durveshpathak1989/ESP32-FlightStack/GCS/releases/README.md

# Ground Station Releases

## v6.0.0

`ESP32-FlightStack-Configurator-macOS-arm64.zip` contains the Drone GCS configuration application for Apple silicon Macs running macOS 13 or newer.

SHA-256:

```text
48610249d2b40f928e59468a9a488147b9eb7e8fd887d89ad847a3eb90f0dd22
```

Extract the archive and open `Drone GCS.app`. The application is built for the `arm64` architecture.
