durveshpathak1989/ESP32-FlightStack/docs/ARCHITECTURE.md

# FlightStack Architecture

## Goal

The flight algorithms should be understandable and testable without knowing
ESP32, Arduino, FreeRTOS, Wi-Fi, or a particular sensor library. Hardware and
microcontrollers are replaceable adapters around a portable C++ flight core.

## Dependency rule

Dependencies point inward:

```text
Board entry point / scheduler
            ↓
Platform adapters (ESP32, STM32, RP2040, host simulator)
            ↓
Core ports (interfaces) ← Application orchestration
            ↓
Flight algorithms, controllers, and plain data types
```

The `Core` directory must never include Arduino, ESP32, FreeRTOS, Wi-Fi, or a
concrete device driver. Platform adapters may depend on the core, never the
reverse.

## Directory layout (implemented)

```text
RC_FlightController/src/
├── Core/                      portable data + port contracts
│   ├── FlightTypes.h
│   ├── Ports.h
│   └── ImuTypes.h             shared IMU plain-data structs
├── Cfg/
│   └── FlightConfig.h         beginner-facing defaults and pins
├── App/                       application layer (algorithms only)
│   ├── Control/PidController.h
│   ├── Filters/NotchFilter/
│   └── Estimation/{EKF, AHRS, MahonyAHRS, Madgwick}
├── Services/
│   ├── Com/WiFiTelemetry      HTTP telemetry, tuning, OTA
│   ├── Calibration/CalManager
│   ├── SignalProcessing/FFT
│   └── Diagnostics/{Logger, DebugConfig, ESP32Core}
├── EcuAbstraction/
│   ├── Sensors/{IMU, BMP280, GPS, ToF}
│   ├── Actuators/MotorControl
│   ├── Receiver/iFly
│   └── Power/BatteryMonitor
└── Mcal/                      ESP32 Arduino core API boundary today
```

## Swapping hardware

A hardware implementation supplies the relevant port from `Core/Ports.h`:

- New IMU: implement `ImuPort`.
- New radio: implement `ReceiverPort`.
- PWM, DShot, or another ESC protocol: implement `MotorPort`.
- ESP32 NVS, STM32 flash, or a file in simulation: implement
  `ConfigurationStorePort`.
- New MCU timer: implement `ClockPort` and provide a scheduler adapter.

No controller should include a concrete driver header.

## Swapping microcontrollers

Create a platform folder containing:

1. clock and scheduler adapters;
2. synchronization primitives;
3. persistent storage;
4. networking/diagnostic transport, if available;
5. the composition root that constructs adapters and passes their interfaces
   to the application.

The portable core is built unchanged. A board that has no Wi-Fi can use a null
diagnostic adapter or a serial implementation.

## Adding a controller

Controllers will implement a stable control interface and consume only a
snapshot of pilot command, estimated state, and configuration. They return a
normalized motor command. They do not read sensors, write motors, allocate
memory, use global state, or perform network operations.

Controller selection belongs in one registry in the application layer. Adding
a controller should require:

1. one controller class;
2. one registry entry;
3. one configuration schema entry;
4. host-side unit tests.

## Safety constraints during migration

- Preserve the 400 Hz control period and task priorities.
- Perform no heap allocation in the armed control path.
- Keep motor stop and failsafe behavior independent of optional services.
- Validate configuration at the boundary before it reaches a controller.
- Persist only versioned and checksummed records while disarmed.
- Compile and compare resource usage after every extraction.
- Refactoring commits must not alter gains or flight equations unless explicitly
  labeled and tested as behavioral changes.

## Current migration status

The layered refactor (branch `refactor/autosar-layered`) vendored all
submodules into an AUTOSAR-style tree: `App/`, `Services/`,
`EcuAbstraction/`, `Mcal/`, with portable types and port contracts in
`Core/` and configuration in `Cfg/`. See `docs/LAYERS.md` for the layer
contracts and sanctioned exceptions. `FlightConfig.h` is the single
beginner-facing location for board pins and safe defaults.
`PidController.h` is portable standard C++. Remaining work: move direct
driver calls in the sketch behind `EcuAbstraction` adapters, and wrap
ESP32 peripheral APIs in explicit `Mcal` primitives.
