durveshpathak1989/ESP32-FlightStack/PCB/ESP32_FlightController/manufacturing/final-2026-07-22-r3/drill/drill-report.txt

Drill report for ESP32_FlightController.kicad_pcb
Created on 2026-07-22T15:09:06

Copper Layer Stackup:
    =============================================================
    L1 :  F.Cu                      front
    L2 :  GND_PLANE                 in1
    L3 :  POWER_PLANE               in2
    L4 :  B.Cu                      back

Drill file 'ESP32_FlightController-PTH.drl' contains
    plated through holes:
    =============================================================
    T1  0.200mm  0.0079"  (9 holes))
    T2  0.300mm  0.0118"  (95 holes))
    T3  0.600mm  0.0236"  (4 holes)  (with 4 slots)
    T4  0.650mm  0.0256"  (12 holes))
    T5  2.150mm  0.0846"  (2 holes))

    Total plated holes count 122

Drill file 'ESP32_FlightController-front-in1.drl' contains
    holes connecting layer pair: 'F.Cu and GND_PLANE' (blind vias):
    =============================================================
    T1  0.100mm  0.0039"  (23 holes))

    Total plated holes count 23

Drill file 'ESP32_FlightController-back-in2.drl' contains
    holes connecting layer pair: 'B.Cu and POWER_PLANE' (buried vias):
    =============================================================
    T1  0.100mm  0.0039"  (6 holes))

    Total plated holes count 6

Drill file 'ESP32_FlightController-NPTH.drl' contains
    unplated through holes:
    =============================================================
    T1  0.650mm  0.0256"  (2 holes))
    T2  4.000mm  0.1575"  (4 holes))

    Total unplated holes count 6
