durveshpathak1989/ESP32-FlightStack/docs/PROMOTION.md

# ESP32-FlightStack Promotion Kit

Use this file when setting GitHub metadata, sharing the project, or posting release updates.

## Short Description

ESP32-FlightStack is an open-source ESP32 quadcopter flight-control stack with IMU sensor fusion, cascaded PID stabilization, motor mixing, telemetry, OTA updates, logging, calibration, and a browser-based ground station.

## GitHub Topics

```text
esp32
quadcopter
drone
uav
flight-controller
flight-control
embedded-c
esp-idf
arduino
freertos
pid-controller
imu
sensor-fusion
attitude-estimation
mpu9250
bmp280
madgwick-filter
motor-control
esc
```

## SEO Keywords

```text
ESP32 drone library
ESP32 quadcopter flight controller
open-source drone stack
DIY quadcopter firmware
ESP32 flight control system
embedded drone control
IMU sensor fusion library
PID stabilization controller
quadcopter attitude estimation
ESP32 UAV framework
```

## One-Line Pitch

An ESP32-based quadcopter flight-control stack for makers and embedded developers who want real-time control, sensor fusion, telemetry, and OTA updates in one open project.

## Longer Pitch

ESP32-FlightStack turns a low-cost ESP32 board into a serious quadcopter research platform. It combines a 400 Hz FreeRTOS control loop, MPU-9250 IMU support, EKF/Mahony/Madgwick attitude estimation, cascaded PID control, ESC motor mixing, Wi-Fi telemetry, runtime tuning, onboard CSV logging, sensor calibration, OTA firmware upload, and a browser-based ground station.

## Social Post

I am building ESP32-FlightStack, an open-source quadcopter flight-control stack for DIY drones and embedded-systems research. It includes sensor fusion, cascaded PID stabilization, motor mixing, telemetry, OTA updates, onboard logging, calibration, and a browser-based ground station, all running on an ESP32.

## Communities To Share With

- GitHub Topics: ESP32, drone, quadcopter, flight-controller, sensor-fusion
- Reddit: r/esp32, r/diydrones, r/Multicopter, r/embedded
- Hackaday.io project log
- Arduino Project Hub
- ESP32 and drone Discord communities
- LinkedIn posts focused on embedded systems, FreeRTOS, and control systems

## Suggested GitHub Metadata

Repository name: `ESP32-FlightStack`

Description:

```text
ESP32 quadcopter flight-control stack with IMU sensor fusion, PID stabilization, telemetry, OTA updates, logging, calibration, and a browser GCS.
```
