durveshpathak1989/ESP32-FlightStack/PCB/ESP32_FlightController/renders/connector-check-top.png

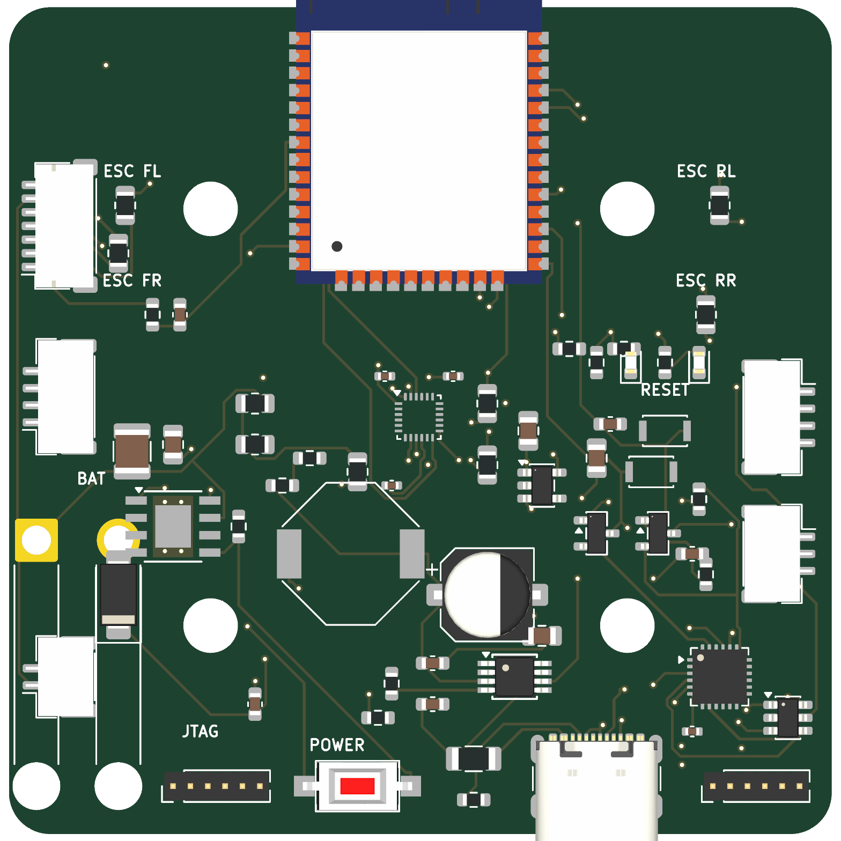
PCB/ESP32_FlightController/renders/connector-check-top.png
