durveshpathak1989/ESP32-FlightStack/3DPrints/StudSpacer-30mm.stl

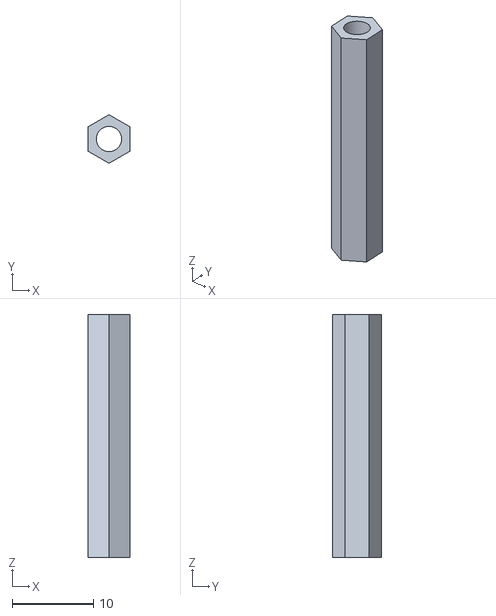
[picture p5: CAD file, 2026-05-16]
3DPrints/StudSpacer-30mm.stl
5.20 x 6.00 x 30.0
