durveshpathak1989/ESP32-FlightStack/3DPrints/StudSpacer-5mm.stl

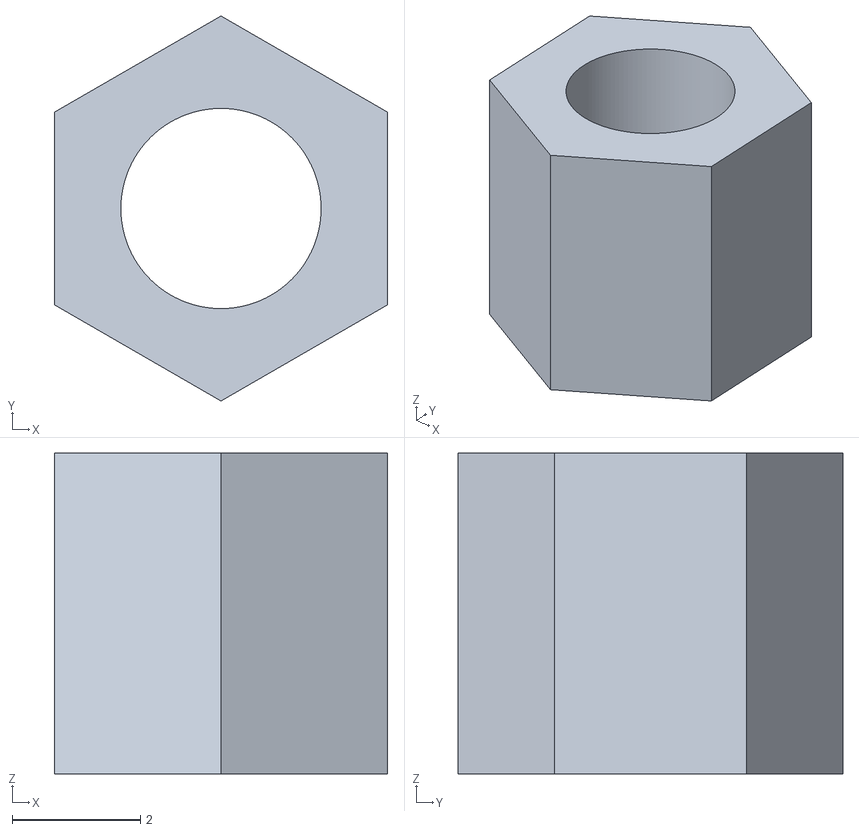
[picture p6: CAD file, 2026-05-16]
3DPrints/StudSpacer-5mm.stl
5.20 x 6.00 x 5.00
