durveshpathak1989/ESP32-FlightStack/3DPrints/StudSpacer-20mm.stl

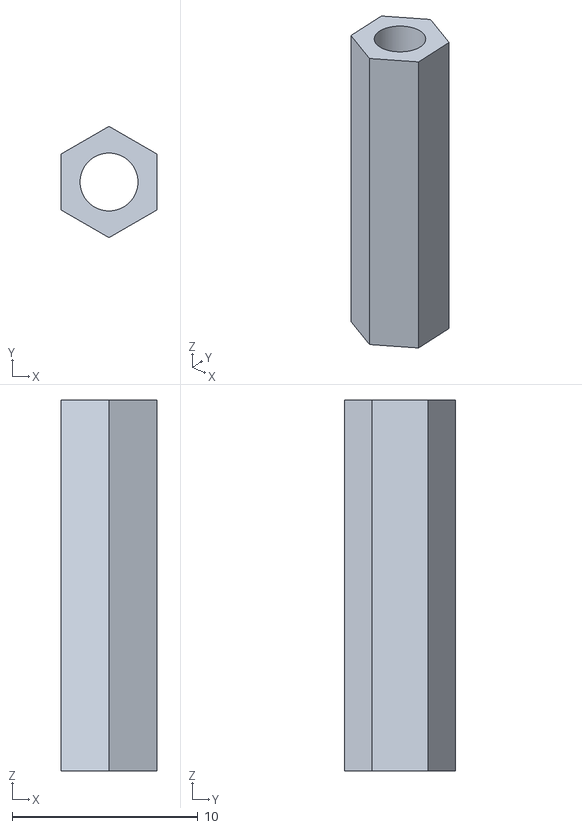
[picture p7: CAD file, 2026-05-16]
3DPrints/StudSpacer-20mm.stl
5.20 x 6.00 x 20.0
