durveshpathak1989/ESP32-FlightStack/3DPrints/StudSpacer-10mm.stl

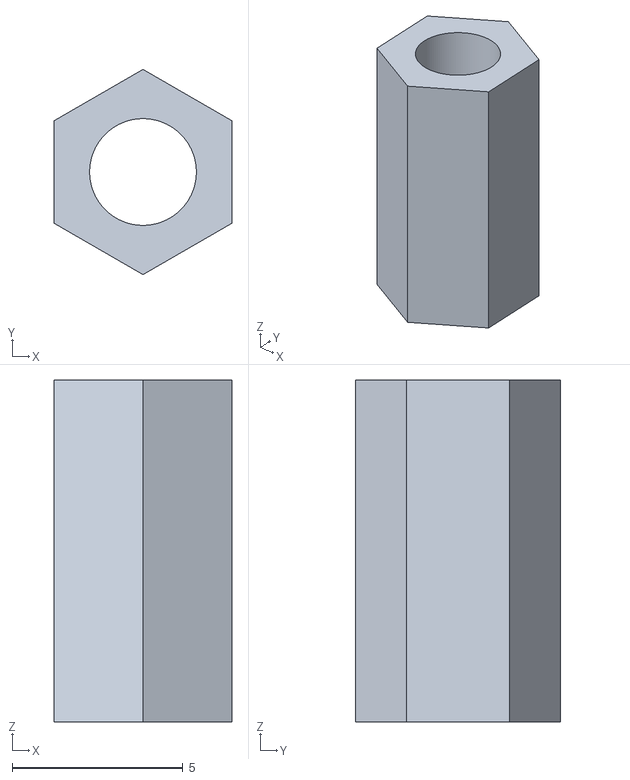
[picture p8: CAD file, 2026-05-16]
3DPrints/StudSpacer-10mm.stl
5.20 x 6.00 x 10.0
