durveshpathak1989/ESP32-FlightStack/RC_FlightController/build/BUILD_METRICS.md

# RC_FlightController Build Metrics

Generated: `2026-08-22T03:45:40.920803+00:00`
Source commit: `e3aa0521101f000fde28f85d92d8f98494c0851b`
Firmware: `RC_FlightController V6.1.0`
Build ID: `20260822T034345Z-master-e3aa0521101f`
Board: `ESP32 Dev Module`
Partition scheme: `min_spiffs` on 4 MB flash

| Variant | Flash used | Flash max | Flash % | RAM globals | RAM max | RAM % | RAM remaining |
|---|---:|---:|---:|---:|---:|---:|---:|
| Release | 1,146,599 | 1,966,080 | 58.0% | 77,596 | 327,680 | 23.0% | 250,084 |
| Debug | 1,158,147 | 1,966,080 | 58.0% | 77,604 | 327,680 | 23.0% | 250,076 |

See `build-metrics.json` for machine-readable details and `SHA256SUMS.txt` for binary integrity checks.
