durveshpathak1989/ESP32-FlightStack/PCB/ESP32_FlightController/manufacturing/final-2026-07-22-r3/review/board-bottom.png

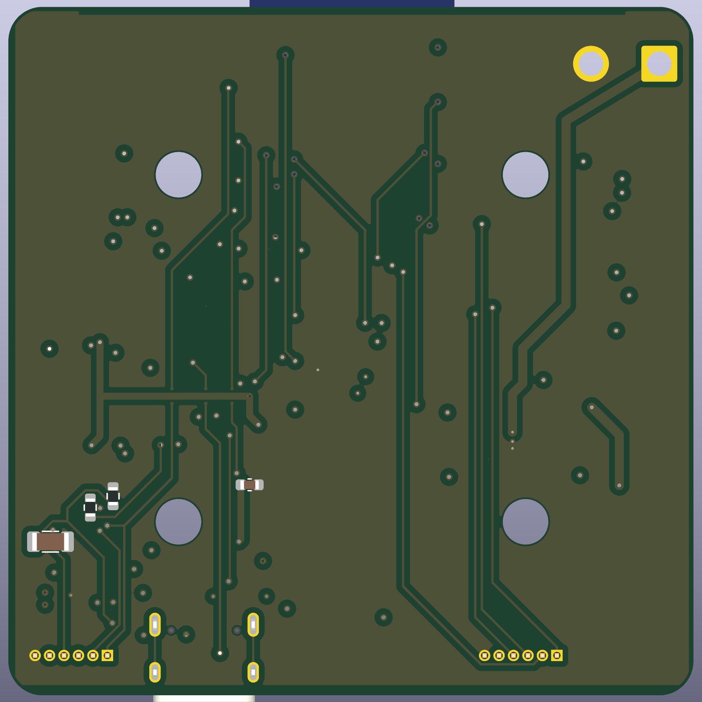
PCB/ESP32_FlightController/manufacturing/final-2026-07-22-r3/review/board-bottom.png
