durveshpathak1989/ESP32-FlightStack/Simulation/TestScreen_OTA_upload.html

# ESP32 Drone Ground Station | CONNECTING... | 0 rows ⏺ Start Logging ⬇ Download CSV ✕ Clear

Dashboard

Test 7.1 Timing

Test 7.2 RC Failsafe

Test 7.3 Telem Rate

Test 7.4 Calibration

Test 7.5 PID Tune

Test 7.6 BMP280

Test 7.7 CPU Load

OTA Firmware

### Mode

—

### Roll

—

degrees

### Pitch

—

degrees

### Yaw

—

degrees

### Throttle

—

### RC Hz

—

### Core 0

—

### Core 1

—

### BMP Temp

—

°C

### BMP Pressure

—

hPa

### BMP Altitude

—

m

### GPS

—

### IMU Loops

—

### WiFi Requests

—

### Motors

### FL (GPIO25 CCW)

—

### FR (GPIO15 CW)

—

### RL (GPIO14 CW)

—

### RR (GPIO32 CCW)

—

### 📋 Session Log 0 rows recorded

### Test 7.1 — IMU Loop Timing Characterization

Measures jitter of the 500 Hz IMU loop (target 2000 µs period). Run 5 minutes per condition. Reset stats between conditions.

Condition: Reset Stats Start 5-min Timer Download CSV

00:00

### Samples

—

### Period Mean

—

µs (target 2000)

### Period Std Dev

—

µs

### Jitter Mean

—

µs

### Jitter Max

—

µs

### Jitter p99

—

µs

### Violations (>100µs)

—

### Pass / Fail

—

### Results Table (fill in after each condition)

Condition | Samples | Period Mean µs | Std Dev µs | Jitter Mean µs | Jitter p99 µs | Jitter Max µs | Violations | Pass?
A — Idle | — | — | — | — | — | — | — | —
B — Polling | — | — | — | — | — | — | — | —
C — Stress | — | — | — | — | — | — | — | —

Save Current Row

### Test 7.2 — RC Frame Rate and Failsafe

Verify iBUS frames arrive at ~142 Hz and failsafe fires within 500 ms of TX off.

TX OFF — Start Timer Reset

Waiting for TX-OFF...

### RC Frame Rate

—

Hz (pass: 70–95)

### RC Valid

—

### Flight Mode

—

### Failsafe Detected

Waiting...

### Time to Failsafe

—

ms (pass: <500 ms)

### Result

—

### Pass Criteria

Check | Criterion | Measured | Pass?
RC frame rate | 70–95 Hz | — | —
Failsafe time | < 500 ms after TX off | — | —
Mode = FAILSAFE | Yes | — | —

### Test 7.3 — Telemetry Delivery Rate

Measures actual HTTP response rate over 60 seconds. Pass: ≥10 Hz, error rate <5%.

Start 60-sec Measurement Reset

00:00

### Successful Responses

—

### Errors

—

### Measured Rate

—

Hz (pass: ≥10)

### Error Rate

—

% (pass: <5%)

### Min Latency

—

ms

### Max Latency

—

ms

### Avg Latency

—

ms

### Result

—

### Test 7.4 — RC-Triggered Calibration

Verify field calibration works without USB. Trigger by flipping SWD (CH10) UP while disarmed.

Poll Log Now Clear

Waiting for calibration...

### Calibration Log (live from /log)

### Pass Criteria

Check | Required Log Message | Seen?
Triggered via SWD | [RC] Calibration requested — SWD flipped UP | No
Gyro complete | [CAL] ✓ GYRO done | No
Accel complete | [CAL] ✓ ACCEL done | No
Mag (or skipped) | [CAL] ✓ MAG done OR SKIPPED | No
Saved to NVS | [CAL] ✓ Calibration COMPLETE — saved to NVS | No

Overall: Incomplete

### Test 7.5 — Runtime Tuning Levers

Sends the full tuning set to /tune. Use while DISARMED first. This panel now covers pilot limits, PID authority, throttle shaping, rate PID, angle PID, yaw hold, Mahony AHRS, and ToF altitude hold.

### Command Limits

max_angle_deg

max_rate_dps

yaw_max_rate_dps

yaw_deadband

### Output Authority

roll_output_limit

pitch_output_limit

yaw_output_limit

### Throttle Shaping

throttle_expo

throttle_up_rate_per_sec

throttle_down_rate_per_sec

motor_idle

motor_max

throttle_cut

idle_ramp_end

### Rate PID

pid_roll_kp

pid_roll_ki

pid_roll_kd

pid_pitch_kp

pid_pitch_ki

pid_pitch_kd

pid_yaw_kp

pid_yaw_ki

pid_yaw_kd

### Angle PID

pid_angle_roll_kp

pid_angle_roll_ki

pid_angle_roll_kd

pid_angle_pitch_kp

pid_angle_pitch_ki

pid_angle_pitch_kd

### Yaw Hold

pid_angle_yaw_kp

### AHRS

mahony_kp

mahony_ki

### ToF Altitude Hold

alt_hold_kp

alt_hold_kd

alt_hold_max_trim

Send All Tuning Levers (Disarmed Test) Send While Armed Test

### Active Tuning Values (from /telemetry, if firmware exposes them)

### Max Angle

—

### Max Rate

—

### Roll Out Lim

—

### Thr Expo

—

### Roll Kp

—

### Roll Ki

—

### Roll Kd

—

### Pitch Kp

—

### Yaw Kp

—

### Ang Roll Kp

—

### Ang Pitch Kp

—

### Yaw Hold Kp

—

### Mahony Kp

—

### Mahony Ki

—

### Alt Hold Kp

—

### Alt Hold Kd

—

### Alt Max Trim

—

### Alt Hold State

—

### Pass Criteria

Test | Expected | Result | Pass?
Send while DISARMED | Tuning payload accepted, telemetry shows at least one changed value | — | —
Send while ARMED | Rejected — values unchanged | — | —

### Test 7.6 — BMP280 Barometer

Verify pressure and altitude readings are plausible. Lift drone ~1 m to check altitude response.

Snapshot at Current Height Snapshot at +1m Height Reset

### BMP Valid

—

### Temperature

—

°C

### Pressure

—

hPa

### Altitude (live)

—

m

### Baseline Alt

—

m (snapshotted)

### High Alt

—

m (snapshotted)

### Δ Altitude

—

m (expect ~1.0)

### Result

—

### Pass Criteria

Check | Criterion | Measured | Pass?
bmpValid = true | true | — | —
Temperature | 10–45 °C | — | —
Pressure | 950–1050 hPa | — | —
1m lift → ~1m delta | 0.5–2.0 m | — | —

### Test 7.7 — CPU Utilization Baseline

Record Core 0 and Core 1 load over 60 seconds. Pass: Core 1 <80%, neither core at 100%.

Start 60-sec Recording Reset Download CSV

00:00

### Core 0 Now

—

### Core 1 Now

—

### Core 0 Peak

—

### Core 1 Peak

—

### Core 0 Mean

—

### Core 1 Mean

—

### Samples

—

### Result

—

### Pass Criteria

Check | Criterion | Measured | Pass?
Core 0 peak | < 80% | — | —
Core 1 peak | < 80% | — | —
Neither core at 100% | Max < 100% | — | —

### OTA Firmware Upload

Upload the Arduino-exported ESP32 application .bin file to /update. Use only while DISARMED, throttle low, and motors stopped. Remove propellers during bench updates.

Target: http://192.168.4.1/update Safety: waiting for telemetry

⬆

Drop firmware .bin here or choose file

No file selected

Upload .bin to ESP32 Open /update Page

Waiting for .bin file.

### How to create the .bin from Arduino IDE

Step | Action
1 | Select the correct ESP32 board and port.
2 | Select an OTA-capable partition scheme, for example “Default 4MB with OTA”.
3 | Flash the OTA-capable firmware once over USB.
4 | Use Sketch → Export Compiled Binary.
5 | Use Sketch → Show Sketch Folder and pick the generated app .bin, typically YourSketch.ino.bin.
6 | Do not use bootloader, partitions, or merged factory .bin for this OTA upload.
