durveshpathak1989/ESP32-FlightStack/docs/images/testscreen-ota.png

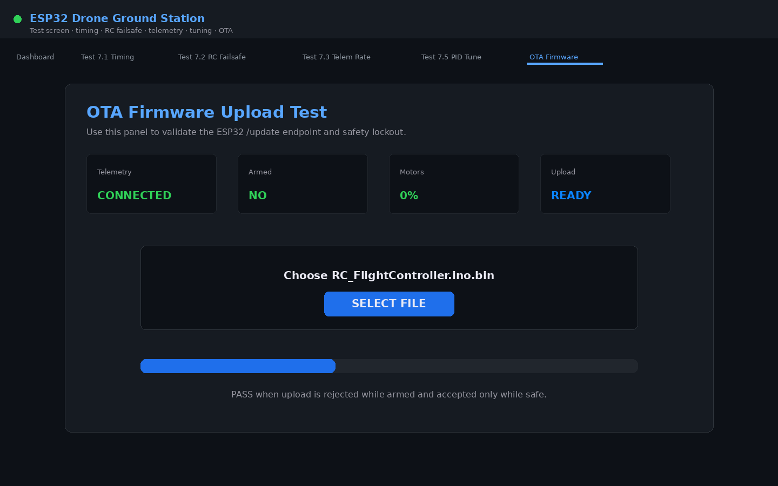
docs/images/testscreen-ota.png
