durveshpathak1989/ESP32-FlightStack/RC_FlightController/build/compile-debug.txt

/home/runner/work/ESP32-FlightStack/ESP32-FlightStack/RC_FlightController/RC_FlightController.ino: In function 'void updateExecTimingAndPrint(uint32_t, uint32_t, uint32_t, uint32_t)':
/home/runner/work/ESP32-FlightStack/ESP32-FlightStack/RC_FlightController/RC_FlightController.ino:133:22: warning: '++' expression of 'volatile'-qualified type is deprecated [-Wvolatile]
  133 |         g_execTiming.controlOverruns++;
      |         ~~~~~~~~~~~~~^~~~~~~~~~~~~~~
/home/runner/work/ESP32-FlightStack/ESP32-FlightStack/RC_FlightController/RC_FlightController.ino:137:22: warning: '++' expression of 'volatile'-qualified type is deprecated [-Wvolatile]
  137 |         g_execTiming.fullOverruns++;
      |         ~~~~~~~~~~~~~^~~~~~~~~~~~
/home/runner/work/ESP32-FlightStack/ESP32-FlightStack/RC_FlightController/RC_FlightController.ino: In function 'void updateControlTransitionCounters(const RCCommand&)':
/home/runner/work/ESP32-FlightStack/ESP32-FlightStack/RC_FlightController/RC_FlightController.ino:861:9: warning: '++' expression of 'volatile'-qualified type is deprecated [-Wvolatile]
  861 |         g_modeTransitionCount++;
      |         ^~~~~~~~~~~~~~~~~~~~~
/home/runner/work/ESP32-FlightStack/ESP32-FlightStack/RC_FlightController/RC_FlightController.ino:868:9: warning: '++' expression of 'volatile'-qualified type is deprecated [-Wvolatile]
  868 |         g_armingTransitionCount++;
      |         ^~~~~~~~~~~~~~~~~~~~~~~
/home/runner/work/ESP32-FlightStack/ESP32-FlightStack/RC_FlightController/RC_FlightController.ino:873:21: warning: '++' expression of 'volatile'-qualified type is deprecated [-Wvolatile]
  873 |     if (resetEvent) g_pidResetCount++;
      |                     ^~~~~~~~~~~~~~~
/home/runner/work/ESP32-FlightStack/ESP32-FlightStack/RC_FlightController/RC_FlightController.ino: In function 'bool handleTune(const TunePacket&)':
/home/runner/work/ESP32-FlightStack/ESP32-FlightStack/RC_FlightController/RC_FlightController.ino:1091:9: warning: '++' expression of 'volatile'-qualified type is deprecated [-Wvolatile]
 1091 |         g_tuneRejectSeq++;
      |         ^~~~~~~~~~~~~~~
/home/runner/work/ESP32-FlightStack/ESP32-FlightStack/RC_FlightController/RC_FlightController.ino:1097:9: warning: '++' expression of 'volatile'-qualified type is deprecated [-Wvolatile]
 1097 |         g_tuneRejectSeq++;
      |         ^~~~~~~~~~~~~~~
/home/runner/work/ESP32-FlightStack/ESP32-FlightStack/RC_FlightController/RC_FlightController.ino:1168:5: warning: '++' expression of 'volatile'-qualified type is deprecated [-Wvolatile]
 1168 |     g_tuneRequestSeq++;
      |     ^~~~~~~~~~~~~~~~
In file included from /home/runner/work/ESP32-FlightStack/ESP32-FlightStack/RC_FlightController/RC_FlightController.ino:52:
/home/runner/work/ESP32-FlightStack/ESP32-FlightStack/RC_FlightController/RC_FlightController.ino: In function 'void setup()':
/home/runner/work/ESP32-FlightStack/ESP32-FlightStack/RC_FlightController/RC_FlightController.ino:3236:16: warning: format '%u' expects argument of type 'unsigned int', but argument 3 has type 'uint32_t' {aka 'long unsigned int'} [-Wformat=]
 3236 |     DBG_PRINTF("[BOOT] Free heap: %u bytes\n", ESP.getFreeHeap());
      |                ^~~~~~~~~~~~~~~~~~~~~~~~~~~~~~  ~~~~~~~~~~~~~~~~~
      |                                                               |
      |                                                               uint32_t {aka long unsigned int}
/home/runner/work/ESP32-FlightStack/ESP32-FlightStack/RC_FlightController/src/Submodules/DebugConfig/DebugConfig.h:27:40: note: in definition of macro 'DBG_PRINTF'
   27 | #define DBG_PRINTF(...)  Serial.printf(__VA_ARGS__)
      |                                        ^~~~~~~~~~~
/home/runner/work/ESP32-FlightStack/ESP32-FlightStack/RC_FlightController/RC_FlightController.ino: At global scope:
/home/runner/work/ESP32-FlightStack/ESP32-FlightStack/RC_FlightController/RC_FlightController.ino:202:17: warning: 'g_lastDynamicNotchUpdateMs' defined but not used [-Wunused-variable]
  202 | static uint32_t g_lastDynamicNotchUpdateMs = 0;
      |                 ^~~~~~~~~~~~~~~~~~~~~~~~~~
/home/runner/work/ESP32-FlightStack/ESP32-FlightStack/RC_FlightController/RC_FlightController.ino:201:17: warning: 'g_dynamicNotchTracking' defined but not used [-Wunused-variable]
  201 | static bool     g_dynamicNotchTracking = false;
      |                 ^~~~~~~~~~~~~~~~~~~~~~
/home/runner/work/ESP32-FlightStack/ESP32-FlightStack/RC_FlightController/RC_FlightController.ino:200:17: warning: 'g_dynamicNotchHz' defined but not used [-Wunused-variable]
  200 | static float    g_dynamicNotchHz = TUNE_NOTCH_FREQ_HZ;
      |                 ^~~~~~~~~~~~~~~~
/home/runner/work/ESP32-FlightStack/ESP32-FlightStack/RC_FlightController/RC_FlightController.ino: In function 'void taskSerial(void*)':
/home/runner/work/ESP32-FlightStack/ESP32-FlightStack/RC_FlightController/src/Submodules/DebugConfig/DebugConfig.h:27:39: warning: 's.FlightState::roll_deg' may be used uninitialized [-Wmaybe-uninitialized]
   27 | #define DBG_PRINTF(...)  Serial.printf(__VA_ARGS__)
/home/runner/work/ESP32-FlightStack/ESP32-FlightStack/RC_FlightController/RC_FlightController.ino:2853:13: note: in expansion of macro 'DBG_PRINTF'
 2853 |             DBG_PRINTF("[%6lu] %s | RAW R=%+6.1f P=%+6.1f Y=%6.1f | "
      |             ^~~~~~~~~~
/home/runner/work/ESP32-FlightStack/ESP32-FlightStack/RC_FlightController/RC_FlightController.ino:2838:21: note: 's.FlightState::roll_deg' was declared here
 2838 |         FlightState s;
      |                     ^
/home/runner/work/ESP32-FlightStack/ESP32-FlightStack/RC_FlightController/src/Submodules/DebugConfig/DebugConfig.h:27:39: warning: 's.FlightState::pitch_deg' may be used uninitialized [-Wmaybe-uninitialized]
   27 | #define DBG_PRINTF(...)  Serial.printf(__VA_ARGS__)
/home/runner/work/ESP32-FlightStack/ESP32-FlightStack/RC_FlightController/RC_FlightController.ino:2853:13: note: in expansion of macro 'DBG_PRINTF'
 2853 |             DBG_PRINTF("[%6lu] %s | RAW R=%+6.1f P=%+6.1f Y=%6.1f | "
      |             ^~~~~~~~~~
/home/runner/work/ESP32-FlightStack/ESP32-FlightStack/RC_FlightController/RC_FlightController.ino:2838:21: note: 's.FlightState::pitch_deg' was declared here
 2838 |         FlightState s;
      |                     ^
/home/runner/work/ESP32-FlightStack/ESP32-FlightStack/RC_FlightController/src/Submodules/DebugConfig/DebugConfig.h:27:39: warning: 's.FlightState::yaw_deg' may be used uninitialized [-Wmaybe-uninitialized]
   27 | #define DBG_PRINTF(...)  Serial.printf(__VA_ARGS__)
/home/runner/work/ESP32-FlightStack/ESP32-FlightStack/RC_FlightController/RC_FlightController.ino:2853:13: note: in expansion of macro 'DBG_PRINTF'
 2853 |             DBG_PRINTF("[%6lu] %s | RAW R=%+6.1f P=%+6.1f Y=%6.1f | "
      |             ^~~~~~~~~~
/home/runner/work/ESP32-FlightStack/ESP32-FlightStack/RC_FlightController/RC_FlightController.ino:2838:21: note: 's.FlightState::yaw_deg' was declared here
 2838 |         FlightState s;
      |                     ^
/home/runner/work/ESP32-FlightStack/ESP32-FlightStack/RC_FlightController/src/Submodules/DebugConfig/DebugConfig.h:27:39: warning: 's.FlightState::ahrsFilterMode' may be used uninitialized [-Wmaybe-uninitialized]
   27 | #define DBG_PRINTF(...)  Serial.printf(__VA_ARGS__)
/home/runner/work/ESP32-FlightStack/ESP32-FlightStack/RC_FlightController/RC_FlightController.ino:2853:13: note: in expansion of macro 'DBG_PRINTF'
 2853 |             DBG_PRINTF("[%6lu] %s | RAW R=%+6.1f P=%+6.1f Y=%6.1f | "
      |             ^~~~~~~~~~
/home/runner/work/ESP32-FlightStack/ESP32-FlightStack/RC_FlightController/RC_FlightController.ino:2838:21: note: 's.FlightState::ahrsFilterMode' was declared here
 2838 |         FlightState s;
      |                     ^
/home/runner/work/ESP32-FlightStack/ESP32-FlightStack/RC_FlightController/src/Submodules/DebugConfig/DebugConfig.h:27:39: warning: 's.FlightState::roll_ctrl_deg' may be used uninitialized [-Wmaybe-uninitialized]
   27 | #define DBG_PRINTF(...)  Serial.printf(__VA_ARGS__)
/home/runner/work/ESP32-FlightStack/ESP32-FlightStack/RC_FlightController/RC_FlightController.ino:2853:13: note: in expansion of macro 'DBG_PRINTF'
 2853 |             DBG_PRINTF("[%6lu] %s | RAW R=%+6.1f P=%+6.1f Y=%6.1f | "
      |             ^~~~~~~~~~
/home/runner/work/ESP32-FlightStack/ESP32-FlightStack/RC_FlightController/RC_FlightController.ino:2838:21: note: 's.FlightState::roll_ctrl_deg' was declared here
 2838 |         FlightState s;
      |                     ^
/home/runner/work/ESP32-FlightStack/ESP32-FlightStack/RC_FlightController/src/Submodules/DebugConfig/DebugConfig.h:27:39: warning: 's.FlightState::pitch_ctrl_deg' may be used uninitialized [-Wmaybe-uninitialized]
   27 | #define DBG_PRINTF(...)  Serial.printf(__VA_ARGS__)
/home/runner/work/ESP32-FlightStack/ESP32-FlightStack/RC_FlightController/RC_FlightController.ino:2853:13: note: in expansion of macro 'DBG_PRINTF'
 2853 |             DBG_PRINTF("[%6lu] %s | RAW R=%+6.1f P=%+6.1f Y=%6.1f | "
      |             ^~~~~~~~~~
/home/runner/work/ESP32-FlightStack/ESP32-FlightStack/RC_FlightController/RC_FlightController.ino:2838:21: note: 's.FlightState::pitch_ctrl_deg' was declared here
 2838 |         FlightState s;
      |                     ^
/home/runner/work/ESP32-FlightStack/ESP32-FlightStack/RC_FlightController/src/Submodules/DebugConfig/DebugConfig.h:27:39: warning: 's.FlightState::yaw_ctrl_deg' may be used uninitialized [-Wmaybe-uninitialized]
   27 | #define DBG_PRINTF(...)  Serial.printf(__VA_ARGS__)
/home/runner/work/ESP32-FlightStack/ESP32-FlightStack/RC_FlightController/RC_FlightController.ino:2853:13: note: in expansion of macro 'DBG_PRINTF'
 2853 |             DBG_PRINTF("[%6lu] %s | RAW R=%+6.1f P=%+6.1f Y=%6.1f | "
      |             ^~~~~~~~~~
/home/runner/work/ESP32-FlightStack/ESP32-FlightStack/RC_FlightController/RC_FlightController.ino:2838:21: note: 's.FlightState::yaw_ctrl_deg' was declared here
 2838 |         FlightState s;
      |                     ^
/home/runner/work/ESP32-FlightStack/ESP32-FlightStack/RC_FlightController/src/Submodules/DebugConfig/DebugConfig.h:27:39: warning: 's.FlightState::roll_offset_deg' may be used uninitialized [-Wmaybe-uninitialized]
   27 | #define DBG_PRINTF(...)  Serial.printf(__VA_ARGS__)
/home/runner/work/ESP32-FlightStack/ESP32-FlightStack/RC_FlightController/RC_FlightController.ino:2853:13: note: in expansion of macro 'DBG_PRINTF'
 2853 |             DBG_PRINTF("[%6lu] %s | RAW R=%+6.1f P=%+6.1f Y=%6.1f | "
      |             ^~~~~~~~~~
/home/runner/work/ESP32-FlightStack/ESP32-FlightStack/RC_FlightController/RC_FlightController.ino:2838:21: note: 's.FlightState::roll_offset_deg' was declared here
 2838 |         FlightState s;
      |                     ^
/home/runner/work/ESP32-FlightStack/ESP32-FlightStack/RC_FlightController/src/Submodules/DebugConfig/DebugConfig.h:27:39: warning: 's.FlightState::pitch_offset_deg' may be used uninitialized [-Wmaybe-uninitialized]
   27 | #define DBG_PRINTF(...)  Serial.printf(__VA_ARGS__)
/home/runner/work/ESP32-FlightStack/ESP32-FlightStack/RC_FlightController/RC_FlightController.ino:2853:13: note: in expansion of macro 'DBG_PRINTF'
 2853 |             DBG_PRINTF("[%6lu] %s | RAW R=%+6.1f P=%+6.1f Y=%6.1f | "
      |             ^~~~~~~~~~
/home/runner/work/ESP32-FlightStack/ESP32-FlightStack/RC_FlightController/RC_FlightController.ino:2838:21: note: 's.FlightState::pitch_offset_deg' was declared here
 2838 |         FlightState s;
      |                     ^
/home/runner/work/ESP32-FlightStack/ESP32-FlightStack/RC_FlightController/src/Submodules/DebugConfig/DebugConfig.h:27:39: warning: 's.FlightState::yaw_offset_deg' may be used uninitialized [-Wmaybe-uninitialized]
   27 | #define DBG_PRINTF(...)  Serial.printf(__VA_ARGS__)
/home/runner/work/ESP32-FlightStack/ESP32-FlightStack/RC_FlightController/RC_FlightController.ino:2853:13: note: in expansion of macro 'DBG_PRINTF'
 2853 |             DBG_PRINTF("[%6lu] %s | RAW R=%+6.1f P=%+6.1f Y=%6.1f | "
      |             ^~~~~~~~~~
/home/runner/work/ESP32-FlightStack/ESP32-FlightStack/RC_FlightController/RC_FlightController.ino:2838:21: note: 's.FlightState::yaw_offset_deg' was declared here
 2838 |         FlightState s;
      |                     ^
/home/runner/work/ESP32-FlightStack/ESP32-FlightStack/RC_FlightController/src/Submodules/DebugConfig/DebugConfig.h:27:39: warning: 's.FlightState::ax_g' may be used uninitialized [-Wmaybe-uninitialized]
   27 | #define DBG_PRINTF(...)  Serial.printf(__VA_ARGS__)
/home/runner/work/ESP32-FlightStack/ESP32-FlightStack/RC_FlightController/RC_FlightController.ino:2883:13: note: in expansion of macro 'DBG_PRINTF'
 2883 |             DBG_PRINTF("          SENS: acc=%+.4f %+.4f %+.4f g | "
      |             ^~~~~~~~~~
/home/runner/work/ESP32-FlightStack/ESP32-FlightStack/RC_FlightController/RC_FlightController.ino:2838:21: note: 's.FlightState::ax_g' was declared here
 2838 |         FlightState s;
      |                     ^
/home/runner/work/ESP32-FlightStack/ESP32-FlightStack/RC_FlightController/src/Submodules/DebugConfig/DebugConfig.h:27:39: warning: 's.FlightState::ay_g' may be used uninitialized [-Wmaybe-uninitialized]
   27 | #define DBG_PRINTF(...)  Serial.printf(__VA_ARGS__)
/home/runner/work/ESP32-FlightStack/ESP32-FlightStack/RC_FlightController/RC_FlightController.ino:2883:13: note: in expansion of macro 'DBG_PRINTF'
 2883 |             DBG_PRINTF("          SENS: acc=%+.4f %+.4f %+.4f g | "
      |             ^~~~~~~~~~
/home/runner/work/ESP32-FlightStack/ESP32-FlightStack/RC_FlightController/RC_FlightController.ino:2838:21: note: 's.FlightState::ay_g' was declared here
 2838 |         FlightState s;
      |                     ^
/home/runner/work/ESP32-FlightStack/ESP32-FlightStack/RC_FlightController/src/Submodules/DebugConfig/DebugConfig.h:27:39: warning: 's.FlightState::az_g' may be used uninitialized [-Wmaybe-uninitialized]
   27 | #define DBG_PRINTF(...)  Serial.printf(__VA_ARGS__)
/home/runner/work/ESP32-FlightStack/ESP32-FlightStack/RC_FlightController/RC_FlightController.ino:2883:13: note: in expansion of macro 'DBG_PRINTF'
 2883 |             DBG_PRINTF("          SENS: acc=%+.4f %+.4f %+.4f g | "
      |             ^~~~~~~~~~
/home/runner/work/ESP32-FlightStack/ESP32-FlightStack/RC_FlightController/RC_FlightController.ino:2838:21: note: 's.FlightState::az_g' was declared here
 2838 |         FlightState s;
      |                     ^
/home/runner/work/ESP32-FlightStack/ESP32-FlightStack/RC_FlightController/src/Submodules/DebugConfig/DebugConfig.h:27:39: warning: 's.FlightState::gx_dps' may be used uninitialized [-Wmaybe-uninitialized]
   27 | #define DBG_PRINTF(...)  Serial.printf(__VA_ARGS__)
/home/runner/work/ESP32-FlightStack/ESP32-FlightStack/RC_FlightController/RC_FlightController.ino:2883:13: note: in expansion of macro 'DBG_PRINTF'
 2883 |             DBG_PRINTF("          SENS: acc=%+.4f %+.4f %+.4f g | "
      |             ^~~~~~~~~~
/home/runner/work/ESP32-FlightStack/ESP32-FlightStack/RC_FlightController/RC_FlightController.ino:2838:21: note: 's.FlightState::gx_dps' was declared here
 2838 |         FlightState s;
      |                     ^
/home/runner/work/ESP32-FlightStack/ESP32-FlightStack/RC_FlightController/src/Submodules/DebugConfig/DebugConfig.h:27:39: warning: 's.FlightState::gy_dps' may be used uninitialized [-Wmaybe-uninitialized]
   27 | #define DBG_PRINTF(...)  Serial.printf(__VA_ARGS__)
/home/runner/work/ESP32-FlightStack/ESP32-FlightStack/RC_FlightController/RC_FlightController.ino:2883:13: note: in expansion of macro 'DBG_PRINTF'
 2883 |             DBG_PRINTF("          SENS: acc=%+.4f %+.4f %+.4f g | "
      |             ^~~~~~~~~~
/home/runner/work/ESP32-FlightStack/ESP32-FlightStack/RC_FlightController/RC_FlightController.ino:2838:21: note: 's.FlightState::gy_dps' was declared here
 2838 |         FlightState s;
      |                     ^
/home/runner/work/ESP32-FlightStack/ESP32-FlightStack/RC_FlightController/src/Submodules/DebugConfig/DebugConfig.h:27:39: warning: 's.FlightState::gz_dps' may be used uninitialized [-Wmaybe-uninitialized]
   27 | #define DBG_PRINTF(...)  Serial.printf(__VA_ARGS__)
/home/runner/work/ESP32-FlightStack/ESP32-FlightStack/RC_FlightController/RC_FlightController.ino:2883:13: note: in expansion of macro 'DBG_PRINTF'
 2883 |             DBG_PRINTF("          SENS: acc=%+.4f %+.4f %+.4f g | "
      |             ^~~~~~~~~~
/home/runner/work/ESP32-FlightStack/ESP32-FlightStack/RC_FlightController/RC_FlightController.ino:2838:21: note: 's.FlightState::gz_dps' was declared here
 2838 |         FlightState s;
      |                     ^
/home/runner/work/ESP32-FlightStack/ESP32-FlightStack/RC_FlightController/RC_FlightController.ino:2879:53: warning: 's.FlightState::mx_uT' may be used uninitialized [-Wmaybe-uninitialized]
 2879 |             float magNorm = sqrtf(s.mx_uT * s.mx_uT +
      |                                   ~~~~~~~~~~~~~~~~~~^
 2880 |                       s.my_uT * s.my_uT +
      |                       ~~~~~~~~~~~~~~~~~              
/home/runner/work/ESP32-FlightStack/ESP32-FlightStack/RC_FlightController/RC_FlightController.ino:2838:21: note: 's.FlightState::mx_uT' was declared here
 2838 |         FlightState s;
      |                     ^
/home/runner/work/ESP32-FlightStack/ESP32-FlightStack/RC_FlightController/src/Submodules/DebugConfig/DebugConfig.h:27:39: warning: 's.FlightState::my_uT' may be used uninitialized [-Wmaybe-uninitialized]
   27 | #define DBG_PRINTF(...)  Serial.printf(__VA_ARGS__)
/home/runner/work/ESP32-FlightStack/ESP32-FlightStack/RC_FlightController/RC_FlightController.ino:2883:13: note: in expansion of macro 'DBG_PRINTF'
 2883 |             DBG_PRINTF("          SENS: acc=%+.4f %+.4f %+.4f g | "
      |             ^~~~~~~~~~
/home/runner/work/ESP32-FlightStack/ESP32-FlightStack/RC_FlightController/RC_FlightController.ino:2838:21: note: 's.FlightState::my_uT' was declared here
 2838 |         FlightState s;
      |                     ^
/home/runner/work/ESP32-FlightStack/ESP32-FlightStack/RC_FlightController/RC_FlightController.ino:2879:34: warning: 's.FlightState::mz_uT' may be used uninitialized [-Wmaybe-uninitialized]
 2879 |             float magNorm = sqrtf(s.mx_uT * s.mx_uT +
      |                             ~~~~~^~~~~~~~~~~~~~~~~~~~
 2880 |                       s.my_uT * s.my_uT +
      |                       ~~~~~~~~~~~~~~~~~~~
 2881 |                       s.mz_uT * s.mz_uT);
      |                       ~~~~~~~~~~~~~~~~~~
/home/runner/work/ESP32-FlightStack/ESP32-FlightStack/RC_FlightController/RC_FlightController.ino:2838:21: note: 's.FlightState::mz_uT' was declared here
 2838 |         FlightState s;
      |                     ^
/home/runner/work/ESP32-FlightStack/ESP32-FlightStack/RC_FlightController/src/Submodules/DebugConfig/DebugConfig.h:27:39: warning: 's.FlightState::bmpTemp_c' may be used uninitialized [-Wmaybe-uninitialized]
   27 | #define DBG_PRINTF(...)  Serial.printf(__VA_ARGS__)
/home/runner/work/ESP32-FlightStack/ESP32-FlightStack/RC_FlightController/RC_FlightController.ino:2853:13: note: in expansion of macro 'DBG_PRINTF'
 2853 |             DBG_PRINTF("[%6lu] %s | RAW R=%+6.1f P=%+6.1f Y=%6.1f | "
      |             ^~~~~~~~~~
/home/runner/work/ESP32-FlightStack/ESP32-FlightStack/RC_FlightController/RC_FlightController.ino:2838:21: note: 's.FlightState::bmpTemp_c' was declared here
 2838 |         FlightState s;
      |                     ^
/home/runner/work/ESP32-FlightStack/ESP32-FlightStack/RC_FlightController/src/Submodules/DebugConfig/DebugConfig.h:27:39: warning: 's.FlightState::bmpPressure_hpa' may be used uninitialized [-Wmaybe-uninitialized]
   27 | #define DBG_PRINTF(...)  Serial.printf(__VA_ARGS__)
/home/runner/work/ESP32-FlightStack/ESP32-FlightStack/RC_FlightController/RC_FlightController.ino:2853:13: note: in expansion of macro 'DBG_PRINTF'
 2853 |             DBG_PRINTF("[%6lu] %s | RAW R=%+6.1f P=%+6.1f Y=%6.1f | "
      |             ^~~~~~~~~~
/home/runner/work/ESP32-FlightStack/ESP32-FlightStack/RC_FlightController/RC_FlightController.ino:2838:21: note: 's.FlightState::bmpPressure_hpa' was declared here
 2838 |         FlightState s;
      |                     ^
/home/runner/work/ESP32-FlightStack/ESP32-FlightStack/RC_FlightController/src/Submodules/DebugConfig/DebugConfig.h:27:39: warning: 's.FlightState::bmpAltitude_m' may be used uninitialized [-Wmaybe-uninitialized]
   27 | #define DBG_PRINTF(...)  Serial.printf(__VA_ARGS__)
/home/runner/work/ESP32-FlightStack/ESP32-FlightStack/RC_FlightController/RC_FlightController.ino:2853:13: note: in expansion of macro 'DBG_PRINTF'
 2853 |             DBG_PRINTF("[%6lu] %s | RAW R=%+6.1f P=%+6.1f Y=%6.1f | "
      |             ^~~~~~~~~~
/home/runner/work/ESP32-FlightStack/ESP32-FlightStack/RC_FlightController/RC_FlightController.ino:2838:21: note: 's.FlightState::bmpAltitude_m' was declared here
 2838 |         FlightState s;
      |                     ^
/home/runner/work/ESP32-FlightStack/ESP32-FlightStack/RC_FlightController/src/Submodules/DebugConfig/DebugConfig.h:27:39: warning: 's.FlightState::tofDistance_m' may be used uninitialized [-Wmaybe-uninitialized]
   27 | #define DBG_PRINTF(...)  Serial.printf(__VA_ARGS__)
/home/runner/work/ESP32-FlightStack/ESP32-FlightStack/RC_FlightController/RC_FlightController.ino:2853:13: note: in expansion of macro 'DBG_PRINTF'
 2853 |             DBG_PRINTF("[%6lu] %s | RAW R=%+6.1f P=%+6.1f Y=%6.1f | "
      |             ^~~~~~~~~~
/home/runner/work/ESP32-FlightStack/ESP32-FlightStack/RC_FlightController/RC_FlightController.ino:2838:21: note: 's.FlightState::tofDistance_m' was declared here
 2838 |         FlightState s;
      |                     ^
/home/runner/work/ESP32-FlightStack/ESP32-FlightStack/RC_FlightController/src/Submodules/DebugConfig/DebugConfig.h:27:39: warning: 's.FlightState::tofObjectCount' may be used uninitialized [-Wmaybe-uninitialized]
   27 | #define DBG_PRINTF(...)  Serial.printf(__VA_ARGS__)
/home/runner/work/ESP32-FlightStack/ESP32-FlightStack/RC_FlightController/RC_FlightController.ino:2853:13: note: in expansion of macro 'DBG_PRINTF'
 2853 |             DBG_PRINTF("[%6lu] %s | RAW R=%+6.1f P=%+6.1f Y=%6.1f | "
      |             ^~~~~~~~~~
/home/runner/work/ESP32-FlightStack/ESP32-FlightStack/RC_FlightController/RC_FlightController.ino:2838:21: note: 's.FlightState::tofObjectCount' was declared here
 2838 |         FlightState s;
      |                     ^
/home/runner/work/ESP32-FlightStack/ESP32-FlightStack/RC_FlightController/src/Submodules/DebugConfig/DebugConfig.h:27:39: warning: 's.FlightState::tofAge_ms' may be used uninitialized [-Wmaybe-uninitialized]
   27 | #define DBG_PRINTF(...)  Serial.printf(__VA_ARGS__)
/home/runner/work/ESP32-FlightStack/ESP32-FlightStack/RC_FlightController/RC_FlightController.ino:2853:13: note: in expansion of macro 'DBG_PRINTF'
 2853 |             DBG_PRINTF("[%6lu] %s | RAW R=%+6.1f P=%+6.1f Y=%6.1f | "
      |             ^~~~~~~~~~
/home/runner/work/ESP32-FlightStack/ESP32-FlightStack/RC_FlightController/RC_FlightController.ino:2838:21: note: 's.FlightState::tofAge_ms' was declared here
 2838 |         FlightState s;
      |                     ^
/home/runner/work/ESP32-FlightStack/ESP32-FlightStack/RC_FlightController/RC_FlightController.ino:2867:50: warning: '*(unsigned char*)((char*)&s + offsetof(FlightState, FlightState::tofReady))' may be used uninitialized [-Wmaybe-uninitialized]
 2867 |                           s.tofValid ? "OK" : (s.tofReady ? "---" : "OFF"),
      |                                                ~~^~~~~~~~
/home/runner/work/ESP32-FlightStack/ESP32-FlightStack/RC_FlightController/src/Submodules/DebugConfig/DebugConfig.h:27:40: note: in definition of macro 'DBG_PRINTF'
   27 | #define DBG_PRINTF(...)  Serial.printf(__VA_ARGS__)
      |                                        ^~~~~~~~~~~
/home/runner/work/ESP32-FlightStack/ESP32-FlightStack/RC_FlightController/RC_FlightController.ino:2838:21: note: '*(unsigned char*)((char*)&s + offsetof(FlightState, FlightState::tofReady))' was declared here
 2838 |         FlightState s;
      |                     ^
/home/runner/work/ESP32-FlightStack/ESP32-FlightStack/RC_FlightController/RC_FlightController.ino:2867:29: warning: '*(unsigned char*)((char*)&s + offsetof(FlightState, FlightState::tofValid))' may be used uninitialized [-Wmaybe-uninitialized]
 2867 |                           s.tofValid ? "OK" : (s.tofReady ? "---" : "OFF"),
      |                           ~~^~~~~~~~
/home/runner/work/ESP32-FlightStack/ESP32-FlightStack/RC_FlightController/src/Submodules/DebugConfig/DebugConfig.h:27:40: note: in definition of macro 'DBG_PRINTF'
   27 | #define DBG_PRINTF(...)  Serial.printf(__VA_ARGS__)
      |                                        ^~~~~~~~~~~
/home/runner/work/ESP32-FlightStack/ESP32-FlightStack/RC_FlightController/RC_FlightController.ino:2838:21: note: '*(unsigned char*)((char*)&s + offsetof(FlightState, FlightState::tofValid))' was declared here
 2838 |         FlightState s;
      |                     ^
/home/runner/work/ESP32-FlightStack/ESP32-FlightStack/RC_FlightController/src/Submodules/DebugConfig/DebugConfig.h:27:39: warning: 's.FlightState::motorFL' may be used uninitialized [-Wmaybe-uninitialized]
   27 | #define DBG_PRINTF(...)  Serial.printf(__VA_ARGS__)
/home/runner/work/ESP32-FlightStack/ESP32-FlightStack/RC_FlightController/RC_FlightController.ino:2853:13: note: in expansion of macro 'DBG_PRINTF'
 2853 |             DBG_PRINTF("[%6lu] %s | RAW R=%+6.1f P=%+6.1f Y=%6.1f | "
      |             ^~~~~~~~~~
/home/runner/work/ESP32-FlightStack/ESP32-FlightStack/RC_FlightController/RC_FlightController.ino:2838:21: note: 's.FlightState::motorFL' was declared here
 2838 |         FlightState s;
      |                     ^
/home/runner/work/ESP32-FlightStack/ESP32-FlightStack/RC_FlightController/src/Submodules/DebugConfig/DebugConfig.h:27:39: warning: 's.FlightState::motorFR' may be used uninitialized [-Wmaybe-uninitialized]
   27 | #define DBG_PRINTF(...)  Serial.printf(__VA_ARGS__)
/home/runner/work/ESP32-FlightStack/ESP32-FlightStack/RC_FlightController/RC_FlightController.ino:2853:13: note: in expansion of macro 'DBG_PRINTF'
 2853 |             DBG_PRINTF("[%6lu] %s | RAW R=%+6.1f P=%+6.1f Y=%6.1f | "
      |             ^~~~~~~~~~
/home/runner/work/ESP32-FlightStack/ESP32-FlightStack/RC_FlightController/RC_FlightController.ino:2838:21: note: 's.FlightState::motorFR' was declared here
 2838 |         FlightState s;
      |                     ^
/home/runner/work/ESP32-FlightStack/ESP32-FlightStack/RC_FlightController/src/Submodules/DebugConfig/DebugConfig.h:27:39: warning: 's.FlightState::motorRL' may be used uninitialized [-Wmaybe-uninitialized]
   27 | #define DBG_PRINTF(...)  Serial.printf(__VA_ARGS__)
/home/runner/work/ESP32-FlightStack/ESP32-FlightStack/RC_FlightController/RC_FlightController.ino:2853:13: note: in expansion of macro 'DBG_PRINTF'
 2853 |             DBG_PRINTF("[%6lu] %s | RAW R=%+6.1f P=%+6.1f Y=%6.1f | "
      |             ^~~~~~~~~~
/home/runner/work/ESP32-FlightStack/ESP32-FlightStack/RC_FlightController/RC_FlightController.ino:2838:21: note: 's.FlightState::motorRL' was declared here
 2838 |         FlightState s;
      |                     ^
/home/runner/work/ESP32-FlightStack/ESP32-FlightStack/RC_FlightController/src/Submodules/DebugConfig/DebugConfig.h:27:39: warning: 's.FlightState::motorRR' may be used uninitialized [-Wmaybe-uninitialized]
   27 | #define DBG_PRINTF(...)  Serial.printf(__VA_ARGS__)
/home/runner/work/ESP32-FlightStack/ESP32-FlightStack/RC_FlightController/RC_FlightController.ino:2853:13: note: in expansion of macro 'DBG_PRINTF'
 2853 |             DBG_PRINTF("[%6lu] %s | RAW R=%+6.1f P=%+6.1f Y=%6.1f | "
      |             ^~~~~~~~~~
/home/runner/work/ESP32-FlightStack/ESP32-FlightStack/RC_FlightController/RC_FlightController.ino:2838:21: note: 's.FlightState::motorRR' was declared here
 2838 |         FlightState s;
      |                     ^
/home/runner/work/ESP32-FlightStack/ESP32-FlightStack/RC_FlightController/src/Submodules/DebugConfig/DebugConfig.h:27:39: warning: 's.FlightState::pidRollOut' may be used uninitialized [-Wmaybe-uninitialized]
   27 | #define DBG_PRINTF(...)  Serial.printf(__VA_ARGS__)
/home/runner/work/ESP32-FlightStack/ESP32-FlightStack/RC_FlightController/RC_FlightController.ino:2894:13: note: in expansion of macro 'DBG_PRINTF'
 2894 |             DBG_PRINTF("[PID] %s | cmd r=%+.2f p=%+.2f y=%+.2f | "
      |             ^~~~~~~~~~
/home/runner/work/ESP32-FlightStack/ESP32-FlightStack/RC_FlightController/RC_FlightController.ino:2838:21: note: 's.FlightState::pidRollOut' was declared here
 2838 |         FlightState s;
      |                     ^
/home/runner/work/ESP32-FlightStack/ESP32-FlightStack/RC_FlightController/src/Submodules/DebugConfig/DebugConfig.h:27:39: warning: 's.FlightState::pidPitchOut' may be used uninitialized [-Wmaybe-uninitialized]
   27 | #define DBG_PRINTF(...)  Serial.printf(__VA_ARGS__)
/home/runner/work/ESP32-FlightStack/ESP32-FlightStack/RC_FlightController/RC_FlightController.ino:2894:13: note: in expansion of macro 'DBG_PRINTF'
 2894 |             DBG_PRINTF("[PID] %s | cmd r=%+.2f p=%+.2f y=%+.2f | "
      |             ^~~~~~~~~~
/home/runner/work/ESP32-FlightStack/ESP32-FlightStack/RC_FlightController/RC_FlightController.ino:2838:21: note: 's.FlightState::pidPitchOut' was declared here
 2838 |         FlightState s;
      |                     ^
/home/runner/work/ESP32-FlightStack/ESP32-FlightStack/RC_FlightController/src/Submodules/DebugConfig/DebugConfig.h:27:39: warning: 's.FlightState::pidYawOut' may be used uninitialized [-Wmaybe-uninitialized]
   27 | #define DBG_PRINTF(...)  Serial.printf(__VA_ARGS__)
/home/runner/work/ESP32-FlightStack/ESP32-FlightStack/RC_FlightController/RC_FlightController.ino:2894:13: note: in expansion of macro 'DBG_PRINTF'
 2894 |             DBG_PRINTF("[PID] %s | cmd r=%+.2f p=%+.2f y=%+.2f | "
      |             ^~~~~~~~~~
/home/runner/work/ESP32-FlightStack/ESP32-FlightStack/RC_FlightController/RC_FlightController.ino:2838:21: note: 's.FlightState::pidYawOut' was declared here
 2838 |         FlightState s;
      |                     ^
/home/runner/work/ESP32-FlightStack/ESP32-FlightStack/RC_FlightController/src/Submodules/DebugConfig/DebugConfig.h:27:39: warning: 's.FlightState::rc.RCCommand::roll' may be used uninitialized [-Wmaybe-uninitialized]
   27 | #define DBG_PRINTF(...)  Serial.printf(__VA_ARGS__)
/home/runner/work/ESP32-FlightStack/ESP32-FlightStack/RC_FlightController/RC_FlightController.ino:2894:13: note: in expansion of macro 'DBG_PRINTF'
 2894 |             DBG_PRINTF("[PID] %s | cmd r=%+.2f p=%+.2f y=%+.2f | "
      |             ^~~~~~~~~~
/home/runner/work/ESP32-FlightStack/ESP32-FlightStack/RC_FlightController/RC_FlightController.ino:2838:21: note: 's.FlightState::rc.RCCommand::roll' was declared here
 2838 |         FlightState s;
      |                     ^
/home/runner/work/ESP32-FlightStack/ESP32-FlightStack/RC_FlightController/src/Submodules/DebugConfig/DebugConfig.h:27:39: warning: 's.FlightState::rc.RCCommand::pitch' may be used uninitialized [-Wmaybe-uninitialized]
   27 | #define DBG_PRINTF(...)  Serial.printf(__VA_ARGS__)
/home/runner/work/ESP32-FlightStack/ESP32-FlightStack/RC_FlightController/RC_FlightController.ino:2894:13: note: in expansion of macro 'DBG_PRINTF'
 2894 |             DBG_PRINTF("[PID] %s | cmd r=%+.2f p=%+.2f y=%+.2f | "
      |             ^~~~~~~~~~
/home/runner/work/ESP32-FlightStack/ESP32-FlightStack/RC_FlightController/RC_FlightController.ino:2838:21: note: 's.FlightState::rc.RCCommand::pitch' was declared here
 2838 |         FlightState s;
      |                     ^
/home/runner/work/ESP32-FlightStack/ESP32-FlightStack/RC_FlightController/src/Submodules/DebugConfig/DebugConfig.h:27:39: warning: 's.FlightState::rc.RCCommand::yaw' may be used uninitialized [-Wmaybe-uninitialized]
   27 | #define DBG_PRINTF(...)  Serial.printf(__VA_ARGS__)
/home/runner/work/ESP32-FlightStack/ESP32-FlightStack/RC_FlightController/RC_FlightController.ino:2894:13: note: in expansion of macro 'DBG_PRINTF'
 2894 |             DBG_PRINTF("[PID] %s | cmd r=%+.2f p=%+.2f y=%+.2f | "
      |             ^~~~~~~~~~
/home/runner/work/ESP32-FlightStack/ESP32-FlightStack/RC_FlightController/RC_FlightController.ino:2838:21: note: 's.FlightState::rc.RCCommand::yaw' was declared here
 2838 |         FlightState s;
      |                     ^
/home/runner/work/ESP32-FlightStack/ESP32-FlightStack/RC_FlightController/RC_FlightController.ino:2844:9: warning: '*(unsigned char*)((char*)&s + offsetof(FlightState, FlightState::rc.RCCommand::mode))' may be used uninitialized [-Wmaybe-uninitialized]
 2844 |         switch(s.rc.mode) {
      |         ^~~~~~
/home/runner/work/ESP32-FlightStack/ESP32-FlightStack/RC_FlightController/RC_FlightController.ino:2838:21: note: '*(unsigned char*)((char*)&s + offsetof(FlightState, FlightState::rc.RCCommand::mode))' was declared here
 2838 |         FlightState s;
      |                     ^
/home/runner/work/ESP32-FlightStack/ESP32-FlightStack/RC_FlightController/src/Submodules/DebugConfig/DebugConfig.h:27:39: warning: 's.FlightState::rc.RCCommand::raw[0]' may be used uninitialized [-Wmaybe-uninitialized]
   27 | #define DBG_PRINTF(...)  Serial.printf(__VA_ARGS__)
/home/runner/work/ESP32-FlightStack/ESP32-FlightStack/RC_FlightController/RC_FlightController.ino:2875:13: note: in expansion of macro 'DBG_PRINTF'
 2875 |             DBG_PRINTF("          CH: 1=%4u 2=%4u 3=%4u 4=%4u 5=%4u 6=%4u 7=%4u 8=%4u 9=%4u 10=%4u\n",
      |             ^~~~~~~~~~
/home/runner/work/ESP32-FlightStack/ESP32-FlightStack/RC_FlightController/RC_FlightController.ino:2838:21: note: 's.FlightState::rc.RCCommand::raw[0]' was declared here
 2838 |         FlightState s;
      |                     ^
/home/runner/work/ESP32-FlightStack/ESP32-FlightStack/RC_FlightController/src/Submodules/DebugConfig/DebugConfig.h:27:39: warning: 's.FlightState::rc.RCCommand::raw[1]' may be used uninitialized [-Wmaybe-uninitialized]
   27 | #define DBG_PRINTF(...)  Serial.printf(__VA_ARGS__)
/home/runner/work/ESP32-FlightStack/ESP32-FlightStack/RC_FlightController/RC_FlightController.ino:2875:13: note: in expansion of macro 'DBG_PRINTF'
 2875 |             DBG_PRINTF("          CH: 1=%4u 2=%4u 3=%4u 4=%4u 5=%4u 6=%4u 7=%4u 8=%4u 9=%4u 10=%4u\n",
      |             ^~~~~~~~~~
/home/runner/work/ESP32-FlightStack/ESP32-FlightStack/RC_FlightController/RC_FlightController.ino:2838:21: note: 's.FlightState::rc.RCCommand::raw[1]' was declared here
 2838 |         FlightState s;
      |                     ^
/home/runner/work/ESP32-FlightStack/ESP32-FlightStack/RC_FlightController/src/Submodules/DebugConfig/DebugConfig.h:27:39: warning: 's.FlightState::rc.RCCommand::raw[2]' may be used uninitialized [-Wmaybe-uninitialized]
   27 | #define DBG_PRINTF(...)  Serial.printf(__VA_ARGS__)
/home/runner/work/ESP32-FlightStack/ESP32-FlightStack/RC_FlightController/RC_FlightController.ino:2875:13: note: in expansion of macro 'DBG_PRINTF'
 2875 |             DBG_PRINTF("          CH: 1=%4u 2=%4u 3=%4u 4=%4u 5=%4u 6=%4u 7=%4u 8=%4u 9=%4u 10=%4u\n",
      |             ^~~~~~~~~~
/home/runner/work/ESP32-FlightStack/ESP32-FlightStack/RC_FlightController/RC_FlightController.ino:2838:21: note: 's.FlightState::rc.RCCommand::raw[2]' was declared here
 2838 |         FlightState s;
      |                     ^
/home/runner/work/ESP32-FlightStack/ESP32-FlightStack/RC_FlightController/src/Submodules/DebugConfig/DebugConfig.h:27:39: warning: 's.FlightState::rc.RCCommand::raw[3]' may be used uninitialized [-Wmaybe-uninitialized]
   27 | #define DBG_PRINTF(...)  Serial.printf(__VA_ARGS__)
/home/runner/work/ESP32-FlightStack/ESP32-FlightStack/RC_FlightController/RC_FlightController.ino:2875:13: note: in expansion of macro 'DBG_PRINTF'
 2875 |             DBG_PRINTF("          CH: 1=%4u 2=%4u 3=%4u 4=%4u 5=%4u 6=%4u 7=%4u 8=%4u 9=%4u 10=%4u\n",
      |             ^~~~~~~~~~
/home/runner/work/ESP32-FlightStack/ESP32-FlightStack/RC_FlightController/RC_FlightController.ino:2838:21: note: 's.FlightState::rc.RCCommand::raw[3]' was declared here
 2838 |         FlightState s;
      |                     ^
/home/runner/work/ESP32-FlightStack/ESP32-FlightStack/RC_FlightController/src/Submodules/DebugConfig/DebugConfig.h:27:39: warning: 's.FlightState::rc.RCCommand::raw[4]' may be used uninitialized [-Wmaybe-uninitialized]
   27 | #define DBG_PRINTF(...)  Serial.printf(__VA_ARGS__)
/home/runner/work/ESP32-FlightStack/ESP32-FlightStack/RC_FlightController/RC_FlightController.ino:2875:13: note: in expansion of macro 'DBG_PRINTF'
 2875 |             DBG_PRINTF("          CH: 1=%4u 2=%4u 3=%4u 4=%4u 5=%4u 6=%4u 7=%4u 8=%4u 9=%4u 10=%4u\n",
      |             ^~~~~~~~~~
/home/runner/work/ESP32-FlightStack/ESP32-FlightStack/RC_FlightController/RC_FlightController.ino:2838:21: note: 's.FlightState::rc.RCCommand::raw[4]' was declared here
 2838 |         FlightState s;
      |                     ^
/home/runner/work/ESP32-FlightStack/ESP32-FlightStack/RC_FlightController/src/Submodules/DebugConfig/DebugConfig.h:27:39: warning: 's.FlightState::rc.RCCommand::raw[5]' may be used uninitialized [-Wmaybe-uninitialized]
   27 | #define DBG_PRINTF(...)  Serial.printf(__VA_ARGS__)
/home/runner/work/ESP32-FlightStack/ESP32-FlightStack/RC_FlightController/RC_FlightController.ino:2875:13: note: in expansion of macro 'DBG_PRINTF'
 2875 |             DBG_PRINTF("          CH: 1=%4u 2=%4u 3=%4u 4=%4u 5=%4u 6=%4u 7=%4u 8=%4u 9=%4u 10=%4u\n",
      |             ^~~~~~~~~~
/home/runner/work/ESP32-FlightStack/ESP32-FlightStack/RC_FlightController/RC_FlightController.ino:2838:21: note: 's.FlightState::rc.RCCommand::raw[5]' was declared here
 2838 |         FlightState s;
      |                     ^
/home/runner/work/ESP32-FlightStack/ESP32-FlightStack/RC_FlightController/src/Submodules/DebugConfig/DebugConfig.h:27:39: warning: 's.FlightState::rc.RCCommand::raw[6]' may be used uninitialized [-Wmaybe-uninitialized]
   27 | #define DBG_PRINTF(...)  Serial.printf(__VA_ARGS__)
/home/runner/work/ESP32-FlightStack/ESP32-FlightStack/RC_FlightController/RC_FlightController.ino:2875:13: note: in expansion of macro 'DBG_PRINTF'
 2875 |             DBG_PRINTF("          CH: 1=%4u 2=%4u 3=%4u 4=%4u 5=%4u 6=%4u 7=%4u 8=%4u 9=%4u 10=%4u\n",
      |             ^~~~~~~~~~
/home/runner/work/ESP32-FlightStack/ESP32-FlightStack/RC_FlightController/RC_FlightController.ino:2838:21: note: 's.FlightState::rc.RCCommand::raw[6]' was declared here
 2838 |         FlightState s;
      |                     ^
/home/runner/work/ESP32-FlightStack/ESP32-FlightStack/RC_FlightController/src/Submodules/DebugConfig/DebugConfig.h:27:39: warning: 's.FlightState::rc.RCCommand::raw[7]' may be used uninitialized [-Wmaybe-uninitialized]
   27 | #define DBG_PRINTF(...)  Serial.printf(__VA_ARGS__)
/home/runner/work/ESP32-FlightStack/ESP32-FlightStack/RC_FlightController/RC_FlightController.ino:2875:13: note: in expansion of macro 'DBG_PRINTF'
 2875 |             DBG_PRINTF("          CH: 1=%4u 2=%4u 3=%4u 4=%4u 5=%4u 6=%4u 7=%4u 8=%4u 9=%4u 10=%4u\n",
      |             ^~~~~~~~~~
/home/runner/work/ESP32-FlightStack/ESP32-FlightStack/RC_FlightController/RC_FlightController.ino:2838:21: note: 's.FlightState::rc.RCCommand::raw[7]' was declared here
 2838 |         FlightState s;
      |                     ^
/home/runner/work/ESP32-FlightStack/ESP32-FlightStack/RC_FlightController/src/Submodules/DebugConfig/DebugConfig.h:27:39: warning: 's.FlightState::rc.RCCommand::raw[8]' may be used uninitialized [-Wmaybe-uninitialized]
   27 | #define DBG_PRINTF(...)  Serial.printf(__VA_ARGS__)
/home/runner/work/ESP32-FlightStack/ESP32-FlightStack/RC_FlightController/RC_FlightController.ino:2875:13: note: in expansion of macro 'DBG_PRINTF'
 2875 |             DBG_PRINTF("          CH: 1=%4u 2=%4u 3=%4u 4=%4u 5=%4u 6=%4u 7=%4u 8=%4u 9=%4u 10=%4u\n",
      |             ^~~~~~~~~~
/home/runner/work/ESP32-FlightStack/ESP32-FlightStack/RC_FlightController/RC_FlightController.ino:2838:21: note: 's.FlightState::rc.RCCommand::raw[8]' was declared here
 2838 |         FlightState s;
      |                     ^
/home/runner/work/ESP32-FlightStack/ESP32-FlightStack/RC_FlightController/src/Submodules/DebugConfig/DebugConfig.h:27:39: warning: 's.FlightState::rc.RCCommand::raw[9]' may be used uninitialized [-Wmaybe-uninitialized]
   27 | #define DBG_PRINTF(...)  Serial.printf(__VA_ARGS__)
/home/runner/work/ESP32-FlightStack/ESP32-FlightStack/RC_FlightController/RC_FlightController.ino:2875:13: note: in expansion of macro 'DBG_PRINTF'
 2875 |             DBG_PRINTF("          CH: 1=%4u 2=%4u 3=%4u 4=%4u 5=%4u 6=%4u 7=%4u 8=%4u 9=%4u 10=%4u\n",
      |             ^~~~~~~~~~
/home/runner/work/ESP32-FlightStack/ESP32-FlightStack/RC_FlightController/RC_FlightController.ino:2838:21: note: 's.FlightState::rc.RCCommand::raw[9]' was declared here
 2838 |         FlightState s;
      |                     ^
/home/runner/work/ESP32-FlightStack/ESP32-FlightStack/RC_FlightController/RC_FlightController.ino:2893:29: warning: '*(unsigned char*)((char*)&s + offsetof(FlightState, FlightState::armed))' may be used uninitialized [-Wmaybe-uninitialized]
 2893 |         if (g_pidTrace && s.armed && (tick % 5 == 0)) {
      |                           ~~^~~~~
/home/runner/work/ESP32-FlightStack/ESP32-FlightStack/RC_FlightController/RC_FlightController.ino:2838:21: note: '*(unsigned char*)((char*)&s + offsetof(FlightState, FlightState::armed))' was declared here
 2838 |         FlightState s;
      |                     ^
/home/runner/work/ESP32-FlightStack/ESP32-FlightStack/RC_FlightController/src/Submodules/DebugConfig/DebugConfig.h:27:39: warning: 's.FlightState::gps.GPSData::satellites' may be used uninitialized [-Wmaybe-uninitialized]
   27 | #define DBG_PRINTF(...)  Serial.printf(__VA_ARGS__)
/home/runner/work/ESP32-FlightStack/ESP32-FlightStack/RC_FlightController/RC_FlightController.ino:2853:13: note: in expansion of macro 'DBG_PRINTF'
 2853 |             DBG_PRINTF("[%6lu] %s | RAW R=%+6.1f P=%+6.1f Y=%6.1f | "
      |             ^~~~~~~~~~
/home/runner/work/ESP32-FlightStack/ESP32-FlightStack/RC_FlightController/RC_FlightController.ino:2838:21: note: 's.FlightState::gps.GPSData::satellites' was declared here
 2838 |         FlightState s;
      |                     ^
/home/runner/work/ESP32-FlightStack/ESP32-FlightStack/RC_FlightController/RC_FlightController.ino:2871:33: warning: '*(unsigned char*)((char*)&s + offsetof(FlightState, FlightState::gps.GPSData::valid))' may be used uninitialized [-Wmaybe-uninitialized]
 2871 |                           s.gps.valid ? "FIX" : "---", s.gps.satellites,
      |                           ~~~~~~^~~~~
/home/runner/work/ESP32-FlightStack/ESP32-FlightStack/RC_FlightController/src/Submodules/DebugConfig/DebugConfig.h:27:40: note: in definition of macro 'DBG_PRINTF'
   27 | #define DBG_PRINTF(...)  Serial.printf(__VA_ARGS__)
      |                                        ^~~~~~~~~~~
/home/runner/work/ESP32-FlightStack/ESP32-FlightStack/RC_FlightController/RC_FlightController.ino:2838:21: note: '*(unsigned char*)((char*)&s + offsetof(FlightState, FlightState::gps.GPSData::valid))' was declared here
 2838 |         FlightState s;
      |                     ^
/home/runner/work/ESP32-FlightStack/ESP32-FlightStack/RC_FlightController/src/Submodules/ESP32Core/CPUUtilization.cpp: In function 'bool idleHookCore0()':
/home/runner/work/ESP32-FlightStack/ESP32-FlightStack/RC_FlightController/src/Submodules/ESP32Core/CPUUtilization.cpp:23:5: warning: '++' expression of 'volatile'-qualified type is deprecated [-Wvolatile]
   23 |     s_idleCount0++;
      |     ^~~~~~~~~~~~
/home/runner/work/ESP32-FlightStack/ESP32-FlightStack/RC_FlightController/src/Submodules/ESP32Core/CPUUtilization.cpp: In function 'bool idleHookCore1()':
/home/runner/work/ESP32-FlightStack/ESP32-FlightStack/RC_FlightController/src/Submodules/ESP32Core/CPUUtilization.cpp:28:5: warning: '++' expression of 'volatile'-qualified type is deprecated [-Wvolatile]
   28 |     s_idleCount1++;
      |     ^~~~~~~~~~~~
/home/runner/work/ESP32-FlightStack/ESP32-FlightStack/RC_FlightController/src/Submodules/FFT/SpectrumAnalyzer.cpp: In member function 'void SpectrumAnalyzer::push(float, float, float, float, float, float, bool)':
/home/runner/work/ESP32-FlightStack/ESP32-FlightStack/RC_FlightController/src/Submodules/FFT/SpectrumAnalyzer.cpp:42:5: warning: '++' expression of 'volatile'-qualified type is deprecated [-Wvolatile]
   42 |     _sampleSeq++;
      |     ^~~~~~~~~~
/home/runner/work/ESP32-FlightStack/ESP32-FlightStack/RC_FlightController/src/Submodules/FFT/SpectrumAnalyzer.cpp:43:11: warning: '++' expression of 'volatile'-qualified type is deprecated [-Wvolatile]
   43 |     if (++_head >= N) { _head = 0; _full = true; }
      |           ^~~~~
/home/runner/work/ESP32-FlightStack/ESP32-FlightStack/RC_FlightController/src/Submodules/Logger/Logger.cpp: In member function 'bool Logger::push(const LoggerRow&)':
/home/runner/work/ESP32-FlightStack/ESP32-FlightStack/RC_FlightController/src/Submodules/Logger/Logger.cpp:103:9: warning: '++' expression of 'volatile'-qualified type is deprecated [-Wvolatile]
  103 |         _dropped++;
      |         ^~~~~~~~
/home/runner/work/ESP32-FlightStack/ESP32-FlightStack/RC_FlightController/src/Submodules/Logger/Logger.cpp:108:11: warning: '++' expression of 'volatile'-qualified type is deprecated [-Wvolatile]
  108 |     if (++_head >= _capacity) { _head = 0; _full = true; }
      |           ^~~~~
/home/runner/work/ESP32-FlightStack/ESP32-FlightStack/RC_FlightController/src/Submodules/Logger/Logger.cpp: In member function 'String Logger::csvRow(uint16_t) const':
/home/runner/work/ESP32-FlightStack/ESP32-FlightStack/RC_FlightController/src/Submodules/Logger/Logger.cpp:166:28: warning: 'r.LoggerRow::jitter_us' may be used uninitialized [-Wmaybe-uninitialized]
  166 |     s += String(r.jitter_us); s += ','; s += String(r.control_exec_us); s += ','; s += String(r.imu_read_us); s += ',';
      |                            ^
/home/runner/work/ESP32-FlightStack/ESP32-FlightStack/RC_FlightController/src/Submodules/Logger/Logger.cpp:157:15: note: 'r.LoggerRow::jitter_us' was declared here
  157 |     LoggerRow r; bool ok = false;
      |               ^
/home/runner/work/ESP32-FlightStack/ESP32-FlightStack/RC_FlightController/src/Submodules/Logger/Logger.cpp:166:70: warning: 'r.LoggerRow::control_exec_us' may be used uninitialized [-Wmaybe-uninitialized]
  166 |     s += String(r.jitter_us); s += ','; s += String(r.control_exec_us); s += ','; s += String(r.imu_read_us); s += ',';
      |                                                                      ^
/home/runner/work/ESP32-FlightStack/ESP32-FlightStack/RC_FlightController/src/Submodules/Logger/Logger.cpp:157:15: note: 'r.LoggerRow::control_exec_us' was declared here
  157 |     LoggerRow r; bool ok = false;
      |               ^
/home/runner/work/ESP32-FlightStack/ESP32-FlightStack/RC_FlightController/src/Submodules/Logger/Logger.cpp:166:108: warning: 'r.LoggerRow::imu_read_us' may be used uninitialized [-Wmaybe-uninitialized]
  166 |     s += String(r.jitter_us); s += ','; s += String(r.control_exec_us); s += ','; s += String(r.imu_read_us); s += ',';
      |                                                                                                            ^
/home/runner/work/ESP32-FlightStack/ESP32-FlightStack/RC_FlightController/src/Submodules/Logger/Logger.cpp:157:15: note: 'r.LoggerRow::imu_read_us' was declared here
  157 |     LoggerRow r; bool ok = false;
      |               ^
/home/runner/work/ESP32-FlightStack/ESP32-FlightStack/RC_FlightController/src/Submodules/Logger/Logger.cpp:167:29: warning: 'r.LoggerRow::rc_read_us' may be used uninitialized [-Wmaybe-uninitialized]
  167 |     s += String(r.rc_read_us); s += ','; s += String(r.ahrs_exec_us); s += ','; s += String(r.pid_exec_us); s += ',';
      |                             ^
/home/runner/work/ESP32-FlightStack/ESP32-FlightStack/RC_FlightController/src/Submodules/Logger/Logger.cpp:157:15: note: 'r.LoggerRow::rc_read_us' was declared here
  157 |     LoggerRow r; bool ok = false;
      |               ^
/home/runner/work/ESP32-FlightStack/ESP32-FlightStack/RC_FlightController/src/Submodules/Logger/Logger.cpp:167:68: warning: 'r.LoggerRow::ahrs_exec_us' may be used uninitialized [-Wmaybe-uninitialized]
  167 |     s += String(r.rc_read_us); s += ','; s += String(r.ahrs_exec_us); s += ','; s += String(r.pid_exec_us); s += ',';
      |                                                                    ^
/home/runner/work/ESP32-FlightStack/ESP32-FlightStack/RC_FlightController/src/Submodules/Logger/Logger.cpp:157:15: note: 'r.LoggerRow::ahrs_exec_us' was declared here
  157 |     LoggerRow r; bool ok = false;
      |               ^
/home/runner/work/ESP32-FlightStack/ESP32-FlightStack/RC_FlightController/src/Submodules/Logger/Logger.cpp:167:106: warning: 'r.LoggerRow::pid_exec_us' may be used uninitialized [-Wmaybe-uninitialized]
  167 |     s += String(r.rc_read_us); s += ','; s += String(r.ahrs_exec_us); s += ','; s += String(r.pid_exec_us); s += ',';
      |                                                                                                          ^
/home/runner/work/ESP32-FlightStack/ESP32-FlightStack/RC_FlightController/src/Submodules/Logger/Logger.cpp:157:15: note: 'r.LoggerRow::pid_exec_us' was declared here
  157 |     LoggerRow r; bool ok = false;
      |               ^
/home/runner/work/ESP32-FlightStack/ESP32-FlightStack/RC_FlightController/src/Submodules/Logger/Logger.cpp:168:32: warning: 'r.LoggerRow::motor_exec_us' may be used uninitialized [-Wmaybe-uninitialized]
  168 |     s += String(r.motor_exec_us); s += ','; s += String(r.mode); s += ',';
      |                                ^
/home/runner/work/ESP32-FlightStack/ESP32-FlightStack/RC_FlightController/src/Submodules/Logger/Logger.cpp:157:15: note: 'r.LoggerRow::motor_exec_us' was declared here
  157 |     LoggerRow r; bool ok = false;
      |               ^
/home/runner/work/ESP32-FlightStack/ESP32-FlightStack/RC_FlightController/src/Submodules/Logger/Logger.cpp:168:63: warning: 'r.LoggerRow::mode' may be used uninitialized [-Wmaybe-uninitialized]
  168 |     s += String(r.motor_exec_us); s += ','; s += String(r.mode); s += ',';
      |                                                               ^
/home/runner/work/ESP32-FlightStack/ESP32-FlightStack/RC_FlightController/src/Submodules/Logger/Logger.cpp:157:15: note: 'r.LoggerRow::mode' was declared here
  157 |     LoggerRow r; bool ok = false;
      |               ^
/home/runner/work/ESP32-FlightStack/ESP32-FlightStack/RC_FlightController/src/Submodules/Logger/Logger.cpp:157:15: warning: 'r.LoggerRow::flags' may be used uninitialized [-Wmaybe-uninitialized]
/home/runner/work/ESP32-FlightStack/ESP32-FlightStack/RC_FlightController/src/Submodules/Logger/Logger.cpp:173:17: warning: 'r.LoggerRow::throttle' may be used uninitialized [-Wmaybe-uninitialized]
  173 |     _appendFloat(s,r.throttle,4); _appendFloat(s,r.rc_roll,4); _appendFloat(s,r.rc_pitch,4); _appendFloat(s,r.rc_yaw,4);
      |     ~~~~~~~~~~~~^~~~~~~~~~~~~~~~
/home/runner/work/ESP32-FlightStack/ESP32-FlightStack/RC_FlightController/src/Submodules/Logger/Logger.cpp:157:15: note: 'r.LoggerRow::throttle' was declared here
  157 |     LoggerRow r; bool ok = false;
      |               ^
/home/runner/work/ESP32-FlightStack/ESP32-FlightStack/RC_FlightController/src/Submodules/Logger/Logger.cpp:173:47: warning: 'r.LoggerRow::rc_roll' may be used uninitialized [-Wmaybe-uninitialized]
  173 |     _appendFloat(s,r.throttle,4); _appendFloat(s,r.rc_roll,4); _appendFloat(s,r.rc_pitch,4); _appendFloat(s,r.rc_yaw,4);
      |                                   ~~~~~~~~~~~~^~~~~~~~~~~~~~~
/home/runner/work/ESP32-FlightStack/ESP32-FlightStack/RC_FlightController/src/Submodules/Logger/Logger.cpp:157:15: note: 'r.LoggerRow::rc_roll' was declared here
  157 |     LoggerRow r; bool ok = false;
      |               ^
/home/runner/work/ESP32-FlightStack/ESP32-FlightStack/RC_FlightController/src/Submodules/Logger/Logger.cpp:173:76: warning: 'r.LoggerRow::rc_pitch' may be used uninitialized [-Wmaybe-uninitialized]
  173 |     _appendFloat(s,r.throttle,4); _appendFloat(s,r.rc_roll,4); _appendFloat(s,r.rc_pitch,4); _appendFloat(s,r.rc_yaw,4);
      |                                                                ~~~~~~~~~~~~^~~~~~~~~~~~~~~~
/home/runner/work/ESP32-FlightStack/ESP32-FlightStack/RC_FlightController/src/Submodules/Logger/Logger.cpp:157:15: note: 'r.LoggerRow::rc_pitch' was declared here
  157 |     LoggerRow r; bool ok = false;
      |               ^
/home/runner/work/ESP32-FlightStack/ESP32-FlightStack/RC_FlightController/src/Submodules/Logger/Logger.cpp:173:106: warning: 'r.LoggerRow::rc_yaw' may be used uninitialized [-Wmaybe-uninitialized]
  173 |     _appendFloat(s,r.throttle,4); _appendFloat(s,r.rc_roll,4); _appendFloat(s,r.rc_pitch,4); _appendFloat(s,r.rc_yaw,4);
      |                                                                                              ~~~~~~~~~~~~^~~~~~~~~~~~~~
/home/runner/work/ESP32-FlightStack/ESP32-FlightStack/RC_FlightController/src/Submodules/Logger/Logger.cpp:157:15: note: 'r.LoggerRow::rc_yaw' was declared here
  157 |     LoggerRow r; bool ok = false;
      |               ^
/home/runner/work/ESP32-FlightStack/ESP32-FlightStack/RC_FlightController/src/Submodules/Logger/Logger.cpp:174:17: warning: 'r.LoggerRow::target_roll_deg' may be used uninitialized [-Wmaybe-uninitialized]
  174 |     _appendFloat(s,r.target_roll_deg,3); _appendFloat(s,r.target_pitch_deg,3); _appendFloat(s,r.target_yaw_deg,3);
      |     ~~~~~~~~~~~~^~~~~~~~~~~~~~~~~~~~~~~
/home/runner/work/ESP32-FlightStack/ESP32-FlightStack/RC_FlightController/src/Submodules/Logger/Logger.cpp:157:15: note: 'r.LoggerRow::target_roll_deg' was declared here
  157 |     LoggerRow r; bool ok = false;
      |               ^
/home/runner/work/ESP32-FlightStack/ESP32-FlightStack/RC_FlightController/src/Submodules/Logger/Logger.cpp:174:54: warning: 'r.LoggerRow::target_pitch_deg' may be used uninitialized [-Wmaybe-uninitialized]
  174 |     _appendFloat(s,r.target_roll_deg,3); _appendFloat(s,r.target_pitch_deg,3); _appendFloat(s,r.target_yaw_deg,3);
      |                                          ~~~~~~~~~~~~^~~~~~~~~~~~~~~~~~~~~~~~
/home/runner/work/ESP32-FlightStack/ESP32-FlightStack/RC_FlightController/src/Submodules/Logger/Logger.cpp:157:15: note: 'r.LoggerRow::target_pitch_deg' was declared here
  157 |     LoggerRow r; bool ok = false;
      |               ^
/home/runner/work/ESP32-FlightStack/ESP32-FlightStack/RC_FlightController/src/Submodules/Logger/Logger.cpp:174:92: warning: 'r.LoggerRow::target_yaw_deg' may be used uninitialized [-Wmaybe-uninitialized]
  174 |     _appendFloat(s,r.target_roll_deg,3); _appendFloat(s,r.target_pitch_deg,3); _appendFloat(s,r.target_yaw_deg,3);
      |                                                                                ~~~~~~~~~~~~^~~~~~~~~~~~~~~~~~~~~~
/home/runner/work/ESP32-FlightStack/ESP32-FlightStack/RC_FlightController/src/Submodules/Logger/Logger.cpp:157:15: note: 'r.LoggerRow::target_yaw_deg' was declared here
  157 |     LoggerRow r; bool ok = false;
      |               ^
/home/runner/work/ESP32-FlightStack/ESP32-FlightStack/RC_FlightController/src/Submodules/Logger/Logger.cpp:175:17: warning: 'r.LoggerRow::target_roll_rate_dps' may be used uninitialized [-Wmaybe-uninitialized]
  175 |     _appendFloat(s,r.target_roll_rate_dps,3); _appendFloat(s,r.target_pitch_rate_dps,3); _appendFloat(s,r.target_yaw_rate_dps,3);
      |     ~~~~~~~~~~~~^~~~~~~~~~~~~~~~~~~~~~~~~~~~
/home/runner/work/ESP32-FlightStack/ESP32-FlightStack/RC_FlightController/src/Submodules/Logger/Logger.cpp:157:15: note: 'r.LoggerRow::target_roll_rate_dps' was declared here
  157 |     LoggerRow r; bool ok = false;
      |               ^
/home/runner/work/ESP32-FlightStack/ESP32-FlightStack/RC_FlightController/src/Submodules/Logger/Logger.cpp:175:59: warning: 'r.LoggerRow::target_pitch_rate_dps' may be used uninitialized [-Wmaybe-uninitialized]
  175 |     _appendFloat(s,r.target_roll_rate_dps,3); _appendFloat(s,r.target_pitch_rate_dps,3); _appendFloat(s,r.target_yaw_rate_dps,3);
      |                                               ~~~~~~~~~~~~^~~~~~~~~~~~~~~~~~~~~~~~~~~~~
/home/runner/work/ESP32-FlightStack/ESP32-FlightStack/RC_FlightController/src/Submodules/Logger/Logger.cpp:157:15: note: 'r.LoggerRow::target_pitch_rate_dps' was declared here
  157 |     LoggerRow r; bool ok = false;
      |               ^
/home/runner/work/ESP32-FlightStack/ESP32-FlightStack/RC_FlightController/src/Submodules/Logger/Logger.cpp:175:102: warning: 'r.LoggerRow::target_yaw_rate_dps' may be used uninitialized [-Wmaybe-uninitialized]
  175 |     _appendFloat(s,r.target_roll_rate_dps,3); _appendFloat(s,r.target_pitch_rate_dps,3); _appendFloat(s,r.target_yaw_rate_dps,3);
      |                                                                                          ~~~~~~~~~~~~^~~~~~~~~~~~~~~~~~~~~~~~~~~
/home/runner/work/ESP32-FlightStack/ESP32-FlightStack/RC_FlightController/src/Submodules/Logger/Logger.cpp:157:15: note: 'r.LoggerRow::target_yaw_rate_dps' was declared here
  157 |     LoggerRow r; bool ok = false;
      |               ^
/home/runner/work/ESP32-FlightStack/ESP32-FlightStack/RC_FlightController/src/Submodules/Logger/Logger.cpp:176:17: warning: 'r.LoggerRow::ekf_roll_deg' may be used uninitialized [-Wmaybe-uninitialized]
  176 |     _appendFloat(s,r.ekf_roll_deg,3); _appendFloat(s,r.ekf_pitch_deg,3); _appendFloat(s,r.ekf_yaw_deg,3);
      |     ~~~~~~~~~~~~^~~~~~~~~~~~~~~~~~~~
/home/runner/work/ESP32-FlightStack/ESP32-FlightStack/RC_FlightController/src/Submodules/Logger/Logger.cpp:157:15: note: 'r.LoggerRow::ekf_roll_deg' was declared here
  157 |     LoggerRow r; bool ok = false;
      |               ^
/home/runner/work/ESP32-FlightStack/ESP32-FlightStack/RC_FlightController/src/Submodules/Logger/Logger.cpp:176:51: warning: 'r.LoggerRow::ekf_pitch_deg' may be used uninitialized [-Wmaybe-uninitialized]
  176 |     _appendFloat(s,r.ekf_roll_deg,3); _appendFloat(s,r.ekf_pitch_deg,3); _appendFloat(s,r.ekf_yaw_deg,3);
      |                                       ~~~~~~~~~~~~^~~~~~~~~~~~~~~~~~~~~
/home/runner/work/ESP32-FlightStack/ESP32-FlightStack/RC_FlightController/src/Submodules/Logger/Logger.cpp:157:15: note: 'r.LoggerRow::ekf_pitch_deg' was declared here
  157 |     LoggerRow r; bool ok = false;
      |               ^
/home/runner/work/ESP32-FlightStack/ESP32-FlightStack/RC_FlightController/src/Submodules/Logger/Logger.cpp:176:86: warning: 'r.LoggerRow::ekf_yaw_deg' may be used uninitialized [-Wmaybe-uninitialized]
  176 |     _appendFloat(s,r.ekf_roll_deg,3); _appendFloat(s,r.ekf_pitch_deg,3); _appendFloat(s,r.ekf_yaw_deg,3);
      |                                                                          ~~~~~~~~~~~~^~~~~~~~~~~~~~~~~~~
/home/runner/work/ESP32-FlightStack/ESP32-FlightStack/RC_FlightController/src/Submodules/Logger/Logger.cpp:157:15: note: 'r.LoggerRow::ekf_yaw_deg' was declared here
  157 |     LoggerRow r; bool ok = false;
      |               ^
/home/runner/work/ESP32-FlightStack/ESP32-FlightStack/RC_FlightController/src/Submodules/Logger/Logger.cpp:177:17: warning: 'r.LoggerRow::ctrl_roll_deg' may be used uninitialized [-Wmaybe-uninitialized]
  177 |     _appendFloat(s,r.ctrl_roll_deg,3); _appendFloat(s,r.ctrl_pitch_deg,3); _appendFloat(s,r.ctrl_yaw_deg,3);
      |     ~~~~~~~~~~~~^~~~~~~~~~~~~~~~~~~~~
/home/runner/work/ESP32-FlightStack/ESP32-FlightStack/RC_FlightController/src/Submodules/Logger/Logger.cpp:157:15: note: 'r.LoggerRow::ctrl_roll_deg' was declared here
  157 |     LoggerRow r; bool ok = false;
      |               ^
/home/runner/work/ESP32-FlightStack/ESP32-FlightStack/RC_FlightController/src/Submodules/Logger/Logger.cpp:177:52: warning: 'r.LoggerRow::ctrl_pitch_deg' may be used uninitialized [-Wmaybe-uninitialized]
  177 |     _appendFloat(s,r.ctrl_roll_deg,3); _appendFloat(s,r.ctrl_pitch_deg,3); _appendFloat(s,r.ctrl_yaw_deg,3);
      |                                        ~~~~~~~~~~~~^~~~~~~~~~~~~~~~~~~~~~
/home/runner/work/ESP32-FlightStack/ESP32-FlightStack/RC_FlightController/src/Submodules/Logger/Logger.cpp:157:15: note: 'r.LoggerRow::ctrl_pitch_deg' was declared here
  157 |     LoggerRow r; bool ok = false;
      |               ^
/home/runner/work/ESP32-FlightStack/ESP32-FlightStack/RC_FlightController/src/Submodules/Logger/Logger.cpp:177:88: warning: 'r.LoggerRow::ctrl_yaw_deg' may be used uninitialized [-Wmaybe-uninitialized]
  177 |     _appendFloat(s,r.ctrl_roll_deg,3); _appendFloat(s,r.ctrl_pitch_deg,3); _appendFloat(s,r.ctrl_yaw_deg,3);
      |                                                                            ~~~~~~~~~~~~^~~~~~~~~~~~~~~~~~~~
/home/runner/work/ESP32-FlightStack/ESP32-FlightStack/RC_FlightController/src/Submodules/Logger/Logger.cpp:157:15: note: 'r.LoggerRow::ctrl_yaw_deg' was declared here
  157 |     LoggerRow r; bool ok = false;
      |               ^
/home/runner/work/ESP32-FlightStack/ESP32-FlightStack/RC_FlightController/src/Submodules/Logger/Logger.cpp:178:17: warning: 'r.LoggerRow::zero_roll_deg' may be used uninitialized [-Wmaybe-uninitialized]
  178 |     _appendFloat(s,r.zero_roll_deg,3); _appendFloat(s,r.zero_pitch_deg,3); _appendFloat(s,r.zero_yaw_deg,3);
      |     ~~~~~~~~~~~~^~~~~~~~~~~~~~~~~~~~~
/home/runner/work/ESP32-FlightStack/ESP32-FlightStack/RC_FlightController/src/Submodules/Logger/Logger.cpp:157:15: note: 'r.LoggerRow::zero_roll_deg' was declared here
  157 |     LoggerRow r; bool ok = false;
      |               ^
/home/runner/work/ESP32-FlightStack/ESP32-FlightStack/RC_FlightController/src/Submodules/Logger/Logger.cpp:178:52: warning: 'r.LoggerRow::zero_pitch_deg' may be used uninitialized [-Wmaybe-uninitialized]
  178 |     _appendFloat(s,r.zero_roll_deg,3); _appendFloat(s,r.zero_pitch_deg,3); _appendFloat(s,r.zero_yaw_deg,3);
      |                                        ~~~~~~~~~~~~^~~~~~~~~~~~~~~~~~~~~~
/home/runner/work/ESP32-FlightStack/ESP32-FlightStack/RC_FlightController/src/Submodules/Logger/Logger.cpp:157:15: note: 'r.LoggerRow::zero_pitch_deg' was declared here
  157 |     LoggerRow r; bool ok = false;
      |               ^
/home/runner/work/ESP32-FlightStack/ESP32-FlightStack/RC_FlightController/src/Submodules/Logger/Logger.cpp:178:88: warning: 'r.LoggerRow::zero_yaw_deg' may be used uninitialized [-Wmaybe-uninitialized]
  178 |     _appendFloat(s,r.zero_roll_deg,3); _appendFloat(s,r.zero_pitch_deg,3); _appendFloat(s,r.zero_yaw_deg,3);
      |                                                                            ~~~~~~~~~~~~^~~~~~~~~~~~~~~~~~~~
/home/runner/work/ESP32-FlightStack/ESP32-FlightStack/RC_FlightController/src/Submodules/Logger/Logger.cpp:157:15: note: 'r.LoggerRow::zero_yaw_deg' was declared here
  157 |     LoggerRow r; bool ok = false;
      |               ^
/home/runner/work/ESP32-FlightStack/ESP32-FlightStack/RC_FlightController/src/Submodules/Logger/Logger.cpp:179:17: warning: 'r.LoggerRow::ax_g' may be used uninitialized [-Wmaybe-uninitialized]
  179 |     _appendFloat(s,r.ax_g,5); _appendFloat(s,r.ay_g,5); _appendFloat(s,r.az_g,5);
      |     ~~~~~~~~~~~~^~~~~~~~~~~~
/home/runner/work/ESP32-FlightStack/ESP32-FlightStack/RC_FlightController/src/Submodules/Logger/Logger.cpp:157:15: note: 'r.LoggerRow::ax_g' was declared here
  157 |     LoggerRow r; bool ok = false;
      |               ^
/home/runner/work/ESP32-FlightStack/ESP32-FlightStack/RC_FlightController/src/Submodules/Logger/Logger.cpp:179:43: warning: 'r.LoggerRow::ay_g' may be used uninitialized [-Wmaybe-uninitialized]
  179 |     _appendFloat(s,r.ax_g,5); _appendFloat(s,r.ay_g,5); _appendFloat(s,r.az_g,5);
      |                               ~~~~~~~~~~~~^~~~~~~~~~~~
/home/runner/work/ESP32-FlightStack/ESP32-FlightStack/RC_FlightController/src/Submodules/Logger/Logger.cpp:157:15: note: 'r.LoggerRow::ay_g' was declared here
  157 |     LoggerRow r; bool ok = false;
      |               ^
/home/runner/work/ESP32-FlightStack/ESP32-FlightStack/RC_FlightController/src/Submodules/Logger/Logger.cpp:179:69: warning: 'r.LoggerRow::az_g' may be used uninitialized [-Wmaybe-uninitialized]
  179 |     _appendFloat(s,r.ax_g,5); _appendFloat(s,r.ay_g,5); _appendFloat(s,r.az_g,5);
      |                                                         ~~~~~~~~~~~~^~~~~~~~~~~~
/home/runner/work/ESP32-FlightStack/ESP32-FlightStack/RC_FlightController/src/Submodules/Logger/Logger.cpp:157:15: note: 'r.LoggerRow::az_g' was declared here
  157 |     LoggerRow r; bool ok = false;
      |               ^
/home/runner/work/ESP32-FlightStack/ESP32-FlightStack/RC_FlightController/src/Submodules/Logger/Logger.cpp:180:17: warning: 'r.LoggerRow::gx_dps' may be used uninitialized [-Wmaybe-uninitialized]
  180 |     _appendFloat(s,r.gx_dps,3); _appendFloat(s,r.gy_dps,3); _appendFloat(s,r.gz_dps,3);
      |     ~~~~~~~~~~~~^~~~~~~~~~~~~~
/home/runner/work/ESP32-FlightStack/ESP32-FlightStack/RC_FlightController/src/Submodules/Logger/Logger.cpp:157:15: note: 'r.LoggerRow::gx_dps' was declared here
  157 |     LoggerRow r; bool ok = false;
      |               ^
/home/runner/work/ESP32-FlightStack/ESP32-FlightStack/RC_FlightController/src/Submodules/Logger/Logger.cpp:180:45: warning: 'r.LoggerRow::gy_dps' may be used uninitialized [-Wmaybe-uninitialized]
  180 |     _appendFloat(s,r.gx_dps,3); _appendFloat(s,r.gy_dps,3); _appendFloat(s,r.gz_dps,3);
      |                                 ~~~~~~~~~~~~^~~~~~~~~~~~~~
/home/runner/work/ESP32-FlightStack/ESP32-FlightStack/RC_FlightController/src/Submodules/Logger/Logger.cpp:157:15: note: 'r.LoggerRow::gy_dps' was declared here
  157 |     LoggerRow r; bool ok = false;
      |               ^
/home/runner/work/ESP32-FlightStack/ESP32-FlightStack/RC_FlightController/src/Submodules/Logger/Logger.cpp:180:73: warning: 'r.LoggerRow::gz_dps' may be used uninitialized [-Wmaybe-uninitialized]
  180 |     _appendFloat(s,r.gx_dps,3); _appendFloat(s,r.gy_dps,3); _appendFloat(s,r.gz_dps,3);
      |                                                             ~~~~~~~~~~~~^~~~~~~~~~~~~~
/home/runner/work/ESP32-FlightStack/ESP32-FlightStack/RC_FlightController/src/Submodules/Logger/Logger.cpp:157:15: note: 'r.LoggerRow::gz_dps' was declared here
  157 |     LoggerRow r; bool ok = false;
      |               ^
/home/runner/work/ESP32-FlightStack/ESP32-FlightStack/RC_FlightController/src/Submodules/Logger/Logger.cpp:181:17: warning: 'r.LoggerRow::mx_uT' may be used uninitialized [-Wmaybe-uninitialized]
  181 |     _appendFloat(s,r.mx_uT,3); _appendFloat(s,r.my_uT,3); _appendFloat(s,r.mz_uT,3);
      |     ~~~~~~~~~~~~^~~~~~~~~~~~~
/home/runner/work/ESP32-FlightStack/ESP32-FlightStack/RC_FlightController/src/Submodules/Logger/Logger.cpp:157:15: note: 'r.LoggerRow::mx_uT' was declared here
  157 |     LoggerRow r; bool ok = false;
      |               ^
/home/runner/work/ESP32-FlightStack/ESP32-FlightStack/RC_FlightController/src/Submodules/Logger/Logger.cpp:181:44: warning: 'r.LoggerRow::my_uT' may be used uninitialized [-Wmaybe-uninitialized]
  181 |     _appendFloat(s,r.mx_uT,3); _appendFloat(s,r.my_uT,3); _appendFloat(s,r.mz_uT,3);
      |                                ~~~~~~~~~~~~^~~~~~~~~~~~~
/home/runner/work/ESP32-FlightStack/ESP32-FlightStack/RC_FlightController/src/Submodules/Logger/Logger.cpp:157:15: note: 'r.LoggerRow::my_uT' was declared here
  157 |     LoggerRow r; bool ok = false;
      |               ^
/home/runner/work/ESP32-FlightStack/ESP32-FlightStack/RC_FlightController/src/Submodules/Logger/Logger.cpp:181:71: warning: 'r.LoggerRow::mz_uT' may be used uninitialized [-Wmaybe-uninitialized]
  181 |     _appendFloat(s,r.mx_uT,3); _appendFloat(s,r.my_uT,3); _appendFloat(s,r.mz_uT,3);
      |                                                           ~~~~~~~~~~~~^~~~~~~~~~~~~
/home/runner/work/ESP32-FlightStack/ESP32-FlightStack/RC_FlightController/src/Submodules/Logger/Logger.cpp:157:15: note: 'r.LoggerRow::mz_uT' was declared here
  157 |     LoggerRow r; bool ok = false;
      |               ^
/home/runner/work/ESP32-FlightStack/ESP32-FlightStack/RC_FlightController/src/Submodules/Logger/Logger.cpp:182:17: warning: 'r.LoggerRow::accel_norm_g' may be used uninitialized [-Wmaybe-uninitialized]
  182 |     _appendFloat(s,r.accel_norm_g,5); _appendFloat(s,r.gyro_norm_dps,3); _appendFloat(s,r.mag_norm_uT,3);
      |     ~~~~~~~~~~~~^~~~~~~~~~~~~~~~~~~~
/home/runner/work/ESP32-FlightStack/ESP32-FlightStack/RC_FlightController/src/Submodules/Logger/Logger.cpp:157:15: note: 'r.LoggerRow::accel_norm_g' was declared here
  157 |     LoggerRow r; bool ok = false;
      |               ^
/home/runner/work/ESP32-FlightStack/ESP32-FlightStack/RC_FlightController/src/Submodules/Logger/Logger.cpp:182:51: warning: 'r.LoggerRow::gyro_norm_dps' may be used uninitialized [-Wmaybe-uninitialized]
  182 |     _appendFloat(s,r.accel_norm_g,5); _appendFloat(s,r.gyro_norm_dps,3); _appendFloat(s,r.mag_norm_uT,3);
      |                                       ~~~~~~~~~~~~^~~~~~~~~~~~~~~~~~~~~
/home/runner/work/ESP32-FlightStack/ESP32-FlightStack/RC_FlightController/src/Submodules/Logger/Logger.cpp:157:15: note: 'r.LoggerRow::gyro_norm_dps' was declared here
  157 |     LoggerRow r; bool ok = false;
      |               ^
/home/runner/work/ESP32-FlightStack/ESP32-FlightStack/RC_FlightController/src/Submodules/Logger/Logger.cpp:182:86: warning: 'r.LoggerRow::mag_norm_uT' may be used uninitialized [-Wmaybe-uninitialized]
  182 |     _appendFloat(s,r.accel_norm_g,5); _appendFloat(s,r.gyro_norm_dps,3); _appendFloat(s,r.mag_norm_uT,3);
      |                                                                          ~~~~~~~~~~~~^~~~~~~~~~~~~~~~~~~
/home/runner/work/ESP32-FlightStack/ESP32-FlightStack/RC_FlightController/src/Submodules/Logger/Logger.cpp:157:15: note: 'r.LoggerRow::mag_norm_uT' was declared here
  157 |     LoggerRow r; bool ok = false;
      |               ^
/home/runner/work/ESP32-FlightStack/ESP32-FlightStack/RC_FlightController/src/Submodules/Logger/Logger.cpp:183:17: warning: 'r.LoggerRow::ekf_bgx_dps' may be used uninitialized [-Wmaybe-uninitialized]
  183 |     _appendFloat(s,r.ekf_bgx_dps,5); _appendFloat(s,r.ekf_bgy_dps,5); _appendFloat(s,r.ekf_bgz_dps,5);
      |     ~~~~~~~~~~~~^~~~~~~~~~~~~~~~~~~
/home/runner/work/ESP32-FlightStack/ESP32-FlightStack/RC_FlightController/src/Submodules/Logger/Logger.cpp:157:15: note: 'r.LoggerRow::ekf_bgx_dps' was declared here
  157 |     LoggerRow r; bool ok = false;
      |               ^
/home/runner/work/ESP32-FlightStack/ESP32-FlightStack/RC_FlightController/src/Submodules/Logger/Logger.cpp:183:50: warning: 'r.LoggerRow::ekf_bgy_dps' may be used uninitialized [-Wmaybe-uninitialized]
  183 |     _appendFloat(s,r.ekf_bgx_dps,5); _appendFloat(s,r.ekf_bgy_dps,5); _appendFloat(s,r.ekf_bgz_dps,5);
      |                                      ~~~~~~~~~~~~^~~~~~~~~~~~~~~~~~~
/home/runner/work/ESP32-FlightStack/ESP32-FlightStack/RC_FlightController/src/Submodules/Logger/Logger.cpp:157:15: note: 'r.LoggerRow::ekf_bgy_dps' was declared here
  157 |     LoggerRow r; bool ok = false;
      |               ^
/home/runner/work/ESP32-FlightStack/ESP32-FlightStack/RC_FlightController/src/Submodules/Logger/Logger.cpp:183:83: warning: 'r.LoggerRow::ekf_bgz_dps' may be used uninitialized [-Wmaybe-uninitialized]
  183 |     _appendFloat(s,r.ekf_bgx_dps,5); _appendFloat(s,r.ekf_bgy_dps,5); _appendFloat(s,r.ekf_bgz_dps,5);
      |                                                                       ~~~~~~~~~~~~^~~~~~~~~~~~~~~~~~~
/home/runner/work/ESP32-FlightStack/ESP32-FlightStack/RC_FlightController/src/Submodules/Logger/Logger.cpp:157:15: note: 'r.LoggerRow::ekf_bgz_dps' was declared here
  157 |     LoggerRow r; bool ok = false;
      |               ^
/home/runner/work/ESP32-FlightStack/ESP32-FlightStack/RC_FlightController/src/Submodules/Logger/Logger.cpp:185:17: warning: 'r.LoggerRow::feedback_roll_rate_dps' may be used uninitialized [-Wmaybe-uninitialized]
  185 |     _appendFloat(s,r.feedback_roll_rate_dps,3);
      |     ~~~~~~~~~~~~^~~~~~~~~~~~~~~~~~~~~~~~~~~~~~
/home/runner/work/ESP32-FlightStack/ESP32-FlightStack/RC_FlightController/src/Submodules/Logger/Logger.cpp:157:15: note: 'r.LoggerRow::feedback_roll_rate_dps' was declared here
  157 |     LoggerRow r; bool ok = false;
      |               ^
/home/runner/work/ESP32-FlightStack/ESP32-FlightStack/RC_FlightController/src/Submodules/Logger/Logger.cpp:186:17: warning: 'r.LoggerRow::feedback_pitch_rate_dps' may be used uninitialized [-Wmaybe-uninitialized]
  186 |     _appendFloat(s,r.feedback_pitch_rate_dps,3);
      |     ~~~~~~~~~~~~^~~~~~~~~~~~~~~~~~~~~~~~~~~~~~~
/home/runner/work/ESP32-FlightStack/ESP32-FlightStack/RC_FlightController/src/Submodules/Logger/Logger.cpp:157:15: note: 'r.LoggerRow::feedback_pitch_rate_dps' was declared here
  157 |     LoggerRow r; bool ok = false;
      |               ^
/home/runner/work/ESP32-FlightStack/ESP32-FlightStack/RC_FlightController/src/Submodules/Logger/Logger.cpp:187:17: warning: 'r.LoggerRow::feedback_yaw_rate_dps' may be used uninitialized [-Wmaybe-uninitialized]
  187 |     _appendFloat(s,r.feedback_yaw_rate_dps,3);
      |     ~~~~~~~~~~~~^~~~~~~~~~~~~~~~~~~~~~~~~~~~~
/home/runner/work/ESP32-FlightStack/ESP32-FlightStack/RC_FlightController/src/Submodules/Logger/Logger.cpp:157:15: note: 'r.LoggerRow::feedback_yaw_rate_dps' was declared here
  157 |     LoggerRow r; bool ok = false;
      |               ^
/home/runner/work/ESP32-FlightStack/ESP32-FlightStack/RC_FlightController/src/Submodules/Logger/Logger.cpp:188:17: warning: 'r.LoggerRow::bias_corrected_roll_rate_dps' may be used uninitialized [-Wmaybe-uninitialized]
  188 |     _appendFloat(s,r.bias_corrected_roll_rate_dps,3);
      |     ~~~~~~~~~~~~^~~~~~~~~~~~~~~~~~~~~~~~~~~~~~~~~~~~
/home/runner/work/ESP32-FlightStack/ESP32-FlightStack/RC_FlightController/src/Submodules/Logger/Logger.cpp:157:15: note: 'r.LoggerRow::bias_corrected_roll_rate_dps' was declared here
  157 |     LoggerRow r; bool ok = false;
      |               ^
/home/runner/work/ESP32-FlightStack/ESP32-FlightStack/RC_FlightController/src/Submodules/Logger/Logger.cpp:189:17: warning: 'r.LoggerRow::bias_corrected_pitch_rate_dps' may be used uninitialized [-Wmaybe-uninitialized]
  189 |     _appendFloat(s,r.bias_corrected_pitch_rate_dps,3);
      |     ~~~~~~~~~~~~^~~~~~~~~~~~~~~~~~~~~~~~~~~~~~~~~~~~~
/home/runner/work/ESP32-FlightStack/ESP32-FlightStack/RC_FlightController/src/Submodules/Logger/Logger.cpp:157:15: note: 'r.LoggerRow::bias_corrected_pitch_rate_dps' was declared here
  157 |     LoggerRow r; bool ok = false;
      |               ^
/home/runner/work/ESP32-FlightStack/ESP32-FlightStack/RC_FlightController/src/Submodules/Logger/Logger.cpp:190:17: warning: 'r.LoggerRow::bias_corrected_yaw_rate_dps' may be used uninitialized [-Wmaybe-uninitialized]
  190 |     _appendFloat(s,r.bias_corrected_yaw_rate_dps,3);
      |     ~~~~~~~~~~~~^~~~~~~~~~~~~~~~~~~~~~~~~~~~~~~~~~~
/home/runner/work/ESP32-FlightStack/ESP32-FlightStack/RC_FlightController/src/Submodules/Logger/Logger.cpp:157:15: note: 'r.LoggerRow::bias_corrected_yaw_rate_dps' was declared here
  157 |     LoggerRow r; bool ok = false;
      |               ^
/home/runner/work/ESP32-FlightStack/ESP32-FlightStack/RC_FlightController/src/Submodules/Logger/Logger.cpp:191:17: warning: 'r.LoggerRow::ekf_roll_rate_dps' may be used uninitialized [-Wmaybe-uninitialized]
  191 |     _appendFloat(s,r.ekf_roll_rate_dps,3);
      |     ~~~~~~~~~~~~^~~~~~~~~~~~~~~~~~~~~~~~~
/home/runner/work/ESP32-FlightStack/ESP32-FlightStack/RC_FlightController/src/Submodules/Logger/Logger.cpp:157:15: note: 'r.LoggerRow::ekf_roll_rate_dps' was declared here
  157 |     LoggerRow r; bool ok = false;
      |               ^
/home/runner/work/ESP32-FlightStack/ESP32-FlightStack/RC_FlightController/src/Submodules/Logger/Logger.cpp:192:17: warning: 'r.LoggerRow::ekf_pitch_rate_dps' may be used uninitialized [-Wmaybe-uninitialized]
  192 |     _appendFloat(s,r.ekf_pitch_rate_dps,3);
      |     ~~~~~~~~~~~~^~~~~~~~~~~~~~~~~~~~~~~~~~
/home/runner/work/ESP32-FlightStack/ESP32-FlightStack/RC_FlightController/src/Submodules/Logger/Logger.cpp:157:15: note: 'r.LoggerRow::ekf_pitch_rate_dps' was declared here
  157 |     LoggerRow r; bool ok = false;
      |               ^
/home/runner/work/ESP32-FlightStack/ESP32-FlightStack/RC_FlightController/src/Submodules/Logger/Logger.cpp:193:17: warning: 'r.LoggerRow::ekf_yaw_rate_dps' may be used uninitialized [-Wmaybe-uninitialized]
  193 |     _appendFloat(s,r.ekf_yaw_rate_dps,3);
      |     ~~~~~~~~~~~~^~~~~~~~~~~~~~~~~~~~~~~~
/home/runner/work/ESP32-FlightStack/ESP32-FlightStack/RC_FlightController/src/Submodules/Logger/Logger.cpp:157:15: note: 'r.LoggerRow::ekf_yaw_rate_dps' was declared here
  157 |     LoggerRow r; bool ok = false;
      |               ^
/home/runner/work/ESP32-FlightStack/ESP32-FlightStack/RC_FlightController/src/Submodules/Logger/Logger.cpp:194:43: warning: 'r.LoggerRow::ekf_rate_valid' may be used uninitialized [-Wmaybe-uninitialized]
  194 |     s += ','; s += String(r.ekf_rate_valid);
      |                                           ^
/home/runner/work/ESP32-FlightStack/ESP32-FlightStack/RC_FlightController/src/Submodules/Logger/Logger.cpp:157:15: note: 'r.LoggerRow::ekf_rate_valid' was declared here
  157 |     LoggerRow r; bool ok = false;
      |               ^
/home/runner/work/ESP32-FlightStack/ESP32-FlightStack/RC_FlightController/src/Submodules/Logger/Logger.cpp:195:38: warning: 'r.LoggerRow::ahrs_mode' may be used uninitialized [-Wmaybe-uninitialized]
  195 |     s += ','; s += String(r.ahrs_mode); s += ','; s += String(r.ekf_mag_used);
      |                                      ^
/home/runner/work/ESP32-FlightStack/ESP32-FlightStack/RC_FlightController/src/Submodules/Logger/Logger.cpp:157:15: note: 'r.LoggerRow::ahrs_mode' was declared here
  157 |     LoggerRow r; bool ok = false;
      |               ^
/home/runner/work/ESP32-FlightStack/ESP32-FlightStack/RC_FlightController/src/Submodules/Logger/Logger.cpp:195:77: warning: 'r.LoggerRow::ekf_mag_used' may be used uninitialized [-Wmaybe-uninitialized]
  195 |     s += ','; s += String(r.ahrs_mode); s += ','; s += String(r.ekf_mag_used);
      |                                                                             ^
/home/runner/work/ESP32-FlightStack/ESP32-FlightStack/RC_FlightController/src/Submodules/Logger/Logger.cpp:157:15: note: 'r.LoggerRow::ekf_mag_used' was declared here
  157 |     LoggerRow r; bool ok = false;
      |               ^
/home/runner/work/ESP32-FlightStack/ESP32-FlightStack/RC_FlightController/src/Submodules/Logger/Logger.cpp:197:17: warning: 'r.LoggerRow::angle_roll_error_deg' may be used uninitialized [-Wmaybe-uninitialized]
  197 |     _appendFloat(s,r.angle_roll_error_deg,3); _appendFloat(s,r.angle_pitch_error_deg,3); _appendFloat(s,r.yaw_error_deg,3);
      |     ~~~~~~~~~~~~^~~~~~~~~~~~~~~~~~~~~~~~~~~~
/home/runner/work/ESP32-FlightStack/ESP32-FlightStack/RC_FlightController/src/Submodules/Logger/Logger.cpp:157:15: note: 'r.LoggerRow::angle_roll_error_deg' was declared here
  157 |     LoggerRow r; bool ok = false;
      |               ^
/home/runner/work/ESP32-FlightStack/ESP32-FlightStack/RC_FlightController/src/Submodules/Logger/Logger.cpp:197:59: warning: 'r.LoggerRow::angle_pitch_error_deg' may be used uninitialized [-Wmaybe-uninitialized]
  197 |     _appendFloat(s,r.angle_roll_error_deg,3); _appendFloat(s,r.angle_pitch_error_deg,3); _appendFloat(s,r.yaw_error_deg,3);
      |                                               ~~~~~~~~~~~~^~~~~~~~~~~~~~~~~~~~~~~~~~~~~
/home/runner/work/ESP32-FlightStack/ESP32-FlightStack/RC_FlightController/src/Submodules/Logger/Logger.cpp:157:15: note: 'r.LoggerRow::angle_pitch_error_deg' was declared here
  157 |     LoggerRow r; bool ok = false;
      |               ^
/home/runner/work/ESP32-FlightStack/ESP32-FlightStack/RC_FlightController/src/Submodules/Logger/Logger.cpp:197:102: warning: 'r.LoggerRow::yaw_error_deg' may be used uninitialized [-Wmaybe-uninitialized]
  197 |     _appendFloat(s,r.angle_roll_error_deg,3); _appendFloat(s,r.angle_pitch_error_deg,3); _appendFloat(s,r.yaw_error_deg,3);
      |                                                                                          ~~~~~~~~~~~~^~~~~~~~~~~~~~~~~~~~~
/home/runner/work/ESP32-FlightStack/ESP32-FlightStack/RC_FlightController/src/Submodules/Logger/Logger.cpp:157:15: note: 'r.LoggerRow::yaw_error_deg' was declared here
  157 |     LoggerRow r; bool ok = false;
      |               ^
/home/runner/work/ESP32-FlightStack/ESP32-FlightStack/RC_FlightController/src/Submodules/Logger/Logger.cpp:198:17: warning: 'r.LoggerRow::rate_roll_error_dps' may be used uninitialized [-Wmaybe-uninitialized]
  198 |     _appendFloat(s,r.rate_roll_error_dps,3); _appendFloat(s,r.rate_pitch_error_dps,3); _appendFloat(s,r.rate_yaw_error_dps,3);
      |     ~~~~~~~~~~~~^~~~~~~~~~~~~~~~~~~~~~~~~~~
/home/runner/work/ESP32-FlightStack/ESP32-FlightStack/RC_FlightController/src/Submodules/Logger/Logger.cpp:157:15: note: 'r.LoggerRow::rate_roll_error_dps' was declared here
  157 |     LoggerRow r; bool ok = false;
      |               ^
/home/runner/work/ESP32-FlightStack/ESP32-FlightStack/RC_FlightController/src/Submodules/Logger/Logger.cpp:198:58: warning: 'r.LoggerRow::rate_pitch_error_dps' may be used uninitialized [-Wmaybe-uninitialized]
  198 |     _appendFloat(s,r.rate_roll_error_dps,3); _appendFloat(s,r.rate_pitch_error_dps,3); _appendFloat(s,r.rate_yaw_error_dps,3);
      |                                              ~~~~~~~~~~~~^~~~~~~~~~~~~~~~~~~~~~~~~~~~
/home/runner/work/ESP32-FlightStack/ESP32-FlightStack/RC_FlightController/src/Submodules/Logger/Logger.cpp:157:15: note: 'r.LoggerRow::rate_pitch_error_dps' was declared here
  157 |     LoggerRow r; bool ok = false;
      |               ^
/home/runner/work/ESP32-FlightStack/ESP32-FlightStack/RC_FlightController/src/Submodules/Logger/Logger.cpp:198:100: warning: 'r.LoggerRow::rate_yaw_error_dps' may be used uninitialized [-Wmaybe-uninitialized]
  198 |     _appendFloat(s,r.rate_roll_error_dps,3); _appendFloat(s,r.rate_pitch_error_dps,3); _appendFloat(s,r.rate_yaw_error_dps,3);
      |                                                                                        ~~~~~~~~~~~~^~~~~~~~~~~~~~~~~~~~~~~~~~
/home/runner/work/ESP32-FlightStack/ESP32-FlightStack/RC_FlightController/src/Submodules/Logger/Logger.cpp:157:15: note: 'r.LoggerRow::rate_yaw_error_dps' was declared here
  157 |     LoggerRow r; bool ok = false;
      |               ^
/home/runner/work/ESP32-FlightStack/ESP32-FlightStack/RC_FlightController/src/Submodules/Logger/Logger.cpp:200:17: warning: 'r.LoggerRow::angle_roll_p' may be used uninitialized [-Wmaybe-uninitialized]
  200 |     _appendFloat(s,r.angle_roll_p,6); _appendFloat(s,r.angle_roll_i,6); _appendFloat(s,r.angle_roll_d,6); _appendFloat(s,r.angle_roll_out,6);
      |     ~~~~~~~~~~~~^~~~~~~~~~~~~~~~~~~~
/home/runner/work/ESP32-FlightStack/ESP32-FlightStack/RC_FlightController/src/Submodules/Logger/Logger.cpp:157:15: note: 'r.LoggerRow::angle_roll_p' was declared here
  157 |     LoggerRow r; bool ok = false;
      |               ^
/home/runner/work/ESP32-FlightStack/ESP32-FlightStack/RC_FlightController/src/Submodules/Logger/Logger.cpp:200:51: warning: 'r.LoggerRow::angle_roll_i' may be used uninitialized [-Wmaybe-uninitialized]
  200 |     _appendFloat(s,r.angle_roll_p,6); _appendFloat(s,r.angle_roll_i,6); _appendFloat(s,r.angle_roll_d,6); _appendFloat(s,r.angle_roll_out,6);
      |                                       ~~~~~~~~~~~~^~~~~~~~~~~~~~~~~~~~
/home/runner/work/ESP32-FlightStack/ESP32-FlightStack/RC_FlightController/src/Submodules/Logger/Logger.cpp:157:15: note: 'r.LoggerRow::angle_roll_i' was declared here
  157 |     LoggerRow r; bool ok = false;
      |               ^
/home/runner/work/ESP32-FlightStack/ESP32-FlightStack/RC_FlightController/src/Submodules/Logger/Logger.cpp:200:85: warning: 'r.LoggerRow::angle_roll_d' may be used uninitialized [-Wmaybe-uninitialized]
  200 |     _appendFloat(s,r.angle_roll_p,6); _appendFloat(s,r.angle_roll_i,6); _appendFloat(s,r.angle_roll_d,6); _appendFloat(s,r.angle_roll_out,6);
      |                                                                         ~~~~~~~~~~~~^~~~~~~~~~~~~~~~~~~~
/home/runner/work/ESP32-FlightStack/ESP32-FlightStack/RC_FlightController/src/Submodules/Logger/Logger.cpp:157:15: note: 'r.LoggerRow::angle_roll_d' was declared here
  157 |     LoggerRow r; bool ok = false;
      |               ^
/home/runner/work/ESP32-FlightStack/ESP32-FlightStack/RC_FlightController/src/Submodules/Logger/Logger.cpp:200:119: warning: 'r.LoggerRow::angle_roll_out' may be used uninitialized [-Wmaybe-uninitialized]
  200 |     _appendFloat(s,r.angle_roll_p,6); _appendFloat(s,r.angle_roll_i,6); _appendFloat(s,r.angle_roll_d,6); _appendFloat(s,r.angle_roll_out,6);
      |                                                                                                           ~~~~~~~~~~~~^~~~~~~~~~~~~~~~~~~~~~
/home/runner/work/ESP32-FlightStack/ESP32-FlightStack/RC_FlightController/src/Submodules/Logger/Logger.cpp:157:15: note: 'r.LoggerRow::angle_roll_out' was declared here
  157 |     LoggerRow r; bool ok = false;
      |               ^
/home/runner/work/ESP32-FlightStack/ESP32-FlightStack/RC_FlightController/src/Submodules/Logger/Logger.cpp:201:17: warning: 'r.LoggerRow::angle_pitch_p' may be used uninitialized [-Wmaybe-uninitialized]
  201 |     _appendFloat(s,r.angle_pitch_p,6); _appendFloat(s,r.angle_pitch_i,6); _appendFloat(s,r.angle_pitch_d,6); _appendFloat(s,r.angle_pitch_out,6);
      |     ~~~~~~~~~~~~^~~~~~~~~~~~~~~~~~~~~
/home/runner/work/ESP32-FlightStack/ESP32-FlightStack/RC_FlightController/src/Submodules/Logger/Logger.cpp:157:15: note: 'r.LoggerRow::angle_pitch_p' was declared here
  157 |     LoggerRow r; bool ok = false;
      |               ^
/home/runner/work/ESP32-FlightStack/ESP32-FlightStack/RC_FlightController/src/Submodules/Logger/Logger.cpp:201:52: warning: 'r.LoggerRow::angle_pitch_i' may be used uninitialized [-Wmaybe-uninitialized]
  201 |     _appendFloat(s,r.angle_pitch_p,6); _appendFloat(s,r.angle_pitch_i,6); _appendFloat(s,r.angle_pitch_d,6); _appendFloat(s,r.angle_pitch_out,6);
      |                                        ~~~~~~~~~~~~^~~~~~~~~~~~~~~~~~~~~
/home/runner/work/ESP32-FlightStack/ESP32-FlightStack/RC_FlightController/src/Submodules/Logger/Logger.cpp:157:15: note: 'r.LoggerRow::angle_pitch_i' was declared here
  157 |     LoggerRow r; bool ok = false;
      |               ^
/home/runner/work/ESP32-FlightStack/ESP32-FlightStack/RC_FlightController/src/Submodules/Logger/Logger.cpp:201:87: warning: 'r.LoggerRow::angle_pitch_d' may be used uninitialized [-Wmaybe-uninitialized]
  201 |     _appendFloat(s,r.angle_pitch_p,6); _appendFloat(s,r.angle_pitch_i,6); _appendFloat(s,r.angle_pitch_d,6); _appendFloat(s,r.angle_pitch_out,6);
      |                                                                           ~~~~~~~~~~~~^~~~~~~~~~~~~~~~~~~~~
/home/runner/work/ESP32-FlightStack/ESP32-FlightStack/RC_FlightController/src/Submodules/Logger/Logger.cpp:157:15: note: 'r.LoggerRow::angle_pitch_d' was declared here
  157 |     LoggerRow r; bool ok = false;
      |               ^
/home/runner/work/ESP32-FlightStack/ESP32-FlightStack/RC_FlightController/src/Submodules/Logger/Logger.cpp:201:122: warning: 'r.LoggerRow::angle_pitch_out' may be used uninitialized [-Wmaybe-uninitialized]
  201 |     _appendFloat(s,r.angle_pitch_p,6); _appendFloat(s,r.angle_pitch_i,6); _appendFloat(s,r.angle_pitch_d,6); _appendFloat(s,r.angle_pitch_out,6);
      |                                                                                                              ~~~~~~~~~~~~^~~~~~~~~~~~~~~~~~~~~~~
/home/runner/work/ESP32-FlightStack/ESP32-FlightStack/RC_FlightController/src/Submodules/Logger/Logger.cpp:157:15: note: 'r.LoggerRow::angle_pitch_out' was declared here
  157 |     LoggerRow r; bool ok = false;
      |               ^
/home/runner/work/ESP32-FlightStack/ESP32-FlightStack/RC_FlightController/src/Submodules/Logger/Logger.cpp:202:17: warning: 'r.LoggerRow::angle_yaw_p' may be used uninitialized [-Wmaybe-uninitialized]
  202 |     _appendFloat(s,r.angle_yaw_p,6); _appendFloat(s,r.angle_yaw_i,6); _appendFloat(s,r.angle_yaw_d,6); _appendFloat(s,r.angle_yaw_out,6);
      |     ~~~~~~~~~~~~^~~~~~~~~~~~~~~~~~~
/home/runner/work/ESP32-FlightStack/ESP32-FlightStack/RC_FlightController/src/Submodules/Logger/Logger.cpp:157:15: note: 'r.LoggerRow::angle_yaw_p' was declared here
  157 |     LoggerRow r; bool ok = false;
      |               ^
/home/runner/work/ESP32-FlightStack/ESP32-FlightStack/RC_FlightController/src/Submodules/Logger/Logger.cpp:202:50: warning: 'r.LoggerRow::angle_yaw_i' may be used uninitialized [-Wmaybe-uninitialized]
  202 |     _appendFloat(s,r.angle_yaw_p,6); _appendFloat(s,r.angle_yaw_i,6); _appendFloat(s,r.angle_yaw_d,6); _appendFloat(s,r.angle_yaw_out,6);
      |                                      ~~~~~~~~~~~~^~~~~~~~~~~~~~~~~~~
/home/runner/work/ESP32-FlightStack/ESP32-FlightStack/RC_FlightController/src/Submodules/Logger/Logger.cpp:157:15: note: 'r.LoggerRow::angle_yaw_i' was declared here
  157 |     LoggerRow r; bool ok = false;
      |               ^
/home/runner/work/ESP32-FlightStack/ESP32-FlightStack/RC_FlightController/src/Submodules/Logger/Logger.cpp:202:83: warning: 'r.LoggerRow::angle_yaw_d' may be used uninitialized [-Wmaybe-uninitialized]
  202 |     _appendFloat(s,r.angle_yaw_p,6); _appendFloat(s,r.angle_yaw_i,6); _appendFloat(s,r.angle_yaw_d,6); _appendFloat(s,r.angle_yaw_out,6);
      |                                                                       ~~~~~~~~~~~~^~~~~~~~~~~~~~~~~~~
/home/runner/work/ESP32-FlightStack/ESP32-FlightStack/RC_FlightController/src/Submodules/Logger/Logger.cpp:157:15: note: 'r.LoggerRow::angle_yaw_d' was declared here
  157 |     LoggerRow r; bool ok = false;
      |               ^
/home/runner/work/ESP32-FlightStack/ESP32-FlightStack/RC_FlightController/src/Submodules/Logger/Logger.cpp:202:116: warning: 'r.LoggerRow::angle_yaw_out' may be used uninitialized [-Wmaybe-uninitialized]
  202 |     _appendFloat(s,r.angle_yaw_p,6); _appendFloat(s,r.angle_yaw_i,6); _appendFloat(s,r.angle_yaw_d,6); _appendFloat(s,r.angle_yaw_out,6);
      |                                                                                                        ~~~~~~~~~~~~^~~~~~~~~~~~~~~~~~~~~
/home/runner/work/ESP32-FlightStack/ESP32-FlightStack/RC_FlightController/src/Submodules/Logger/Logger.cpp:157:15: note: 'r.LoggerRow::angle_yaw_out' was declared here
  157 |     LoggerRow r; bool ok = false;
      |               ^
/home/runner/work/ESP32-FlightStack/ESP32-FlightStack/RC_FlightController/src/Submodules/Logger/Logger.cpp:203:17: warning: 'r.LoggerRow::rate_roll_p' may be used uninitialized [-Wmaybe-uninitialized]
  203 |     _appendFloat(s,r.rate_roll_p,6); _appendFloat(s,r.rate_roll_i,6); _appendFloat(s,r.rate_roll_d,6); _appendFloat(s,r.rate_roll_out,6);
      |     ~~~~~~~~~~~~^~~~~~~~~~~~~~~~~~~
/home/runner/work/ESP32-FlightStack/ESP32-FlightStack/RC_FlightController/src/Submodules/Logger/Logger.cpp:157:15: note: 'r.LoggerRow::rate_roll_p' was declared here
  157 |     LoggerRow r; bool ok = false;
      |               ^
/home/runner/work/ESP32-FlightStack/ESP32-FlightStack/RC_FlightController/src/Submodules/Logger/Logger.cpp:203:50: warning: 'r.LoggerRow::rate_roll_i' may be used uninitialized [-Wmaybe-uninitialized]
  203 |     _appendFloat(s,r.rate_roll_p,6); _appendFloat(s,r.rate_roll_i,6); _appendFloat(s,r.rate_roll_d,6); _appendFloat(s,r.rate_roll_out,6);
      |                                      ~~~~~~~~~~~~^~~~~~~~~~~~~~~~~~~
/home/runner/work/ESP32-FlightStack/ESP32-FlightStack/RC_FlightController/src/Submodules/Logger/Logger.cpp:157:15: note: 'r.LoggerRow::rate_roll_i' was declared here
  157 |     LoggerRow r; bool ok = false;
      |               ^
/home/runner/work/ESP32-FlightStack/ESP32-FlightStack/RC_FlightController/src/Submodules/Logger/Logger.cpp:203:83: warning: 'r.LoggerRow::rate_roll_d' may be used uninitialized [-Wmaybe-uninitialized]
  203 |     _appendFloat(s,r.rate_roll_p,6); _appendFloat(s,r.rate_roll_i,6); _appendFloat(s,r.rate_roll_d,6); _appendFloat(s,r.rate_roll_out,6);
      |                                                                       ~~~~~~~~~~~~^~~~~~~~~~~~~~~~~~~
/home/runner/work/ESP32-FlightStack/ESP32-FlightStack/RC_FlightController/src/Submodules/Logger/Logger.cpp:157:15: note: 'r.LoggerRow::rate_roll_d' was declared here
  157 |     LoggerRow r; bool ok = false;
      |               ^
/home/runner/work/ESP32-FlightStack/ESP32-FlightStack/RC_FlightController/src/Submodules/Logger/Logger.cpp:203:116: warning: 'r.LoggerRow::rate_roll_out' may be used uninitialized [-Wmaybe-uninitialized]
  203 |     _appendFloat(s,r.rate_roll_p,6); _appendFloat(s,r.rate_roll_i,6); _appendFloat(s,r.rate_roll_d,6); _appendFloat(s,r.rate_roll_out,6);
      |                                                                                                        ~~~~~~~~~~~~^~~~~~~~~~~~~~~~~~~~~
/home/runner/work/ESP32-FlightStack/ESP32-FlightStack/RC_FlightController/src/Submodules/Logger/Logger.cpp:157:15: note: 'r.LoggerRow::rate_roll_out' was declared here
  157 |     LoggerRow r; bool ok = false;
      |               ^
/home/runner/work/ESP32-FlightStack/ESP32-FlightStack/RC_FlightController/src/Submodules/Logger/Logger.cpp:204:17: warning: 'r.LoggerRow::rate_pitch_p' may be used uninitialized [-Wmaybe-uninitialized]
  204 |     _appendFloat(s,r.rate_pitch_p,6); _appendFloat(s,r.rate_pitch_i,6); _appendFloat(s,r.rate_pitch_d,6); _appendFloat(s,r.rate_pitch_out,6);
      |     ~~~~~~~~~~~~^~~~~~~~~~~~~~~~~~~~
/home/runner/work/ESP32-FlightStack/ESP32-FlightStack/RC_FlightController/src/Submodules/Logger/Logger.cpp:157:15: note: 'r.LoggerRow::rate_pitch_p' was declared here
  157 |     LoggerRow r; bool ok = false;
      |               ^
/home/runner/work/ESP32-FlightStack/ESP32-FlightStack/RC_FlightController/src/Submodules/Logger/Logger.cpp:204:51: warning: 'r.LoggerRow::rate_pitch_i' may be used uninitialized [-Wmaybe-uninitialized]
  204 |     _appendFloat(s,r.rate_pitch_p,6); _appendFloat(s,r.rate_pitch_i,6); _appendFloat(s,r.rate_pitch_d,6); _appendFloat(s,r.rate_pitch_out,6);
      |                                       ~~~~~~~~~~~~^~~~~~~~~~~~~~~~~~~~
/home/runner/work/ESP32-FlightStack/ESP32-FlightStack/RC_FlightController/src/Submodules/Logger/Logger.cpp:157:15: note: 'r.LoggerRow::rate_pitch_i' was declared here
  157 |     LoggerRow r; bool ok = false;
      |               ^
/home/runner/work/ESP32-FlightStack/ESP32-FlightStack/RC_FlightController/src/Submodules/Logger/Logger.cpp:204:85: warning: 'r.LoggerRow::rate_pitch_d' may be used uninitialized [-Wmaybe-uninitialized]
  204 |     _appendFloat(s,r.rate_pitch_p,6); _appendFloat(s,r.rate_pitch_i,6); _appendFloat(s,r.rate_pitch_d,6); _appendFloat(s,r.rate_pitch_out,6);
      |                                                                         ~~~~~~~~~~~~^~~~~~~~~~~~~~~~~~~~
/home/runner/work/ESP32-FlightStack/ESP32-FlightStack/RC_FlightController/src/Submodules/Logger/Logger.cpp:157:15: note: 'r.LoggerRow::rate_pitch_d' was declared here
  157 |     LoggerRow r; bool ok = false;
      |               ^
/home/runner/work/ESP32-FlightStack/ESP32-FlightStack/RC_FlightController/src/Submodules/Logger/Logger.cpp:204:119: warning: 'r.LoggerRow::rate_pitch_out' may be used uninitialized [-Wmaybe-uninitialized]
  204 |     _appendFloat(s,r.rate_pitch_p,6); _appendFloat(s,r.rate_pitch_i,6); _appendFloat(s,r.rate_pitch_d,6); _appendFloat(s,r.rate_pitch_out,6);
      |                                                                                                           ~~~~~~~~~~~~^~~~~~~~~~~~~~~~~~~~~~
/home/runner/work/ESP32-FlightStack/ESP32-FlightStack/RC_FlightController/src/Submodules/Logger/Logger.cpp:157:15: note: 'r.LoggerRow::rate_pitch_out' was declared here
  157 |     LoggerRow r; bool ok = false;
      |               ^
/home/runner/work/ESP32-FlightStack/ESP32-FlightStack/RC_FlightController/src/Submodules/Logger/Logger.cpp:205:17: warning: 'r.LoggerRow::rate_yaw_p' may be used uninitialized [-Wmaybe-uninitialized]
  205 |     _appendFloat(s,r.rate_yaw_p,6); _appendFloat(s,r.rate_yaw_i,6); _appendFloat(s,r.rate_yaw_d,6); _appendFloat(s,r.rate_yaw_out,6);
      |     ~~~~~~~~~~~~^~~~~~~~~~~~~~~~~~
/home/runner/work/ESP32-FlightStack/ESP32-FlightStack/RC_FlightController/src/Submodules/Logger/Logger.cpp:157:15: note: 'r.LoggerRow::rate_yaw_p' was declared here
  157 |     LoggerRow r; bool ok = false;
      |               ^
/home/runner/work/ESP32-FlightStack/ESP32-FlightStack/RC_FlightController/src/Submodules/Logger/Logger.cpp:205:49: warning: 'r.LoggerRow::rate_yaw_i' may be used uninitialized [-Wmaybe-uninitialized]
  205 |     _appendFloat(s,r.rate_yaw_p,6); _appendFloat(s,r.rate_yaw_i,6); _appendFloat(s,r.rate_yaw_d,6); _appendFloat(s,r.rate_yaw_out,6);
      |                                     ~~~~~~~~~~~~^~~~~~~~~~~~~~~~~~
/home/runner/work/ESP32-FlightStack/ESP32-FlightStack/RC_FlightController/src/Submodules/Logger/Logger.cpp:157:15: note: 'r.LoggerRow::rate_yaw_i' was declared here
  157 |     LoggerRow r; bool ok = false;
      |               ^
/home/runner/work/ESP32-FlightStack/ESP32-FlightStack/RC_FlightController/src/Submodules/Logger/Logger.cpp:205:81: warning: 'r.LoggerRow::rate_yaw_d' may be used uninitialized [-Wmaybe-uninitialized]
  205 |     _appendFloat(s,r.rate_yaw_p,6); _appendFloat(s,r.rate_yaw_i,6); _appendFloat(s,r.rate_yaw_d,6); _appendFloat(s,r.rate_yaw_out,6);
      |                                                                     ~~~~~~~~~~~~^~~~~~~~~~~~~~~~~~
/home/runner/work/ESP32-FlightStack/ESP32-FlightStack/RC_FlightController/src/Submodules/Logger/Logger.cpp:157:15: note: 'r.LoggerRow::rate_yaw_d' was declared here
  157 |     LoggerRow r; bool ok = false;
      |               ^
/home/runner/work/ESP32-FlightStack/ESP32-FlightStack/RC_FlightController/src/Submodules/Logger/Logger.cpp:205:113: warning: 'r.LoggerRow::rate_yaw_out' may be used uninitialized [-Wmaybe-uninitialized]
  205 |     _appendFloat(s,r.rate_yaw_p,6); _appendFloat(s,r.rate_yaw_i,6); _appendFloat(s,r.rate_yaw_d,6); _appendFloat(s,r.rate_yaw_out,6);
      |                                                                                                     ~~~~~~~~~~~~^~~~~~~~~~~~~~~~~~~~
/home/runner/work/ESP32-FlightStack/ESP32-FlightStack/RC_FlightController/src/Submodules/Logger/Logger.cpp:157:15: note: 'r.LoggerRow::rate_yaw_out' was declared here
  157 |     LoggerRow r; bool ok = false;
      |               ^
/home/runner/work/ESP32-FlightStack/ESP32-FlightStack/RC_FlightController/src/Submodules/Logger/Logger.cpp:207:17: warning: 'r.LoggerRow::motor_fl_pre' may be used uninitialized [-Wmaybe-uninitialized]
  207 |     _appendFloat(s,r.motor_fl_pre,4); _appendFloat(s,r.motor_fr_pre,4); _appendFloat(s,r.motor_rl_pre,4); _appendFloat(s,r.motor_rr_pre,4);
      |     ~~~~~~~~~~~~^~~~~~~~~~~~~~~~~~~~
/home/runner/work/ESP32-FlightStack/ESP32-FlightStack/RC_FlightController/src/Submodules/Logger/Logger.cpp:157:15: note: 'r.LoggerRow::motor_fl_pre' was declared here
  157 |     LoggerRow r; bool ok = false;
      |               ^
/home/runner/work/ESP32-FlightStack/ESP32-FlightStack/RC_FlightController/src/Submodules/Logger/Logger.cpp:207:51: warning: 'r.LoggerRow::motor_fr_pre' may be used uninitialized [-Wmaybe-uninitialized]
  207 |     _appendFloat(s,r.motor_fl_pre,4); _appendFloat(s,r.motor_fr_pre,4); _appendFloat(s,r.motor_rl_pre,4); _appendFloat(s,r.motor_rr_pre,4);
      |                                       ~~~~~~~~~~~~^~~~~~~~~~~~~~~~~~~~
/home/runner/work/ESP32-FlightStack/ESP32-FlightStack/RC_FlightController/src/Submodules/Logger/Logger.cpp:157:15: note: 'r.LoggerRow::motor_fr_pre' was declared here
  157 |     LoggerRow r; bool ok = false;
      |               ^
/home/runner/work/ESP32-FlightStack/ESP32-FlightStack/RC_FlightController/src/Submodules/Logger/Logger.cpp:207:85: warning: 'r.LoggerRow::motor_rl_pre' may be used uninitialized [-Wmaybe-uninitialized]
  207 |     _appendFloat(s,r.motor_fl_pre,4); _appendFloat(s,r.motor_fr_pre,4); _appendFloat(s,r.motor_rl_pre,4); _appendFloat(s,r.motor_rr_pre,4);
      |                                                                         ~~~~~~~~~~~~^~~~~~~~~~~~~~~~~~~~
/home/runner/work/ESP32-FlightStack/ESP32-FlightStack/RC_FlightController/src/Submodules/Logger/Logger.cpp:157:15: note: 'r.LoggerRow::motor_rl_pre' was declared here
  157 |     LoggerRow r; bool ok = false;
      |               ^
/home/runner/work/ESP32-FlightStack/ESP32-FlightStack/RC_FlightController/src/Submodules/Logger/Logger.cpp:207:119: warning: 'r.LoggerRow::motor_rr_pre' may be used uninitialized [-Wmaybe-uninitialized]
  207 |     _appendFloat(s,r.motor_fl_pre,4); _appendFloat(s,r.motor_fr_pre,4); _appendFloat(s,r.motor_rl_pre,4); _appendFloat(s,r.motor_rr_pre,4);
      |                                                                                                           ~~~~~~~~~~~~^~~~~~~~~~~~~~~~~~~~
/home/runner/work/ESP32-FlightStack/ESP32-FlightStack/RC_FlightController/src/Submodules/Logger/Logger.cpp:157:15: note: 'r.LoggerRow::motor_rr_pre' was declared here
  157 |     LoggerRow r; bool ok = false;
      |               ^
/home/runner/work/ESP32-FlightStack/ESP32-FlightStack/RC_FlightController/src/Submodules/Logger/Logger.cpp:208:17: warning: 'r.LoggerRow::motor_fl' may be used uninitialized [-Wmaybe-uninitialized]
  208 |     _appendFloat(s,r.motor_fl,4); _appendFloat(s,r.motor_fr,4); _appendFloat(s,r.motor_rl,4); _appendFloat(s,r.motor_rr,4);
      |     ~~~~~~~~~~~~^~~~~~~~~~~~~~~~
/home/runner/work/ESP32-FlightStack/ESP32-FlightStack/RC_FlightController/src/Submodules/Logger/Logger.cpp:157:15: note: 'r.LoggerRow::motor_fl' was declared here
  157 |     LoggerRow r; bool ok = false;
      |               ^
/home/runner/work/ESP32-FlightStack/ESP32-FlightStack/RC_FlightController/src/Submodules/Logger/Logger.cpp:208:47: warning: 'r.LoggerRow::motor_fr' may be used uninitialized [-Wmaybe-uninitialized]
  208 |     _appendFloat(s,r.motor_fl,4); _appendFloat(s,r.motor_fr,4); _appendFloat(s,r.motor_rl,4); _appendFloat(s,r.motor_rr,4);
      |                                   ~~~~~~~~~~~~^~~~~~~~~~~~~~~~
/home/runner/work/ESP32-FlightStack/ESP32-FlightStack/RC_FlightController/src/Submodules/Logger/Logger.cpp:157:15: note: 'r.LoggerRow::motor_fr' was declared here
  157 |     LoggerRow r; bool ok = false;
      |               ^
/home/runner/work/ESP32-FlightStack/ESP32-FlightStack/RC_FlightController/src/Submodules/Logger/Logger.cpp:208:77: warning: 'r.LoggerRow::motor_rl' may be used uninitialized [-Wmaybe-uninitialized]
  208 |     _appendFloat(s,r.motor_fl,4); _appendFloat(s,r.motor_fr,4); _appendFloat(s,r.motor_rl,4); _appendFloat(s,r.motor_rr,4);
      |                                                                 ~~~~~~~~~~~~^~~~~~~~~~~~~~~~
/home/runner/work/ESP32-FlightStack/ESP32-FlightStack/RC_FlightController/src/Submodules/Logger/Logger.cpp:157:15: note: 'r.LoggerRow::motor_rl' was declared here
  157 |     LoggerRow r; bool ok = false;
      |               ^
/home/runner/work/ESP32-FlightStack/ESP32-FlightStack/RC_FlightController/src/Submodules/Logger/Logger.cpp:208:107: warning: 'r.LoggerRow::motor_rr' may be used uninitialized [-Wmaybe-uninitialized]
  208 |     _appendFloat(s,r.motor_fl,4); _appendFloat(s,r.motor_fr,4); _appendFloat(s,r.motor_rl,4); _appendFloat(s,r.motor_rr,4);
      |                                                                                               ~~~~~~~~~~~~^~~~~~~~~~~~~~~~
/home/runner/work/ESP32-FlightStack/ESP32-FlightStack/RC_FlightController/src/Submodules/Logger/Logger.cpp:157:15: note: 'r.LoggerRow::motor_rr' was declared here
  157 |     LoggerRow r; bool ok = false;
      |               ^
/home/runner/work/ESP32-FlightStack/ESP32-FlightStack/RC_FlightController/src/Submodules/Logger/Logger.cpp:209:17: warning: 'r.LoggerRow::motor_diag_a' may be used uninitialized [-Wmaybe-uninitialized]
  209 |     _appendFloat(s,r.motor_diag_a,4); _appendFloat(s,r.motor_diag_b,4); _appendFloat(s,r.motor_diag_diff,4);
      |     ~~~~~~~~~~~~^~~~~~~~~~~~~~~~~~~~
/home/runner/work/ESP32-FlightStack/ESP32-FlightStack/RC_FlightController/src/Submodules/Logger/Logger.cpp:157:15: note: 'r.LoggerRow::motor_diag_a' was declared here
  157 |     LoggerRow r; bool ok = false;
      |               ^
/home/runner/work/ESP32-FlightStack/ESP32-FlightStack/RC_FlightController/src/Submodules/Logger/Logger.cpp:209:51: warning: 'r.LoggerRow::motor_diag_b' may be used uninitialized [-Wmaybe-uninitialized]
  209 |     _appendFloat(s,r.motor_diag_a,4); _appendFloat(s,r.motor_diag_b,4); _appendFloat(s,r.motor_diag_diff,4);
      |                                       ~~~~~~~~~~~~^~~~~~~~~~~~~~~~~~~~
/home/runner/work/ESP32-FlightStack/ESP32-FlightStack/RC_FlightController/src/Submodules/Logger/Logger.cpp:157:15: note: 'r.LoggerRow::motor_diag_b' was declared here
  157 |     LoggerRow r; bool ok = false;
      |               ^
/home/runner/work/ESP32-FlightStack/ESP32-FlightStack/RC_FlightController/src/Submodules/Logger/Logger.cpp:209:85: warning: 'r.LoggerRow::motor_diag_diff' may be used uninitialized [-Wmaybe-uninitialized]
  209 |     _appendFloat(s,r.motor_diag_a,4); _appendFloat(s,r.motor_diag_b,4); _appendFloat(s,r.motor_diag_diff,4);
      |                                                                         ~~~~~~~~~~~~^~~~~~~~~~~~~~~~~~~~~~~
/home/runner/work/ESP32-FlightStack/ESP32-FlightStack/RC_FlightController/src/Submodules/Logger/Logger.cpp:157:15: note: 'r.LoggerRow::motor_diag_diff' was declared here
  157 |     LoggerRow r; bool ok = false;
      |               ^
/home/runner/work/ESP32-FlightStack/ESP32-FlightStack/RC_FlightController/src/Submodules/Logger/Logger.cpp:210:17: warning: 'r.LoggerRow::rpm_fl' may be used uninitialized [-Wmaybe-uninitialized]
  210 |     _appendFloat(s,r.rpm_fl,0); _appendFloat(s,r.rpm_fr,0); _appendFloat(s,r.rpm_rl,0); _appendFloat(s,r.rpm_rr,0);
      |     ~~~~~~~~~~~~^~~~~~~~~~~~~~
/home/runner/work/ESP32-FlightStack/ESP32-FlightStack/RC_FlightController/src/Submodules/Logger/Logger.cpp:157:15: note: 'r.LoggerRow::rpm_fl' was declared here
  157 |     LoggerRow r; bool ok = false;
      |               ^
/home/runner/work/ESP32-FlightStack/ESP32-FlightStack/RC_FlightController/src/Submodules/Logger/Logger.cpp:210:45: warning: 'r.LoggerRow::rpm_fr' may be used uninitialized [-Wmaybe-uninitialized]
  210 |     _appendFloat(s,r.rpm_fl,0); _appendFloat(s,r.rpm_fr,0); _appendFloat(s,r.rpm_rl,0); _appendFloat(s,r.rpm_rr,0);
      |                                 ~~~~~~~~~~~~^~~~~~~~~~~~~~
/home/runner/work/ESP32-FlightStack/ESP32-FlightStack/RC_FlightController/src/Submodules/Logger/Logger.cpp:157:15: note: 'r.LoggerRow::rpm_fr' was declared here
  157 |     LoggerRow r; bool ok = false;
      |               ^
/home/runner/work/ESP32-FlightStack/ESP32-FlightStack/RC_FlightController/src/Submodules/Logger/Logger.cpp:210:73: warning: 'r.LoggerRow::rpm_rl' may be used uninitialized [-Wmaybe-uninitialized]
  210 |     _appendFloat(s,r.rpm_fl,0); _appendFloat(s,r.rpm_fr,0); _appendFloat(s,r.rpm_rl,0); _appendFloat(s,r.rpm_rr,0);
      |                                                             ~~~~~~~~~~~~^~~~~~~~~~~~~~
/home/runner/work/ESP32-FlightStack/ESP32-FlightStack/RC_FlightController/src/Submodules/Logger/Logger.cpp:157:15: note: 'r.LoggerRow::rpm_rl' was declared here
  157 |     LoggerRow r; bool ok = false;
      |               ^
/home/runner/work/ESP32-FlightStack/ESP32-FlightStack/RC_FlightController/src/Submodules/Logger/Logger.cpp:210:101: warning: 'r.LoggerRow::rpm_rr' may be used uninitialized [-Wmaybe-uninitialized]
  210 |     _appendFloat(s,r.rpm_fl,0); _appendFloat(s,r.rpm_fr,0); _appendFloat(s,r.rpm_rl,0); _appendFloat(s,r.rpm_rr,0);
      |                                                                                         ~~~~~~~~~~~~^~~~~~~~~~~~~~
/home/runner/work/ESP32-FlightStack/ESP32-FlightStack/RC_FlightController/src/Submodules/Logger/Logger.cpp:157:15: note: 'r.LoggerRow::rpm_rr' was declared here
  157 |     LoggerRow r; bool ok = false;
      |               ^
/home/runner/work/ESP32-FlightStack/ESP32-FlightStack/RC_FlightController/src/Submodules/Logger/Logger.cpp:211:17: warning: 'r.LoggerRow::rpm_diag_a' may be used uninitialized [-Wmaybe-uninitialized]
  211 |     _appendFloat(s,r.rpm_diag_a,0); _appendFloat(s,r.rpm_diag_b,0); _appendFloat(s,r.rpm_diag_diff,0);
      |     ~~~~~~~~~~~~^~~~~~~~~~~~~~~~~~
/home/runner/work/ESP32-FlightStack/ESP32-FlightStack/RC_FlightController/src/Submodules/Logger/Logger.cpp:157:15: note: 'r.LoggerRow::rpm_diag_a' was declared here
  157 |     LoggerRow r; bool ok = false;
      |               ^
/home/runner/work/ESP32-FlightStack/ESP32-FlightStack/RC_FlightController/src/Submodules/Logger/Logger.cpp:211:49: warning: 'r.LoggerRow::rpm_diag_b' may be used uninitialized [-Wmaybe-uninitialized]
  211 |     _appendFloat(s,r.rpm_diag_a,0); _appendFloat(s,r.rpm_diag_b,0); _appendFloat(s,r.rpm_diag_diff,0);
      |                                     ~~~~~~~~~~~~^~~~~~~~~~~~~~~~~~
/home/runner/work/ESP32-FlightStack/ESP32-FlightStack/RC_FlightController/src/Submodules/Logger/Logger.cpp:157:15: note: 'r.LoggerRow::rpm_diag_b' was declared here
  157 |     LoggerRow r; bool ok = false;
      |               ^
/home/runner/work/ESP32-FlightStack/ESP32-FlightStack/RC_FlightController/src/Submodules/Logger/Logger.cpp:211:81: warning: 'r.LoggerRow::rpm_diag_diff' may be used uninitialized [-Wmaybe-uninitialized]
  211 |     _appendFloat(s,r.rpm_diag_a,0); _appendFloat(s,r.rpm_diag_b,0); _appendFloat(s,r.rpm_diag_diff,0);
      |                                                                     ~~~~~~~~~~~~^~~~~~~~~~~~~~~~~~~~~
/home/runner/work/ESP32-FlightStack/ESP32-FlightStack/RC_FlightController/src/Submodules/Logger/Logger.cpp:157:15: note: 'r.LoggerRow::rpm_diag_diff' was declared here
  157 |     LoggerRow r; bool ok = false;
      |               ^
/home/runner/work/ESP32-FlightStack/ESP32-FlightStack/RC_FlightController/src/Submodules/Logger/Logger.cpp:212:17: warning: 'r.LoggerRow::battery_v' may be used uninitialized [-Wmaybe-uninitialized]
  212 |     _appendFloat(s,r.battery_v,3); _appendFloat(s,r.cpu0_pct,1); _appendFloat(s,r.cpu1_pct,1);
      |     ~~~~~~~~~~~~^~~~~~~~~~~~~~~~~
/home/runner/work/ESP32-FlightStack/ESP32-FlightStack/RC_FlightController/src/Submodules/Logger/Logger.cpp:157:15: note: 'r.LoggerRow::battery_v' was declared here
  157 |     LoggerRow r; bool ok = false;
      |               ^
/home/runner/work/ESP32-FlightStack/ESP32-FlightStack/RC_FlightController/src/Submodules/Logger/Logger.cpp:212:48: warning: 'r.LoggerRow::cpu0_pct' may be used uninitialized [-Wmaybe-uninitialized]
  212 |     _appendFloat(s,r.battery_v,3); _appendFloat(s,r.cpu0_pct,1); _appendFloat(s,r.cpu1_pct,1);
      |                                    ~~~~~~~~~~~~^~~~~~~~~~~~~~~~
/home/runner/work/ESP32-FlightStack/ESP32-FlightStack/RC_FlightController/src/Submodules/Logger/Logger.cpp:157:15: note: 'r.LoggerRow::cpu0_pct' was declared here
  157 |     LoggerRow r; bool ok = false;
      |               ^
/home/runner/work/ESP32-FlightStack/ESP32-FlightStack/RC_FlightController/src/Submodules/Logger/Logger.cpp:212:78: warning: 'r.LoggerRow::cpu1_pct' may be used uninitialized [-Wmaybe-uninitialized]
  212 |     _appendFloat(s,r.battery_v,3); _appendFloat(s,r.cpu0_pct,1); _appendFloat(s,r.cpu1_pct,1);
      |                                                                  ~~~~~~~~~~~~^~~~~~~~~~~~~~~~
/home/runner/work/ESP32-FlightStack/ESP32-FlightStack/RC_FlightController/src/Submodules/Logger/Logger.cpp:157:15: note: 'r.LoggerRow::cpu1_pct' was declared here
  157 |     LoggerRow r; bool ok = false;
      |               ^
/home/runner/work/ESP32-FlightStack/ESP32-FlightStack/RC_FlightController/src/Submodules/Logger/Logger.cpp:213:17: warning: 'r.LoggerRow::notch_freq_hz' may be used uninitialized [-Wmaybe-uninitialized]
  213 |     _appendFloat(s,r.notch_freq_hz,2); _appendFloat(s,r.notch_q,2); s += ','; s += String(r.notch_enable);
      |     ~~~~~~~~~~~~^~~~~~~~~~~~~~~~~~~~~
/home/runner/work/ESP32-FlightStack/ESP32-FlightStack/RC_FlightController/src/Submodules/Logger/Logger.cpp:157:15: note: 'r.LoggerRow::notch_freq_hz' was declared here
  157 |     LoggerRow r; bool ok = false;
      |               ^
/home/runner/work/ESP32-FlightStack/ESP32-FlightStack/RC_FlightController/src/Submodules/Logger/Logger.cpp:213:52: warning: 'r.LoggerRow::notch_q' may be used uninitialized [-Wmaybe-uninitialized]
  213 |     _appendFloat(s,r.notch_freq_hz,2); _appendFloat(s,r.notch_q,2); s += ','; s += String(r.notch_enable);
      |                                        ~~~~~~~~~~~~^~~~~~~~~~~~~~~
/home/runner/work/ESP32-FlightStack/ESP32-FlightStack/RC_FlightController/src/Submodules/Logger/Logger.cpp:157:15: note: 'r.LoggerRow::notch_q' was declared here
  157 |     LoggerRow r; bool ok = false;
      |               ^
/home/runner/work/ESP32-FlightStack/ESP32-FlightStack/RC_FlightController/src/Submodules/Logger/Logger.cpp:213:105: warning: 'r.LoggerRow::notch_enable' may be used uninitialized [-Wmaybe-uninitialized]
  213 |     _appendFloat(s,r.notch_freq_hz,2); _appendFloat(s,r.notch_q,2); s += ','; s += String(r.notch_enable);
      |                                                                                                         ^
/home/runner/work/ESP32-FlightStack/ESP32-FlightStack/RC_FlightController/src/Submodules/Logger/Logger.cpp:157:15: note: 'r.LoggerRow::notch_enable' was declared here
  157 |     LoggerRow r; bool ok = false;
      |               ^
/home/runner/work/ESP32-FlightStack/ESP32-FlightStack/RC_FlightController/src/Submodules/Logger/Logger.cpp:214:17: warning: 'r.LoggerRow::bmp_alt_m' may be used uninitialized [-Wmaybe-uninitialized]
  214 |     _appendFloat(s,r.bmp_alt_m,3); _appendFloat(s,r.bmp_vz_mps,3);
      |     ~~~~~~~~~~~~^~~~~~~~~~~~~~~~~
/home/runner/work/ESP32-FlightStack/ESP32-FlightStack/RC_FlightController/src/Submodules/Logger/Logger.cpp:157:15: note: 'r.LoggerRow::bmp_alt_m' was declared here
  157 |     LoggerRow r; bool ok = false;
      |               ^
/home/runner/work/ESP32-FlightStack/ESP32-FlightStack/RC_FlightController/src/Submodules/Logger/Logger.cpp:214:48: warning: 'r.LoggerRow::bmp_vz_mps' may be used uninitialized [-Wmaybe-uninitialized]
  214 |     _appendFloat(s,r.bmp_alt_m,3); _appendFloat(s,r.bmp_vz_mps,3);
      |                                    ~~~~~~~~~~~~^~~~~~~~~~~~~~~~~~
/home/runner/work/ESP32-FlightStack/ESP32-FlightStack/RC_FlightController/src/Submodules/Logger/Logger.cpp:157:15: note: 'r.LoggerRow::bmp_vz_mps' was declared here
  157 |     LoggerRow r; bool ok = false;
      |               ^
/home/runner/work/ESP32-FlightStack/ESP32-FlightStack/RC_FlightController/src/Submodules/Logger/Logger.cpp:215:17: warning: 'r.LoggerRow::tof_distance_m' may be used uninitialized [-Wmaybe-uninitialized]
  215 |     _appendFloat(s,r.tof_distance_m,3); s += ','; s += String(r.tof_distance_mm);
      |     ~~~~~~~~~~~~^~~~~~~~~~~~~~~~~~~~~~
/home/runner/work/ESP32-FlightStack/ESP32-FlightStack/RC_FlightController/src/Submodules/Logger/Logger.cpp:157:15: note: 'r.LoggerRow::tof_distance_m' was declared here
  157 |     LoggerRow r; bool ok = false;
      |               ^
/home/runner/work/ESP32-FlightStack/ESP32-FlightStack/RC_FlightController/src/Submodules/Logger/Logger.cpp:215:80: warning: 'r.LoggerRow::tof_distance_mm' may be used uninitialized [-Wmaybe-uninitialized]
  215 |     _appendFloat(s,r.tof_distance_m,3); s += ','; s += String(r.tof_distance_mm);
      |                                                                                ^
/home/runner/work/ESP32-FlightStack/ESP32-FlightStack/RC_FlightController/src/Submodules/Logger/Logger.cpp:157:15: note: 'r.LoggerRow::tof_distance_mm' was declared here
  157 |     LoggerRow r; bool ok = false;
      |               ^
/home/runner/work/ESP32-FlightStack/ESP32-FlightStack/RC_FlightController/src/Submodules/Logger/Logger.cpp:216:45: warning: 'r.LoggerRow::tof_range_status' may be used uninitialized [-Wmaybe-uninitialized]
  216 |     s += ','; s += String(r.tof_range_status); s += ','; s += String(r.tof_object_count);
      |                                             ^
/home/runner/work/ESP32-FlightStack/ESP32-FlightStack/RC_FlightController/src/Submodules/Logger/Logger.cpp:157:15: note: 'r.LoggerRow::tof_range_status' was declared here
  157 |     LoggerRow r; bool ok = false;
      |               ^
/home/runner/work/ESP32-FlightStack/ESP32-FlightStack/RC_FlightController/src/Submodules/Logger/Logger.cpp:216:88: warning: 'r.LoggerRow::tof_object_count' may be used uninitialized [-Wmaybe-uninitialized]
  216 |     s += ','; s += String(r.tof_range_status); s += ','; s += String(r.tof_object_count);
      |                                                                                        ^
/home/runner/work/ESP32-FlightStack/ESP32-FlightStack/RC_FlightController/src/Submodules/Logger/Logger.cpp:157:15: note: 'r.LoggerRow::tof_object_count' was declared here
  157 |     LoggerRow r; bool ok = false;
      |               ^
/home/runner/work/ESP32-FlightStack/ESP32-FlightStack/RC_FlightController/src/Submodules/Logger/Logger.cpp:217:45: warning: 'r.LoggerRow::tof_stream_count' may be used uninitialized [-Wmaybe-uninitialized]
  217 |     s += ','; s += String(r.tof_stream_count);
      |                                             ^
/home/runner/work/ESP32-FlightStack/ESP32-FlightStack/RC_FlightController/src/Submodules/Logger/Logger.cpp:157:15: note: 'r.LoggerRow::tof_stream_count' was declared here
  157 |     LoggerRow r; bool ok = false;
      |               ^
/home/runner/work/ESP32-FlightStack/ESP32-FlightStack/RC_FlightController/src/Submodules/Logger/Logger.cpp:218:17: warning: 'r.LoggerRow::tof_signal_mcps' may be used uninitialized [-Wmaybe-uninitialized]
  218 |     _appendFloat(s,r.tof_signal_mcps,3); _appendFloat(s,r.tof_ambient_mcps,3);
      |     ~~~~~~~~~~~~^~~~~~~~~~~~~~~~~~~~~~~
/home/runner/work/ESP32-FlightStack/ESP32-FlightStack/RC_FlightController/src/Submodules/Logger/Logger.cpp:157:15: note: 'r.LoggerRow::tof_signal_mcps' was declared here
  157 |     LoggerRow r; bool ok = false;
      |               ^
/home/runner/work/ESP32-FlightStack/ESP32-FlightStack/RC_FlightController/src/Submodules/Logger/Logger.cpp:218:54: warning: 'r.LoggerRow::tof_ambient_mcps' may be used uninitialized [-Wmaybe-uninitialized]
  218 |     _appendFloat(s,r.tof_signal_mcps,3); _appendFloat(s,r.tof_ambient_mcps,3);
      |                                          ~~~~~~~~~~~~^~~~~~~~~~~~~~~~~~~~~~~~
/home/runner/work/ESP32-FlightStack/ESP32-FlightStack/RC_FlightController/src/Submodules/Logger/Logger.cpp:157:15: note: 'r.LoggerRow::tof_ambient_mcps' was declared here
  157 |     LoggerRow r; bool ok = false;
      |               ^
/home/runner/work/ESP32-FlightStack/ESP32-FlightStack/RC_FlightController/src/Submodules/Logger/Logger.cpp:219:39: warning: 'r.LoggerRow::tof_age_ms' may be used uninitialized [-Wmaybe-uninitialized]
  219 |     s += ','; s += String(r.tof_age_ms); s += ','; s += String(r.tof_last_update_ms);
      |                                       ^
/home/runner/work/ESP32-FlightStack/ESP32-FlightStack/RC_FlightController/src/Submodules/Logger/Logger.cpp:157:15: note: 'r.LoggerRow::tof_age_ms' was declared here
  157 |     LoggerRow r; bool ok = false;
      |               ^
/home/runner/work/ESP32-FlightStack/ESP32-FlightStack/RC_FlightController/src/Submodules/Logger/Logger.cpp:219:84: warning: 'r.LoggerRow::tof_last_update_ms' may be used uninitialized [-Wmaybe-uninitialized]
  219 |     s += ','; s += String(r.tof_age_ms); s += ','; s += String(r.tof_last_update_ms);
      |                                                                                    ^
/home/runner/work/ESP32-FlightStack/ESP32-FlightStack/RC_FlightController/src/Submodules/Logger/Logger.cpp:157:15: note: 'r.LoggerRow::tof_last_update_ms' was declared here
  157 |     LoggerRow r; bool ok = false;
      |               ^
/home/runner/work/ESP32-FlightStack/ESP32-FlightStack/RC_FlightController/src/Submodules/Logger/Logger.cpp:220:38: warning: 'r.LoggerRow::tof_ready' may be used uninitialized [-Wmaybe-uninitialized]
  220 |     s += ','; s += String(r.tof_ready); s += ','; s += String(r.tof_valid);
      |                                      ^
/home/runner/work/ESP32-FlightStack/ESP32-FlightStack/RC_FlightController/src/Submodules/Logger/Logger.cpp:157:15: note: 'r.LoggerRow::tof_ready' was declared here
  157 |     LoggerRow r; bool ok = false;
      |               ^
/home/runner/work/ESP32-FlightStack/ESP32-FlightStack/RC_FlightController/src/Submodules/Logger/Logger.cpp:220:74: warning: 'r.LoggerRow::tof_valid' may be used uninitialized [-Wmaybe-uninitialized]
  220 |     s += ','; s += String(r.tof_ready); s += ','; s += String(r.tof_valid);
      |                                                                          ^
/home/runner/work/ESP32-FlightStack/ESP32-FlightStack/RC_FlightController/src/Submodules/Logger/Logger.cpp:157:15: note: 'r.LoggerRow::tof_valid' was declared here
  157 |     LoggerRow r; bool ok = false;
      |               ^
/home/runner/work/ESP32-FlightStack/ESP32-FlightStack/RC_FlightController/src/Submodules/Logger/Logger.cpp:221:17: warning: 'r.LoggerRow::ekf_pos_z_m' may be used uninitialized [-Wmaybe-uninitialized]
  221 |     _appendFloat(s,r.ekf_pos_z_m,3); _appendFloat(s,r.ekf_vel_z_mps,3);
      |     ~~~~~~~~~~~~^~~~~~~~~~~~~~~~~~~
/home/runner/work/ESP32-FlightStack/ESP32-FlightStack/RC_FlightController/src/Submodules/Logger/Logger.cpp:157:15: note: 'r.LoggerRow::ekf_pos_z_m' was declared here
  157 |     LoggerRow r; bool ok = false;
      |               ^
/home/runner/work/ESP32-FlightStack/ESP32-FlightStack/RC_FlightController/src/Submodules/Logger/Logger.cpp:221:50: warning: 'r.LoggerRow::ekf_vel_z_mps' may be used uninitialized [-Wmaybe-uninitialized]
  221 |     _appendFloat(s,r.ekf_pos_z_m,3); _appendFloat(s,r.ekf_vel_z_mps,3);
      |                                      ~~~~~~~~~~~~^~~~~~~~~~~~~~~~~~~~~
/home/runner/work/ESP32-FlightStack/ESP32-FlightStack/RC_FlightController/src/Submodules/Logger/Logger.cpp:157:15: note: 'r.LoggerRow::ekf_vel_z_mps' was declared here
  157 |     LoggerRow r; bool ok = false;
      |               ^
/home/runner/work/ESP32-FlightStack/ESP32-FlightStack/RC_FlightController/src/Submodules/Logger/Logger.cpp:222:43: warning: 'r.LoggerRow::tof_ekf_age_ms' may be used uninitialized [-Wmaybe-uninitialized]
  222 |     s += ','; s += String(r.tof_ekf_age_ms);
      |                                           ^
/home/runner/work/ESP32-FlightStack/ESP32-FlightStack/RC_FlightController/src/Submodules/Logger/Logger.cpp:157:15: note: 'r.LoggerRow::tof_ekf_age_ms' was declared here
  157 |     LoggerRow r; bool ok = false;
      |               ^
/home/runner/work/ESP32-FlightStack/ESP32-FlightStack/RC_FlightController/src/Submodules/Logger/Logger.cpp:223:54: warning: 'r.LoggerRow::tof_ekf_velocity_accepted' may be used uninitialized [-Wmaybe-uninitialized]
  223 |     s += ','; s += String(r.tof_ekf_velocity_accepted);
      |                                                      ^
/home/runner/work/ESP32-FlightStack/ESP32-FlightStack/RC_FlightController/src/Submodules/Logger/Logger.cpp:157:15: note: 'r.LoggerRow::tof_ekf_velocity_accepted' was declared here
  157 |     LoggerRow r; bool ok = false;
      |               ^
/home/runner/work/ESP32-FlightStack/ESP32-FlightStack/RC_FlightController/src/Submodules/Logger/Logger.cpp:224:52: warning: 'r.LoggerRow::altitude_hold_requested' may be used uninitialized [-Wmaybe-uninitialized]
  224 |     s += ','; s += String(r.altitude_hold_requested);
      |                                                    ^
/home/runner/work/ESP32-FlightStack/ESP32-FlightStack/RC_FlightController/src/Submodules/Logger/Logger.cpp:157:15: note: 'r.LoggerRow::altitude_hold_requested' was declared here
  157 |     LoggerRow r; bool ok = false;
      |               ^
/home/runner/work/ESP32-FlightStack/ESP32-FlightStack/RC_FlightController/src/Submodules/Logger/Logger.cpp:225:48: warning: 'r.LoggerRow::altitude_hold_ready' may be used uninitialized [-Wmaybe-uninitialized]
  225 |     s += ','; s += String(r.altitude_hold_ready);
      |                                                ^
/home/runner/work/ESP32-FlightStack/ESP32-FlightStack/RC_FlightController/src/Submodules/Logger/Logger.cpp:157:15: note: 'r.LoggerRow::altitude_hold_ready' was declared here
  157 |     LoggerRow r; bool ok = false;
      |               ^
/home/runner/work/ESP32-FlightStack/ESP32-FlightStack/RC_FlightController/src/Submodules/Logger/Logger.cpp:226:49: warning: 'r.LoggerRow::altitude_hold_active' may be used uninitialized [-Wmaybe-uninitialized]
  226 |     s += ','; s += String(r.altitude_hold_active);
      |                                                 ^
/home/runner/work/ESP32-FlightStack/ESP32-FlightStack/RC_FlightController/src/Submodules/Logger/Logger.cpp:157:15: note: 'r.LoggerRow::altitude_hold_active' was declared here
  157 |     LoggerRow r; bool ok = false;
      |               ^
/home/runner/work/ESP32-FlightStack/ESP32-FlightStack/RC_FlightController/src/Submodules/Logger/Logger.cpp:227:17: warning: 'r.LoggerRow::altitude_hold_setpoint_m' may be used uninitialized [-Wmaybe-uninitialized]
  227 |     _appendFloat(s,r.altitude_hold_setpoint_m,3);
      |     ~~~~~~~~~~~~^~~~~~~~~~~~~~~~~~~~~~~~~~~~~~~~
/home/runner/work/ESP32-FlightStack/ESP32-FlightStack/RC_FlightController/src/Submodules/Logger/Logger.cpp:157:15: note: 'r.LoggerRow::altitude_hold_setpoint_m' was declared here
  157 |     LoggerRow r; bool ok = false;
      |               ^
/home/runner/work/ESP32-FlightStack/ESP32-FlightStack/RC_FlightController/src/Submodules/Logger/Logger.cpp:228:17: warning: 'r.LoggerRow::altitude_hold_error_m' may be used uninitialized [-Wmaybe-uninitialized]
  228 |     _appendFloat(s,r.altitude_hold_error_m,3);
      |     ~~~~~~~~~~~~^~~~~~~~~~~~~~~~~~~~~~~~~~~~~
/home/runner/work/ESP32-FlightStack/ESP32-FlightStack/RC_FlightController/src/Submodules/Logger/Logger.cpp:157:15: note: 'r.LoggerRow::altitude_hold_error_m' was declared here
  157 |     LoggerRow r; bool ok = false;
      |               ^
/home/runner/work/ESP32-FlightStack/ESP32-FlightStack/RC_FlightController/src/Submodules/Logger/Logger.cpp:229:17: warning: 'r.LoggerRow::altitude_hold_throttle_trim' may be used uninitialized [-Wmaybe-uninitialized]
  229 |     _appendFloat(s,r.altitude_hold_throttle_trim,4);
      |     ~~~~~~~~~~~~^~~~~~~~~~~~~~~~~~~~~~~~~~~~~~~~~~~
/home/runner/work/ESP32-FlightStack/ESP32-FlightStack/RC_FlightController/src/Submodules/Logger/Logger.cpp:157:15: note: 'r.LoggerRow::altitude_hold_throttle_trim' was declared here
  157 |     LoggerRow r; bool ok = false;
      |               ^
/home/runner/work/ESP32-FlightStack/ESP32-FlightStack/RC_FlightController/src/Submodules/Logger/Logger.cpp:230:38: warning: 'r.LoggerRow::gps_valid' may be used uninitialized [-Wmaybe-uninitialized]
  230 |     s += ','; s += String(r.gps_valid); s += ','; s += String(r.gps_sats); _appendFloat(s,r.gps_hdop,2);
      |                                      ^
/home/runner/work/ESP32-FlightStack/ESP32-FlightStack/RC_FlightController/src/Submodules/Logger/Logger.cpp:157:15: note: 'r.LoggerRow::gps_valid' was declared here
  157 |     LoggerRow r; bool ok = false;
      |               ^
/home/runner/work/ESP32-FlightStack/ESP32-FlightStack/RC_FlightController/src/Submodules/Logger/Logger.cpp:230:73: warning: 'r.LoggerRow::gps_sats' may be used uninitialized [-Wmaybe-uninitialized]
  230 |     s += ','; s += String(r.gps_valid); s += ','; s += String(r.gps_sats); _appendFloat(s,r.gps_hdop,2);
      |                                                                         ^
/home/runner/work/ESP32-FlightStack/ESP32-FlightStack/RC_FlightController/src/Submodules/Logger/Logger.cpp:157:15: note: 'r.LoggerRow::gps_sats' was declared here
  157 |     LoggerRow r; bool ok = false;
      |               ^
/home/runner/work/ESP32-FlightStack/ESP32-FlightStack/RC_FlightController/src/Submodules/Logger/Logger.cpp:230:88: warning: 'r.LoggerRow::gps_hdop' may be used uninitialized [-Wmaybe-uninitialized]
  230 |     s += ','; s += String(r.gps_valid); s += ','; s += String(r.gps_sats); _appendFloat(s,r.gps_hdop,2);
      |                                                                            ~~~~~~~~~~~~^~~~~~~~~~~~~~~~
/home/runner/work/ESP32-FlightStack/ESP32-FlightStack/RC_FlightController/src/Submodules/Logger/Logger.cpp:157:15: note: 'r.LoggerRow::gps_hdop' was declared here
  157 |     LoggerRow r; bool ok = false;
      |               ^
In file included from /home/runner/work/ESP32-FlightStack/ESP32-FlightStack/RC_FlightController/src/Submodules/WiFiTelemetry/TelemetryWiFi.cpp:14:
/home/runner/work/ESP32-FlightStack/ESP32-FlightStack/RC_FlightController/src/Submodules/WiFiTelemetry/TelemetryWiFi.h: In constructor 'TelemetryWiFi::TelemetryWiFi(uint16_t)':
/home/runner/work/ESP32-FlightStack/ESP32-FlightStack/RC_FlightController/src/Submodules/WiFiTelemetry/TelemetryWiFi.h:429:16: warning: 'TelemetryWiFi::_flightLogReset' will be initialized after [-Wreorder]
  429 |     void     (*_flightLogReset)();
      |                ^~~~~~~~~~~~~~~
/home/runner/work/ESP32-FlightStack/ESP32-FlightStack/RC_FlightController/src/Submodules/WiFiTelemetry/TelemetryWiFi.h:393:16: warning:   'uint32_t TelemetryWiFi::_requestCount' [-Wreorder]
  393 |     uint32_t   _requestCount;
      |                ^~~~~~~~~~~~~
/home/runner/work/ESP32-FlightStack/ESP32-FlightStack/RC_FlightController/src/Submodules/WiFiTelemetry/TelemetryWiFi.cpp:51:1: warning:   when initialized here [-Wreorder]
   51 | TelemetryWiFi::TelemetryWiFi(uint16_t port)
      | ^~~~~~~~~~~~~
Sketch uses 1158147 bytes (58%) of program storage space. Maximum is 1966080 bytes.
Global variables use 77604 bytes (23%) of dynamic memory, leaving 250076 bytes for local variables. Maximum is 327680 bytes.
