durveshpathak1989/ESP32-FlightStack/PCB/ESP32_FlightController/ESP32_FlightController.kicad_pcb

## KiCad design PCB/ESP32_FlightController/ESP32_FlightController.kicad_pcb (2026-07-22)

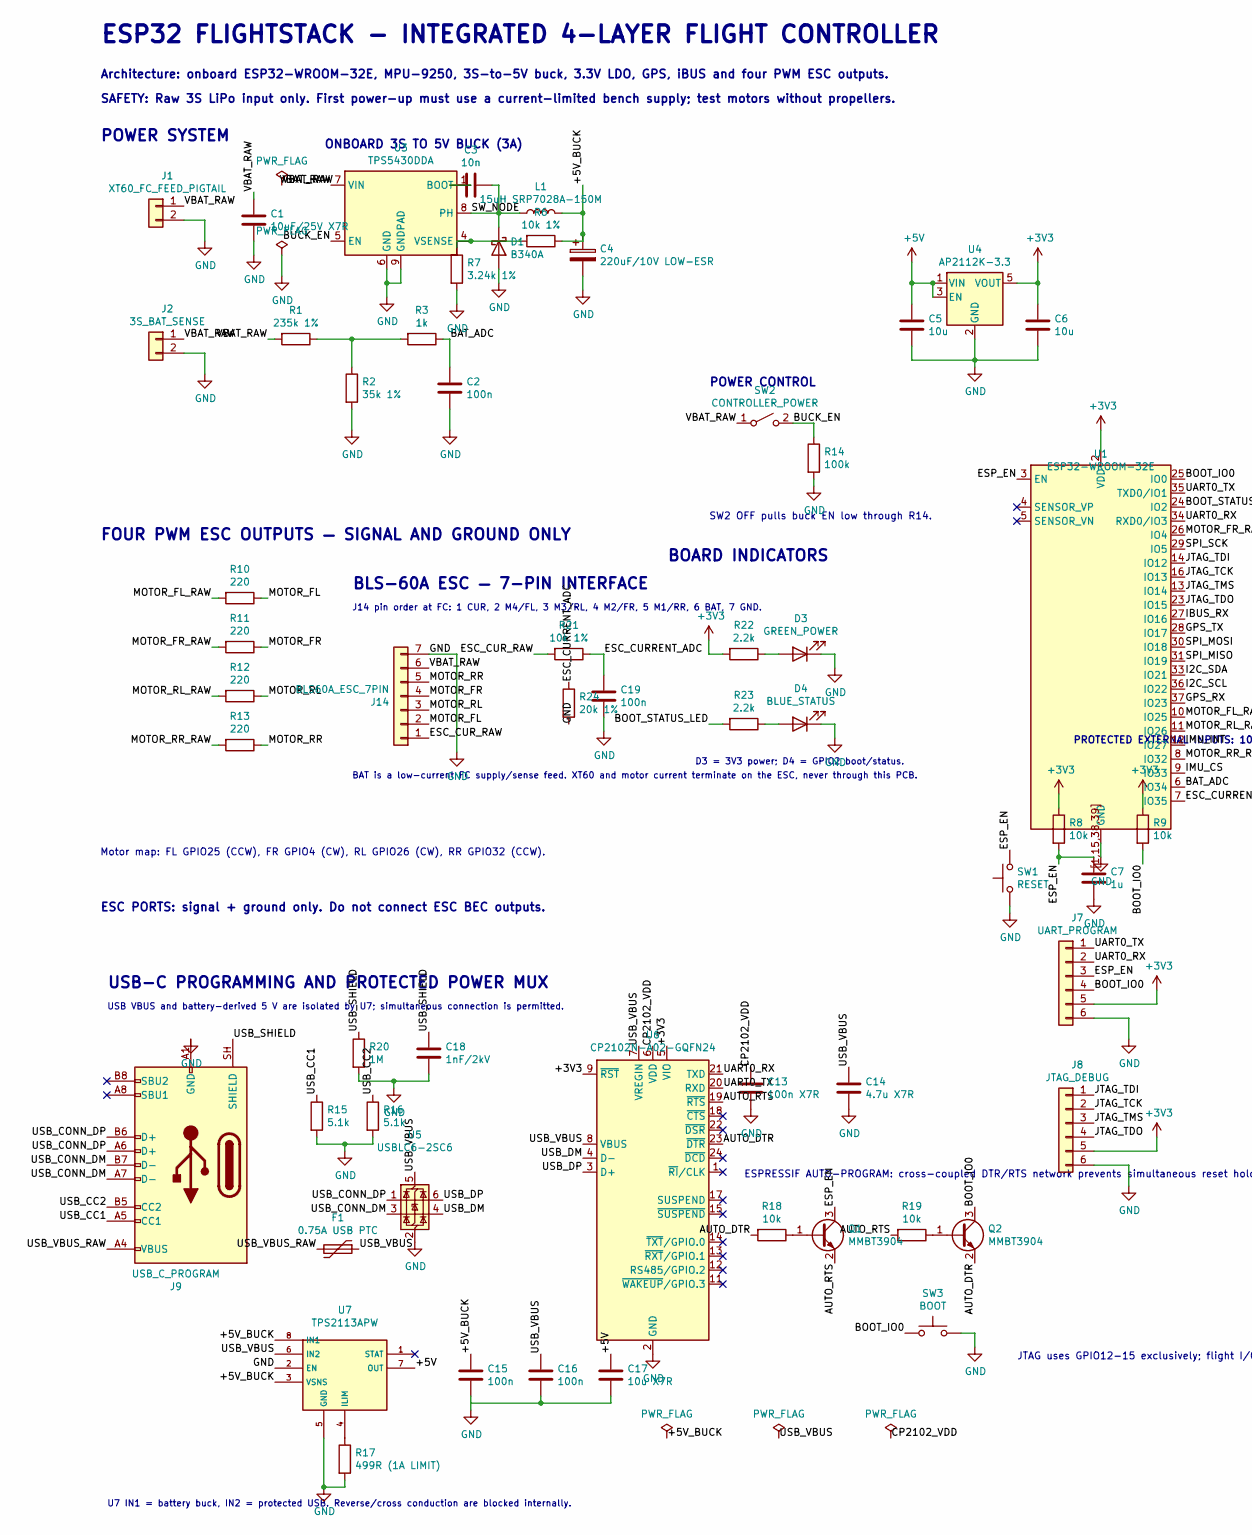
[picture p13: schematic ESP32_FlightController.kicad_sch, ESP32 FlightStack Integrated Flight Controller, part in row 1, column 1]

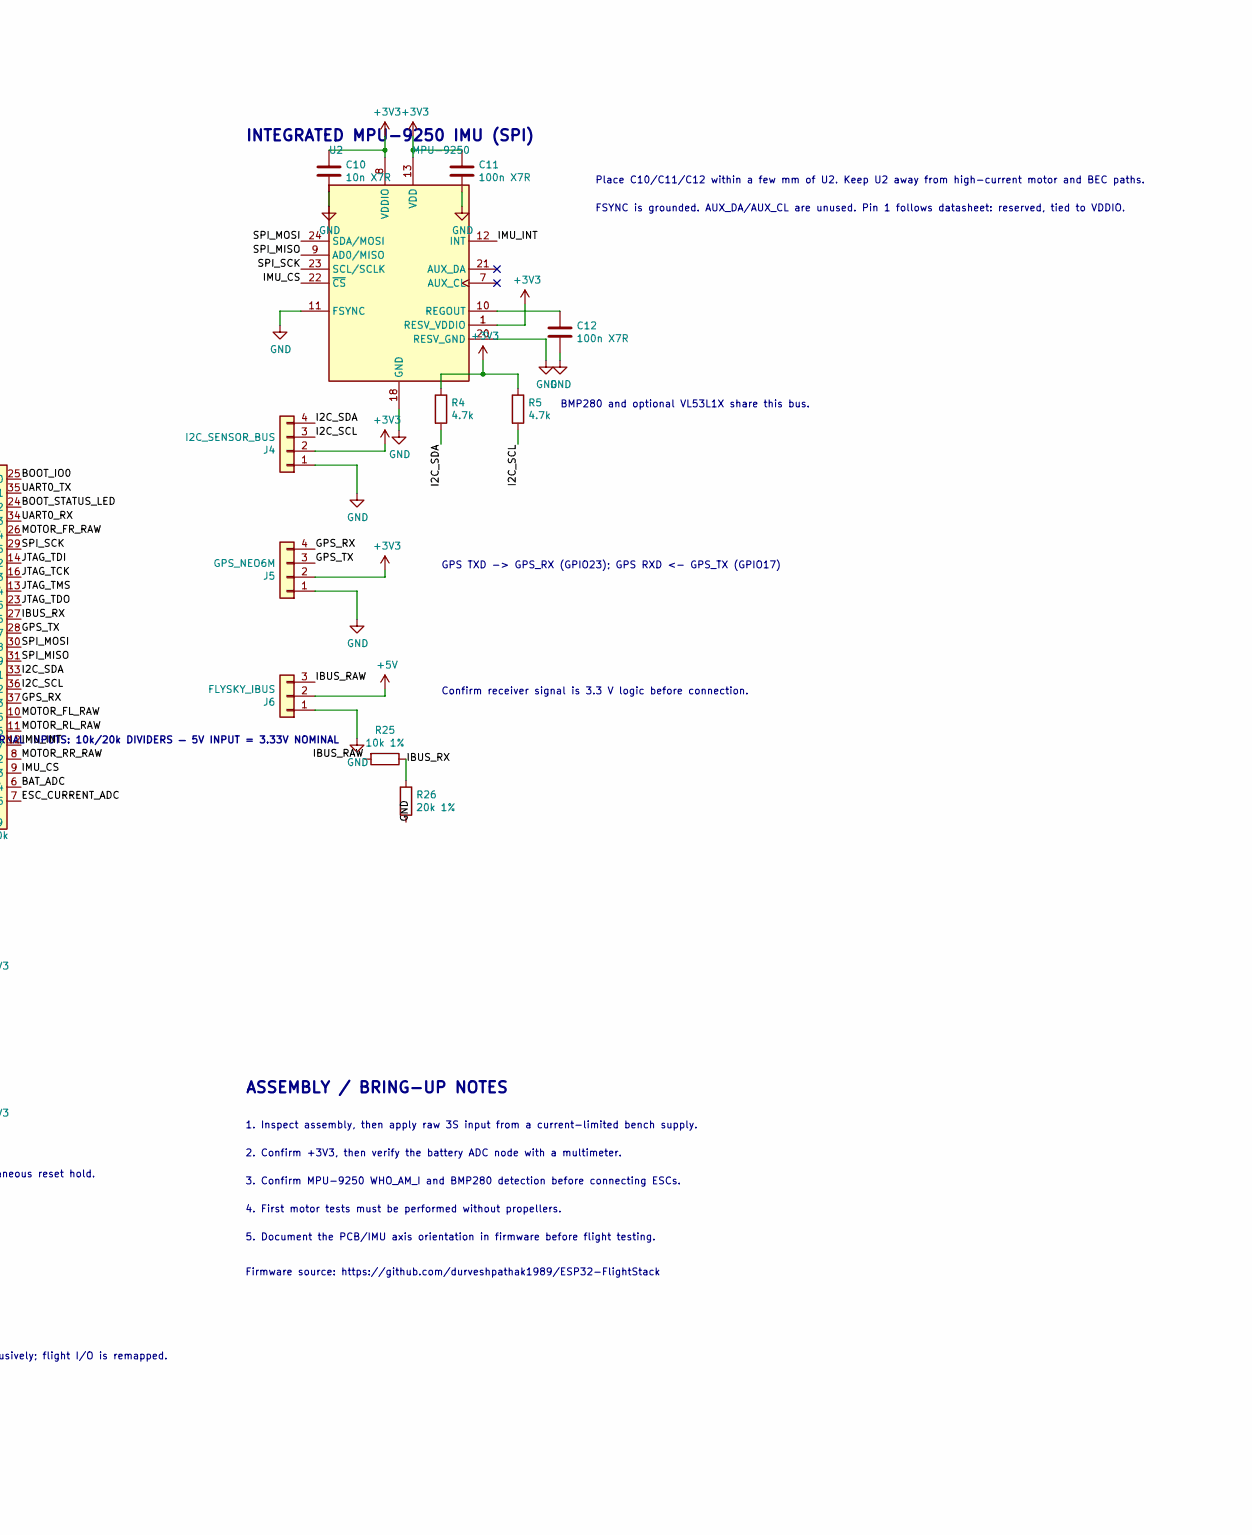
[picture p14: schematic ESP32_FlightController.kicad_sch, ESP32 FlightStack Integrated Flight Controller, part in row 1, column 2]

Parts:
C1: 10uF/25V X7R; C_1210_3225Metric
C2: 100n; C_0805_2012Metric
C3: 10n; C_0603_1608Metric
C4: 220uF/10V LOW-ESR; CP_Elec_6.3x5.8
C5, C6: 10u; C_0805_2012Metric
C7: 1u; C_0603_1608Metric
C10: 10n X7R; C_0402_1005Metric
C11, C12, C13: 100n X7R; C_0402_1005Metric
C14: 4.7u X7R; C_0603_1608Metric
C15, C16, C19: 100n; C_0603_1608Metric
C17: 10u X7R; C_0805_2012Metric
C18: 1nF/2kV; C_1206_3216Metric
D1: B340A; D_SMA
D3: GREEN_POWER; LED_0603_1608Metric
D4: BLUE_STATUS; LED_0603_1608Metric
F1: 0.75A USB PTC; Fuse_1206_3216Metric
J1: XT60_FC_FEED_PIGTAIL; SolderWire-1.5sqmm_1x02_P6mm_D1.7mm_OD3mm
J2: 3S_BAT_SENSE; JST_GH_BM02B-GHS-TBT_1x02-1MP_P1.25mm_Vertical
J4: I2C_SENSOR_BUS; JST_SH_BM04B-SRSS-TB_1x04-1MP_P1.00mm_Vertical
J5: GPS_NEO6M; JST_GH_BM04B-GHS-TBT_1x04-1MP_P1.25mm_Vertical
J6: FLYSKY_IBUS; JST_GH_BM03B-GHS-TBT_1x03-1MP_P1.25mm_Vertical
J7: UART_PROGRAM; PinHeader_1x06_P1.27mm_Vertical
J8: JTAG_DEBUG; PinHeader_1x06_P1.27mm_Vertical
J9: USB_C_PROGRAM; USB_C_Receptacle_GCT_USB4105-xx-A_16P_TopMnt_Horizontal
J14: BLS60A_ESC_7PIN; JST_SH_BM07B-SRSS-TB_1x07-1MP_P1.00mm_Vertical
L1: 15uH SRP7028A-150M; L_Bourns_SRP7028A_7.3x6.6mm
Q1, Q2: MMBT3904; SOT-23
R1: 235k 1%; R_0805_2012Metric
R2: 35k 1%; R_0805_2012Metric
R3: 1k; R_0805_2012Metric
R4, R5: 4.7k; R_0805_2012Metric
R6, R21, R25: 10k 1%; R_0603_1608Metric
R7: 3.24k 1%; R_0603_1608Metric
R8, R9, R18, R19: 10k; R_0603_1608Metric
R10, R11, R12, R13: 220; R_0805_2012Metric
R14: 100k; R_0603_1608Metric
R15, R16: 5.1k; R_0603_1608Metric
R17: 499R (1A LIMIT); R_0603_1608Metric
R20: 1M; R_0603_1608Metric
R22, R23: 2.2k; R_0603_1608Metric
R24, R26: 20k 1%; R_0603_1608Metric
SW1: RESET; SW_SPST_CK_KXT3
SW2: CONTROLLER_POWER; SW_SPST_CK_RS282G05A3
SW3: BOOT; SW_SPST_CK_KXT3
U1: ESP32-WROOM-32E; ESP32-WROOM-32_Custom
U2: MPU-9250; InvenSense_QFN-24_3x3mm_P0.4mm
U3: TPS5430DDA; TI_SO-PowerPAD-8_NoUnderDrills
U4: AP2112K-3.3; SOT-23-5
U5: USBLC6-2SC6; SOT-23-6
U6: CP2102N-A02-GQFN24; QFN-24-1EP_4x4mm_P0.5mm_EP2.7x2.7mm
U7: TPS2113APW; TSSOP-8_3x3mm_P0.65mm

Connections:
+3V3: C6.1, C10.1, C11.1, J4.2, J5.2, J7.5, J8.5, R4.1, R5.1, R8.1, R9.1, R22.2, U1.2 (VDD), U2.1 (RESV_VDDIO), U2.8 (VDDIO), U2.13 (VDD), U4.5 (VOUT), U6.5 (VIO), U6.9 (~RST)
+5V: C5.1, C17.1, J6.2, U4.1 (VIN), U4.3 (EN), U7.7 (OUT)
/+5V_BUCK: C4.1, C15.1, L1.2, R6.1, U7.3 (VSNS), U7.8 (IN1)
/AUTO_DTR: Q2.2 (E), R18.2, U6.23 (~DTR)
/AUTO_RTS: Q1.2 (E), R19.2, U6.19 (~RTS)
/BAT_ADC: C2.1, R3.1, U1.6 (IO34)
/BOOT_IO0: J7.4, Q2.3 (C), R9.2, SW3.1, U1.25 (IO0)
/BOOT_STATUS_LED: R23.2, U1.24 (IO2)
/BUCK_EN: R14.1, SW2.2 (B), U3.5 (EN)
/CP2102_VDD: C13.1, U6.6 (VDD)
/ESC_CURRENT_ADC: C19.1, R21.1, R24.1, U1.7 (IO35)
/ESC_CUR_RAW: J14.1, R21.2
/ESP_EN: C7.1, J7.3, Q1.3 (C), R8.2, SW1.2, U1.3 (EN)
/GPS_RX: J5.4, U1.37 (IO23)
/GPS_TX: J5.3, U1.28 (IO17)
/I2C_SCL: J4.3, R5.2, U1.36 (IO22)
/I2C_SDA: J4.4, R4.2, U1.33 (IO21)
/IBUS_RAW: J6.3, R25.2
/IBUS_RX: R25.1, R26.1, U1.27 (IO16)
/IMU_CS: U1.9 (IO33), U2.22 (~CS)
/IMU_INT: U1.12 (IO27), U2.12 (INT)
/JTAG_TCK: J8.2, U1.16 (IO13)
/JTAG_TDI: J8.1, U1.14 (IO12)
/JTAG_TDO: J8.4, U1.23 (IO15)
/JTAG_TMS: J8.3, U1.13 (IO14)
/MOTOR_FL: J14.2, R10.1
/MOTOR_FL_RAW: R10.2, U1.10 (IO25)
/MOTOR_FR: J14.4, R11.1
/MOTOR_FR_RAW: R11.2, U1.26 (IO4)
/MOTOR_RL: J14.3, R12.1
/MOTOR_RL_RAW: R12.2, U1.11 (IO26)
/MOTOR_RR: J14.5, R13.1
/MOTOR_RR_RAW: R13.2, U1.8 (IO32)
/SPI_MISO: U1.31 (IO19), U2.9 (AD0/MISO)
/SPI_MOSI: U1.30 (IO18), U2.24 (SDA/MOSI)
/SPI_SCK: U1.29 (IO5), U2.23 (SCL/SCLK)
/SW_NODE: C3.1, D1.1 (K), L1.1, U3.8 (PH)
/UART0_RX: J7.2, U1.34 (RXD0/IO3), U6.21 (TXD)
/UART0_TX: J7.1, U1.35 (TXD0/IO1), U6.20 (RXD)
/USB_CC1: J9.A5 (CC1), R15.1
/USB_CC2: J9.B5 (CC2), R16.1
/USB_CONN_DM: J9.A7 (D-), J9.B7 (D-), U5.3 (I/O2)
/USB_CONN_DP: J9.A6 (D+), J9.B6 (D+), U5.1 (I/O1)
/USB_DM: U5.4 (I/O2), U6.4 (D-)
/USB_DP: U5.6 (I/O1), U6.3 (D+)
/USB_SHIELD: C18.1, J9.SH (SHIELD), R20.1
/USB_VBUS: C14.1, C16.1, F1.1, U5.5 (VBUS), U6.7 (VREGIN), U6.8 (VBUS), U7.6 (IN2)
/USB_VBUS_RAW: F1.2, J9.A4 (VBUS), J9.A9 (VBUS), J9.B4 (VBUS), J9.B9 (VBUS)
/VBAT_RAW: C1.1, J1.1, J2.1, J14.6, R1.2, SW2.1 (A), U3.7 (VIN)
GND: C1.2, C2.2, C4.2, C5.2, C6.2, C7.2, C10.2, C11.2, C12.2, C13.2, C14.2, C15.2, C16.2, C17.2, C18.2, C19.2, D1.2 (A), D3.1 (K), D4.1 (K), J1.2, J2.2, J4.1, J5.1, J6.1, J7.6, J8.6, J9.A1 (GND), J9.A12 (GND), J9.B1 (GND), J9.B12 (GND), J14.7, R2.2, R7.2, R14.2, R15.2, R16.2, R17.2, R20.2, R24.2, R26.2, SW1.1, SW3.2, U1.1 (GND), U1.15 (GND), U1.38 (GND), U1.39 (GND), U1.[1,15,38,39] (GND), U2.11 (FSYNC), U2.18 (GND), U2.20 (RESV_GND), U3.6 (GND), U3.9 (GNDPAD), U4.2 (GND), U5.2 (GND), U6.2 (GND), U6.25 (GND), U7.2 (EN), U7.5 (GND)
unnamed: D3.2 (A), R22.1
unnamed: D4.2 (A), R23.1
unnamed: Q1.1 (B), R18.1
unnamed: Q2.1 (B), R19.1
unnamed: R1.1, R2.1, R3.2
unnamed: C12.1, U2.10 (REGOUT)
unnamed: C3.2, U3.1 (BOOT)
unnamed: R6.2, R7.1, U3.4 (VSENSE)
unnamed: R17.1, U7.4 (ILIM)

Notes on the sheet:
BLS-60A ESC — 7-PIN INTERFACE
INTEGRATED MPU-9250 IMU (SPI)
1. Inspect assembly, then apply raw 3S input from a current-limited bench supply.
ESC PORTS: signal + ground only. Do not connect ESC BEC outputs.
GPS TXD -> GPS_RX (GPIO23); GPS RXD <- GPS_TX (GPIO17)
POWER SYSTEM
FSYNC is grounded. AUX_DA/AUX_CL are unused. Pin 1 follows datasheet: reserved, tied to VDDIO.
PROTECTED EXTERNAL INPUTS: 10k/20k DIVIDERS — 5V INPUT = 3.33V NOMINAL
ONBOARD 3S TO 5V BUCK (3A)
Motor map: FL GPIO25 (CCW), FR GPIO4 (CW), RL GPIO26 (CW), RR GPIO32 (CCW).
USB VBUS and battery-derived 5 V are isolated by U7; simultaneous connection is permitted.
BOARD INDICATORS
3. Confirm MPU-9250 WHO_AM_I and BMP280 detection before connecting ESCs.
JTAG uses GPIO12-15 exclusively; flight I/O is remapped.
Place C10/C11/C12 within a few mm of U2. Keep U2 away from high-current motor and BEC paths.
ASSEMBLY / BRING-UP NOTES
Confirm receiver signal is 3.3 V logic before connection.
ESPRESSIF AUTO-PROGRAM: cross-coupled DTR/RTS network prevents simultaneous reset hold.
USB-C PROGRAMMING AND PROTECTED POWER MUX
ESP32 FLIGHTSTACK - INTEGRATED 4-LAYER FLIGHT CONTROLLER
SAFETY: Raw 3S LiPo input only. First power-up must use a current-limited bench supply; test motors without propellers.
SW2 OFF pulls buck EN low through R14.
2. Confirm +3V3, then verify the battery ADC node with a multimeter.
D3 = 3V3 power; D4 = GPIO2 boot/status.
Firmware source: https://github.com/durveshpathak1989/ESP32-FlightStack
4. First motor tests must be performed without propellers.
J14 pin order at FC: 1 CUR, 2 M4/FL, 3 M3/RL, 4 M2/FR, 5 M1/RR, 6 BAT, 7 GND.
POWER CONTROL
BAT is a low-current FC supply/sense feed. XT60 and motor current terminate on the ESC, never through this PCB.
BMP280 and optional VL53L1X share this bus.
FOUR PWM ESC OUTPUTS — SIGNAL AND GROUND ONLY
U7 IN1 = battery buck, IN2 = protected USB. Reverse/cross conduction are blocked internally.
Architecture: onboard ESP32-WROOM-32E, MPU-9250, 3S-to-5V buck, 3.3V LDO, GPS, iBUS and four PWM ESC outputs.
5. Document the PCB/IMU axis orientation in firmware before flight testing.

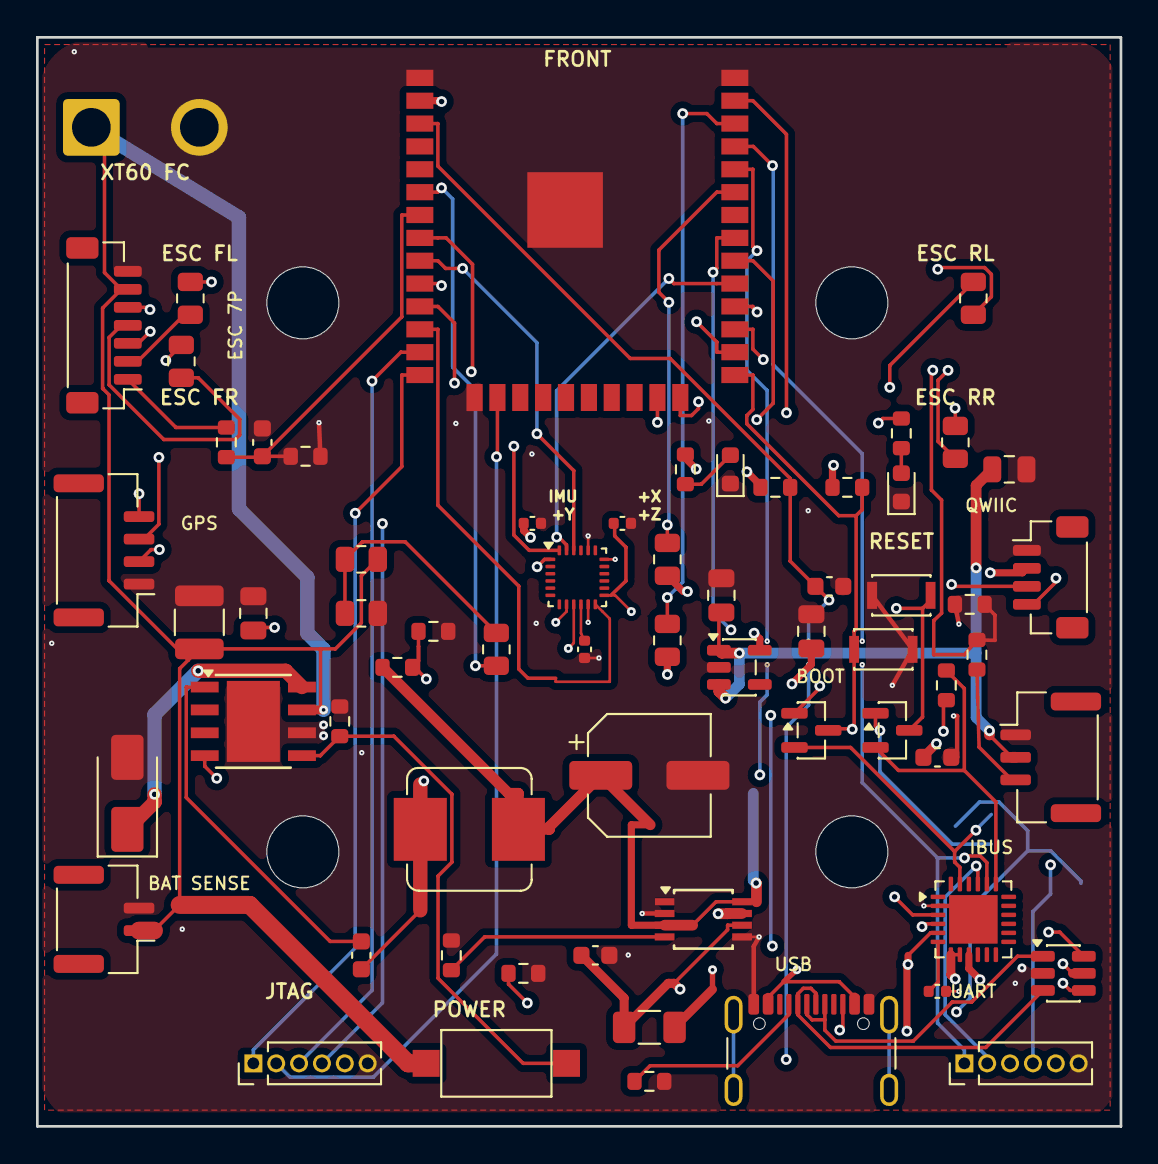
[picture p15: board ESP32_FlightController.kicad_pcb from above]

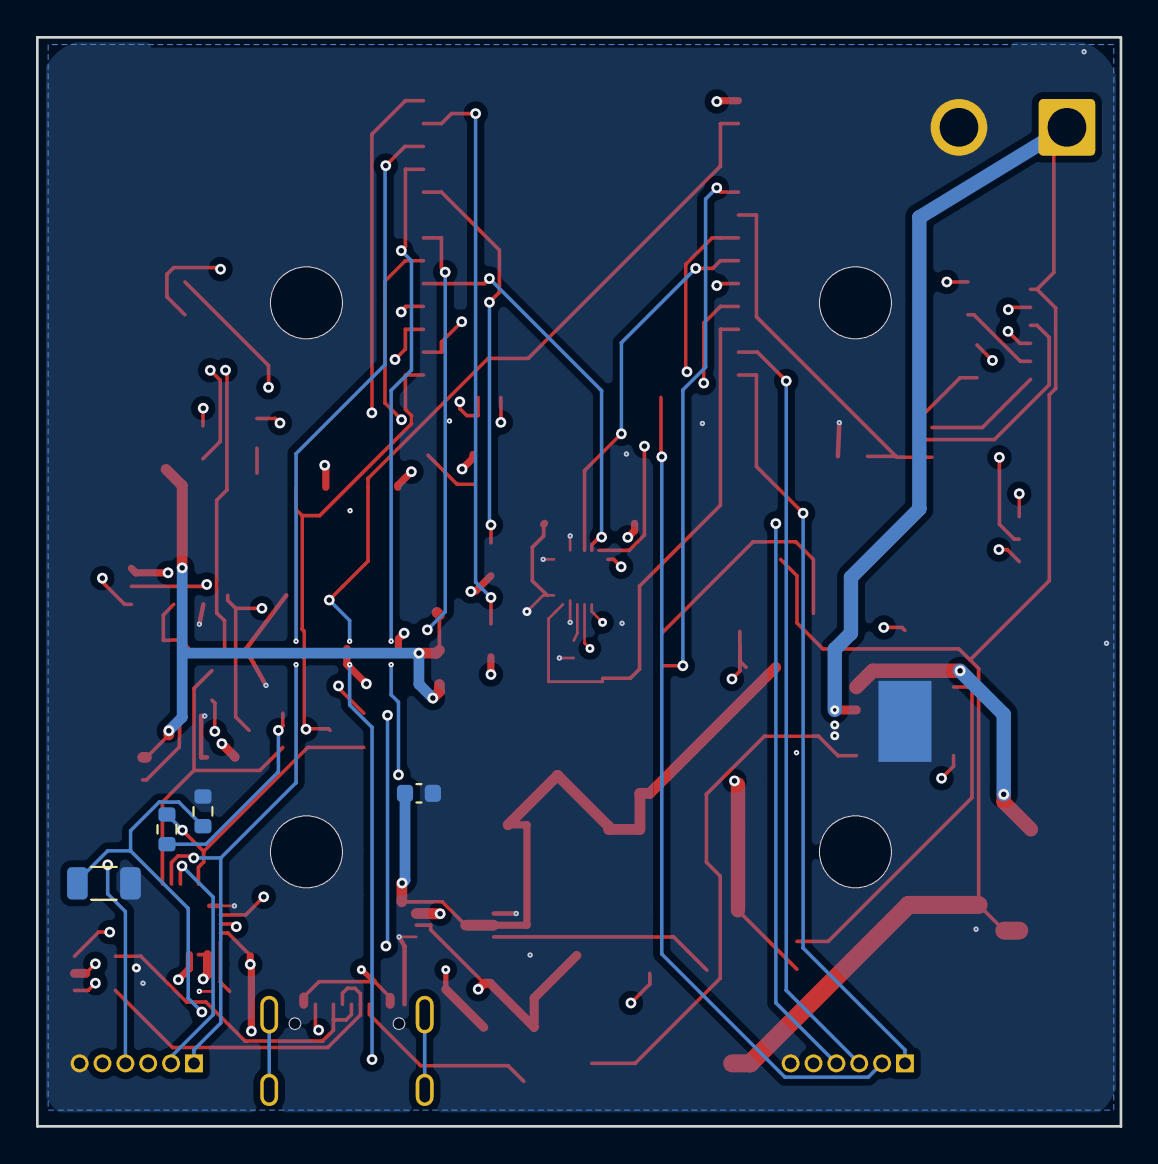
[picture p16: board ESP32_FlightController.kicad_pcb from below]

Board: 4 copper layers, 60.2 x 60.5 mm, 73 parts (4 on the bottom side), 59 nets.

Other parts of the board:
H1, H2, H3, H4: M4 / 30.5mm STACK; MountingHole_4mm
