durveshpathak1989/ESP32-FlightStack/RC_FlightController/RC_FlightController.ino

/*
 * Name: RC_FlightController.ino
 * Use: Main Arduino sketch that starts sensors, tasks, telemetry, calibration, PID control, and motor output.
 * Version: 6.1.0
 * Created by: Durvesh Pathak dp676@cornell.edu
 */

/**
 * ╔══════════════════════════════════════════════════════════════════╗
 * ║  RC_FlightController.ino  v6.1.0                                ║
 * ║  FlySky FS-iA6B iBUS  +  MPU-9250/6500  +  BMP280  +  GPS       ║
 * ║  Fully autonomous — no keyboard required                         ║
 * ╠══════════════════════════════════════════════════════════════════╣
 * ║  v2.3.2 changes (over the pasted v2.3.1 working file):           ║
 * ║   • PID telemetry FIXED: real rO/pO/yO now published in          ║
 * ║     FlightState and printed (was feeding 4 motor values into     ║
 * ║     3 out-slots, garbling yawSP/hold). [PID] line is now a       ║
 * ║     sibling of the 1 Hz block at ~4 Hz, toggled by Serial 'p'.   ║
 * ║   • No flight-behavior changes: gains, yaw-stick negation,       ║
 * ║     heading hold, LPF reset, output limits all preserved.        ║
 * ╠══════════════════════════════════════════════════════════════════╣
 * ║  WIRING                                                           ║
 * ║   FS-iA6B iBUS port → GPIO 16 (UART2 RX)                        ║
 * ║   MPU-9250 SCLK→5  MOSI→18  MISO→19  NCS→33  VCC→3.3V          ║
 * ║   BMP280 SDA→21  SCL→22  VCC→3.3V  GND→GND  CSB→3.3V           ║
 * ║   GPS TXD→13  VCC→3.3V  GND→GND (UART1)                         ║
 * ║   Motors: FL→25  FR→15  RL→14  RR→32                            ║
 * ╠══════════════════════════════════════════════════════════════════╣
 * ║  RC SWITCH ASSIGNMENTS                                            ║
 * ║   CH7  SWA  → ARM / DISARM                                       ║
 * ║   CH8  SWB  → ANGLE / ACRO                                       ║
 * ║   CH9  SWC  → Accel confirm during calibration                   ║
 * ║   CH10 SWD  → CAL trigger disarmed / ToF altitude hold armed     ║
 * ╠══════════════════════════════════════════════════════════════════╣
 * ║  SERIAL COMMANDS                                                  ║
 * ║   p  → toggle ~4 Hz [PID] tuning trace on/off (off at boot)     ║
 * ╠══════════════════════════════════════════════════════════════════╣
 * ║  HTTP ENDPOINTS                                                   ║
 * ║   GET  /telemetry     — full state JSON                          ║
 * ║   POST /tune          — apply PID / Mahony gains (disarmed)      ║
 * ║   GET/POST /update    — Web OTA update (disarmed/motors off)     ║
 * ║   GET  /log?since=N   — calibration log lines                    ║
 * ║   GET  /timing        — IMU jitter stats JSON (Test 7.1)         ║
 * ║   POST /timing/reset  — reset jitter stats (between conditions)  ║
 * ║   GET  /timing/csv    — raw period_us ring buffer CSV            ║
 * ╚══════════════════════════════════════════════════════════════════╝
 */

#include <SPI.h>
#include <Preferences.h>
#include <stdarg.h>
#include "src/Services/Diagnostics/DebugConfig/DebugConfig.h"
#include "src/EcuAbstraction/Actuators/MotorControl/MotorControl.h"
#include "src/EcuAbstraction/Sensors/IMU/MPU9250.h"
#include "src/EcuAbstraction/Receiver/iFly/FlySkyiBUS.h"
#include "src/Services/Com/WiFiTelemetry/TelemetryWiFi.h"
#include "src/EcuAbstraction/Power/BatteryMonitor/BatteryMonitor.h"
#include "src/EcuAbstraction/Sensors/BMP280/BMP280Sensor.h"
#include "src/App/Estimation/EKF/AttitudeEKF.h"
#include "src/EcuAbstraction/Sensors/ToF/FlightToF_VL53L4CX.h"
#include "src/App/Filters/NotchFilter/NotchFilter.h"
#include "src/Services/SignalProcessing/FFT/SpectrumAnalyzer.h"
#include "src/App/Estimation/Madgwick/MadgwickAHRS.h"
#include "src/App/Estimation/MahonyAHRS/MahonyAHRS.h"
#include "src/Services/Diagnostics/ESP32Core/CPUUtilization.h"
#include "src/EcuAbstraction/Sensors/GPS/GPSSensor.h"
#include "src/Services/Diagnostics/Logger/Logger.h"
#include "FirmwareBuildInfo.h"
#include "freertos/FreeRTOS.h"
#include "freertos/task.h"
#include "freertos/semphr.h"
#include "esp_timer.h"
#include "src/Services/Calibration/CalManager/CalibrationManager.h"
#include "src/Cfg/FlightConfig.h"
#include "src/App/Control/PidController.h"

static Logger flightLogger(FLIGHT_LOGGER_CAPACITY);

// ─────────────────────────────────────────────────────────────
//  IMU loop timing instrumentation — Test 7.1
// ─────────────────────────────────────────────────────────────
struct TimingStats {
    uint32_t count;
    double   wMean;
    double   wM2;
    uint32_t jitterMax;
    uint32_t jitterViolations;
    double   jMean;
    double   jM2;
    uint16_t buf[TIMING_BUF_SIZE];
    uint16_t bufHead;
    bool     bufFull;
};

// Loop Jitter timing stats

struct ExecTimingStats {
    uint32_t lastControlUs;
    uint32_t lastFullUs;
    uint32_t maxControlUs;
    uint32_t maxFullUs;
    uint32_t controlOverruns;
    uint32_t fullOverruns;

    // Phase timing to identify the blocker when ctrl time is too high.
    uint32_t lastImuUs;
    uint32_t lastRcUs;
    uint32_t lastAhrsUs;
    uint32_t lastMotorUs;
    uint32_t lastStateUs;
    uint32_t lastLogUs;
    uint32_t missedTimerReleases;
};

static volatile ExecTimingStats g_execTiming = {0,0,0,0,0,0,0,0,0,0,0,0,0};
static volatile uint32_t g_lastWifiServiceUs = 0;

static void updateExecTimingAndPrint(uint32_t controlUs, uint32_t fullUs,
                                     uint32_t periodUs, uint32_t targetUs)
{
    g_execTiming.lastControlUs = controlUs;
    g_execTiming.lastFullUs    = fullUs;

    if (controlUs > g_execTiming.maxControlUs) {
        g_execTiming.maxControlUs = controlUs;
    }

    if (fullUs > g_execTiming.maxFullUs) {
        g_execTiming.maxFullUs = fullUs;
    }

    if (controlUs > targetUs) {
        g_execTiming.controlOverruns++;
    }

    if (fullUs > targetUs) {
        g_execTiming.fullOverruns++;
    }

    if (!LOG_CONTROL_TIMING) return;

    // Print only once per second so Serial does not dominate the control loop.
    static uint32_t lastPrintMs = 0;
    uint32_t nowMs = millis();

    if (nowMs - lastPrintMs >= 1000) {
        lastPrintMs = nowMs;

        int32_t jitterSigned  = (int32_t)periodUs - (int32_t)targetUs;
        int32_t headroomFull  = (int32_t)targetUs - (int32_t)fullUs;

        DBG_PRINTF("[TIME] period=%luus jitter=%+ldus ctrl=%luus full=%luus "
                      "headroom=%+ldus maxCtrl=%luus maxFull=%luus "
                      "overCtrl=%lu overFull=%lu missed=%lu "
                      "phase imu=%luus rc=%luus ahrs=%luus motor=%luus state=%luus log=%luus wifi=%luus\n",
                      (unsigned long)periodUs,
                      (long)jitterSigned,
                      (unsigned long)controlUs,
                      (unsigned long)fullUs,
                      (long)headroomFull,
                      (unsigned long)g_execTiming.maxControlUs,
                      (unsigned long)g_execTiming.maxFullUs,
                      (unsigned long)g_execTiming.controlOverruns,
                      (unsigned long)g_execTiming.fullOverruns,
                      (unsigned long)g_execTiming.missedTimerReleases,
                      (unsigned long)g_execTiming.lastImuUs,
                      (unsigned long)g_execTiming.lastRcUs,
                      (unsigned long)g_execTiming.lastAhrsUs,
                      (unsigned long)g_execTiming.lastMotorUs,
                      (unsigned long)g_execTiming.lastStateUs,
                      (unsigned long)g_execTiming.lastLogUs,
                      (unsigned long)g_lastWifiServiceUs);
    }
}

static TimingStats       g_timing;
static SemaphoreHandle_t g_timingMutex;

static void resetTimingStats()
{
    if (xSemaphoreTake(g_timingMutex, pdMS_TO_TICKS(20)) == pdTRUE) {
        memset(&g_timing, 0, sizeof(g_timing));
        xSemaphoreGive(g_timingMutex);
    }
}

// ─────────────────────────────────────────────────────────────
//  IMU + attitude estimator objects
// ─────────────────────────────────────────────────────────────
MPU9250 imu(PIN_MPU_CS);
CalibrationManager calManager;
MahonyAHRS mahony;
AttitudeEstimate mahonyAtt;
AttitudeEKF attitudeEKF;
MadgwickAHRS madgwickAHRS;
NotchFilter notchAx, notchAy, notchAz;
NotchFilter notchGx, notchGy, notchGz;
static FlightToF_VL53L4CX tofSensor(Wire);
static BatteryMonitor batteryMonitor;
static float    g_dynamicNotchHz = TUNE_NOTCH_FREQ_HZ;
static bool     g_dynamicNotchTracking = false;
static uint32_t g_lastDynamicNotchUpdateMs = 0;

SpectrumAnalyzer spectrumAnalyzer(NOTCH_SAMPLE_HZ);

#define FLIGHT_LOG_SIZE 100   // expanded debug row: 300 samples @ 100 Hz = 3 s



// ─────────────────────────────────────────────────────────────
//  Shared flight state
// ─────────────────────────────────────────────────────────────
struct FlightState {
    // Raw estimator attitude from EKF/Mahony/Madgwick. Keep untouched for telemetry/debug.
    float roll_deg, pitch_deg, yaw_deg;
    float q0, q1, q2, q3;
    bool imuValid;
    bool magValid;
    uint8_t ahrsFilterMode;

    // Post-AHRS control attitude. PID uses these values after level-zero offset.
    float roll_ctrl_deg, pitch_ctrl_deg, yaw_ctrl_deg;

    // Captured software level-zero offsets subtracted from raw AHRS.
    float roll_offset_deg, pitch_offset_deg, yaw_offset_deg;
    float ax_g, ay_g, az_g;
    float gx_dps, gy_dps, gz_dps;
    float mx_uT, my_uT, mz_uT;
    float imuTemp_c;
    float bmpTemp_c, bmpPressure_hpa, bmpAltitude_m;
    bool  bmpValid;
    float tofDistance_m;
    uint16_t tofDistance_mm;
    uint8_t tofRangeStatus;
    uint8_t tofObjectCount;
    uint8_t tofStreamCount;
    float tofSignalMcps;
    float tofAmbientMcps;
    uint32_t tofAge_ms;
    uint32_t tofLastUpdate_ms;
    bool  tofReady;
    bool  tofValid;
    float cpuCore0_pct, cpuCore1_pct;
    bool  cpuValid;
    float motorFL, motorFR, motorRL, motorRR;
    float batteryVoltage_v;
    float batteryAdcVoltage_v;
    float batteryCellVoltage_v;
    float batteryPercent;
    bool  batteryValid;
    bool  batteryLow;
    bool  batteryCritical;
    float pidRollOut, pidPitchOut, pidYawOut;   // true PID outputs for tuning trace
    float motorFLPreSat, motorFRPreSat, motorRLPreSat, motorRRPreSat;
    uint32_t loopPeriod_us, imuRead_us, rcRead_us, ahrsUpdate_us;
    uint32_t controlUpdate_us, motorWrite_us, wifiService_us, onboardLogWrite_us;
    int16_t loopJitter_us;
    uint32_t missedLoopCount;

    // Extended flight-log / telemetry debug fields
    float rawAx_g, rawAy_g, rawAz_g;
    float rawGx_dps, rawGy_dps, rawGz_dps;
    float filtAx_g, filtAy_g, filtAz_g;
    float filtGx_dps, filtGy_dps, filtGz_dps;
    float magNorm_uT;
    bool  ekfMagUsed;
    float ekfBgx_dps, ekfBgy_dps, ekfBgz_dps;
    float targetRollDeg, targetPitchDeg, targetYawDeg;
    float targetRollRateDps, targetPitchRateDps, targetYawRateDps;
    float rollRateError_dps, pitchRateError_dps, yawRateError_dps;
    float yawError_deg;
    bool  motorSaturated;
    bool  angleModeActive, acroModeActive;
    uint32_t rcFailsafeCount;
    uint16_t modeSwitchRaw_us, armSwitchRaw_us;
    uint16_t auxTune1Raw_us, auxTune2Raw_us;
    bool  angleLoopEnabled, rateLoopEnabled;
    float actualRollRate_dps, actualPitchRate_dps, actualYawRate_dps;
    float angleRollP, angleRollI, angleRollD;
    float anglePitchP, anglePitchI, anglePitchD;
    float rateRollP, rateRollI, rateRollD;
    float ratePitchP, ratePitchI, ratePitchD;
    float rateYawP, rateYawI, rateYawD;
    float angleRollIterm, anglePitchIterm;
    uint32_t pidResetCount;
    uint32_t modeTransitionCount, lastModeChange_ms;
    uint32_t armingTransitionCount, lastArmChange_ms;
    bool  throttleLow;
    float controlAuthorityRemaining;
    bool  rollOutputLimited, pitchOutputLimited, yawOutputLimited, rateOutputLimited;
    float cmdRpmFL, cmdRpmFR, cmdRpmRL, cmdRpmRR;
    float actualRpmFL, actualRpmFR, actualRpmRL, actualRpmRR;
    bool  rpmActualValid;
    float bmpVerticalSpeed_mps;
    float ekfPosZ_m, ekfVelZ_mps;
    uint32_t tofEkfLastFused_ms, tofEkfAge_ms;
    bool  tofEkfVelocityAccepted;
    bool  altitudeHoldRequested, altitudeHoldReady, altitudeHoldActive;
    float altitudeHoldSetpoint_m, altitudeHoldError_m, altitudeHoldThrottleTrim;

    // Diagnostic attitude sources for PID/AHRS review
    float accelRoll_deg, accelPitch_deg;        // accel-only tilt estimate
    float gyroRoll_deg,  gyroPitch_deg, gyroYaw_deg; // integrated gyro-only estimate
    float rollAngleError_deg, pitchAngleError_deg;   // AHRS - accel estimate

    RCCommand rc;
    bool  armed;
    uint32_t loopCount;
    GPSData gps;
};
static FlightState       g_state;
static SemaphoreHandle_t g_flightMutex;
static SemaphoreHandle_t g_i2cMutex;

static volatile uint32_t g_pidResetCount = 0;
static volatile uint32_t g_modeTransitionCount = 0;
static volatile uint32_t g_lastModeChangeMs = 0;
static volatile uint32_t g_armingTransitionCount = 0;
static volatile uint32_t g_lastArmChangeMs = 0;
static bool g_transitionTrackerInitialized = false;
static FlightMode g_lastObservedMode = FlightMode::DISARMED;
static bool g_lastObservedArmed = false;

// Software level-zero trim state. Offset is post-AHRS only.
static float g_levelRollOffsetDeg  = 0.0f;
static float g_levelPitchOffsetDeg = 0.0f;
static float g_levelYawOffsetDeg   = 0.0f;

// PID-trace toggle (Serial 'p'). Off at boot so the log stays clean.
static volatile bool g_pidTrace = false;

// ─────────────────────────────────────────────────────────────
//  Tuning state
// ─────────────────────────────────────────────────────────────
struct TuningState {
    // Pilot command limits
    float max_angle_deg;
    float max_rate_dps;
    float max_pitch_rate_dps;

    // PID output authority limits before motor mixing
    float roll_output_limit;
    float pitch_output_limit;
    float yaw_output_limit;

    // Throttle shaping + motor output limits
    float throttle_expo;
    float throttle_up_rate_per_sec;
    float throttle_down_rate_per_sec;
    float motor_idle;
    float motor_max;
    float throttle_cut;
    float idle_ramp_end;
    float pid_ilimit;

    // Inner rate loop PID
    float pid_roll_kp,  pid_roll_ki,  pid_roll_kd;
    float pid_pitch_kp, pid_pitch_ki, pid_pitch_kd;
    float pid_yaw_kp,   pid_yaw_ki,   pid_yaw_kd;
    float pid_roll_ff,  pid_pitch_ff,  pid_yaw_ff;
    float pid_roll_d_lpf_hz, pid_pitch_d_lpf_hz, pid_yaw_d_lpf_hz;

    // Outer angle loop PID
    float pid_angle_roll_kp,  pid_angle_roll_ki,  pid_angle_roll_kd;
    float pid_angle_pitch_kp, pid_angle_pitch_ki, pid_angle_pitch_kd;

    // Outer yaw heading-hold loop
    float pid_angle_yaw_kp;
    float yaw_deadband;
    float yaw_max_rate_dps;

    // AHRS / estimator selection
    float mahony_kp, mahony_ki;
    float ahrs_filter_mode;
    float madgwick_beta;

    // Motor vibration notch filter
    bool  notch_enable;
    float notch_freq_hz;
    float notch_q;

    // Attitude EKF tuning
    float ekf_angle_q;
    float ekf_bias_q;
    float ekf_accel_r;
    float ekf_mag_r;
    float ekf_mag_declination_deg;
    float ekf_mag_yaw_offset_deg;
    float ekf_mag_yaw_sign;
    float alt_hold_kp;
    float alt_hold_kd;
    float alt_hold_max_trim;

    volatile bool dirty;
};
static TuningState       g_tuning;
static SemaphoreHandle_t g_tuneMutex;

// Versioned NVS record for runtime tuning. The size and CRC checks make a
// firmware update or interrupted flash write fall back safely to defaults.
static constexpr uint32_t TUNING_NVS_MAGIC   = 0x54554E45UL; // "TUNE"
static constexpr uint16_t TUNING_NVS_SCHEMA  = 2;
static constexpr char     TUNING_NVS_NS[]    = "flightTune";
static constexpr char     TUNING_NVS_KEY[]   = "state";

struct PersistedTuningRecord {
    uint32_t magic;
    uint16_t schema;
    uint16_t stateSize;
    TuningState state;
    uint32_t crc32;
};

static uint32_t tuningCrc32(const uint8_t* data, size_t length)
{
    uint32_t crc = 0xFFFFFFFFUL;
    for (size_t i = 0; i < length; ++i) {
        crc ^= data[i];
        for (uint8_t bit = 0; bit < 8; ++bit)
            crc = (crc >> 1) ^ (0xEDB88320UL & (0UL - (crc & 1UL)));
    }
    return ~crc;
}

static bool tuningRecordValid(const void* recordData)
{
    const PersistedTuningRecord& record =
        *static_cast<const PersistedTuningRecord*>(recordData);
    if (record.magic != TUNING_NVS_MAGIC ||
        record.schema != TUNING_NVS_SCHEMA ||
        record.stateSize != sizeof(TuningState)) return false;
    return record.crc32 == tuningCrc32(
        reinterpret_cast<const uint8_t*>(&record.state), sizeof(record.state));
}

// Caller holds g_tuneMutex. Writes occur only after /tune has confirmed the
// aircraft is disarmed and constrained all incoming values.
static bool saveTuningToNvsLocked()
{
    PersistedTuningRecord record{};
    record.magic = TUNING_NVS_MAGIC;
    record.schema = TUNING_NVS_SCHEMA;
    record.stateSize = sizeof(TuningState);
    record.state = g_tuning;
    record.state.dirty = false;
    record.crc32 = tuningCrc32(
        reinterpret_cast<const uint8_t*>(&record.state), sizeof(record.state));

    Preferences prefs;
    if (!prefs.begin(TUNING_NVS_NS, false)) return false;
    const size_t written = prefs.putBytes(TUNING_NVS_KEY, &record, sizeof(record));
    PersistedTuningRecord verify{};
    const size_t read = prefs.getBytes(TUNING_NVS_KEY, &verify, sizeof(verify));
    prefs.end();
    return written == sizeof(record) && read == sizeof(verify) &&
           tuningRecordValid(&verify) && verify.crc32 == record.crc32;
}

// Defaults must already be present in g_tuning. Invalid, missing, or obsolete
// records are ignored, leaving those firmware defaults intact.
static bool loadTuningFromNvs()
{
    Preferences prefs;
    if (!prefs.begin(TUNING_NVS_NS, true)) return false;
    if (prefs.getBytesLength(TUNING_NVS_KEY) != sizeof(PersistedTuningRecord)) {
        prefs.end();
        return false;
    }
    PersistedTuningRecord record{};
    const size_t read = prefs.getBytes(TUNING_NVS_KEY, &record, sizeof(record));
    prefs.end();
    if (read != sizeof(record) || !tuningRecordValid(&record)) return false;
    g_tuning = record.state;
    g_tuning.dirty = true;
    return true;
}

// Tune transaction diagnostics for GCS verification.
// request_seq increments when /tune accepts a payload while disarmed.
// apply_seq follows request_seq after taskControl applies the values to PID/AHRS objects.
// reject_seq increments when /tune is rejected, typically because the drone is armed.
static volatile uint32_t g_tuneRequestSeq = 0;
static volatile uint32_t g_tuneApplySeq   = 0;
static volatile uint32_t g_tuneRejectSeq  = 0;
static volatile bool     g_notchResetPending = false;
static volatile uint8_t  g_ahrsFilterModeActive = 0;

// ─────────────────────────────────────────────────────────────
//  Calibration state machine
// ─────────────────────────────────────────────────────────────
enum class CalibState : uint8_t {
    IDLE=0, REQUESTED, RUNNING_GYRO, RUNNING_ACCEL, RUNNING_MAG, SAVING, DONE
};
static volatile CalibState g_calibState = CalibState::IDLE;

// ─────────────────────────────────────────────────────────────
//  Task handles
// ─────────────────────────────────────────────────────────────
static TaskHandle_t hTaskIMU    = nullptr;
static TaskHandle_t hTaskControl= nullptr;
static TaskHandle_t hTaskRC     = nullptr;
static TaskHandle_t hTaskSerial = nullptr;
static TaskHandle_t hTaskWiFi   = nullptr;
static TaskHandle_t hTaskBMP    = nullptr;
static TaskHandle_t hTaskToF    = nullptr;
static TaskHandle_t hTaskCPU    = nullptr;
static TaskHandle_t hTaskGPS    = nullptr;

// High-resolution 400 Hz release timer.
// This is better than vTaskDelayUntil() when the FreeRTOS tick is coarse,
// and better than a busy-wait because the control task blocks between releases
// so the watchdog/idle task still gets CPU time.
static esp_timer_handle_t g_controlTimer = nullptr;

static void controlTimerCallback(void* /*arg*/)
{
    if (hTaskControl != nullptr) {
        xTaskNotifyGive(hTaskControl);
    }
}

static PidController pidRateRoll(
    TUNE_RATE_ROLL_KP, TUNE_RATE_ROLL_KI, TUNE_RATE_ROLL_KD);
static PidController pidRatePitch(
    TUNE_RATE_PITCH_KP, TUNE_RATE_PITCH_KI, TUNE_RATE_PITCH_KD);
static PidController pidRateYaw(
    TUNE_RATE_YAW_KP, TUNE_RATE_YAW_KI, TUNE_RATE_YAW_KD);

static PidController pidAngleRoll(
    TUNE_ANGLE_ROLL_KP, TUNE_ANGLE_ROLL_KI, TUNE_ANGLE_ROLL_KD);
static PidController pidAnglePitch(
    TUNE_ANGLE_PITCH_KP, TUNE_ANGLE_PITCH_KI, TUNE_ANGLE_PITCH_KD);
static PidController pidAngleYaw(TUNE_ANGLE_YAW_KP, 0.0f, 0.0f);

// ─────────────────────────────────────────────────────────────
//  Tuning sync helpers
// ─────────────────────────────────────────────────────────────
static void syncTuningFromObjects()
{
    // Copy compile-time defaults into runtime-tunable state at boot.
    g_tuning.max_angle_deg              = TUNE_MAX_ANGLE_DEG;
    g_tuning.max_rate_dps               = TUNE_MAX_RATE_DPS;
    g_tuning.max_pitch_rate_dps         = TUNE_MAX_RATE_DPS;

    g_tuning.roll_output_limit          = TUNE_ROLL_OUTPUT_LIMIT;
    g_tuning.pitch_output_limit         = TUNE_PITCH_OUTPUT_LIMIT;
    g_tuning.yaw_output_limit           = TUNE_YAW_OUTPUT_LIMIT;

    g_tuning.throttle_expo              = TUNE_THROTTLE_EXPO;
    g_tuning.throttle_up_rate_per_sec   = TUNE_THROTTLE_UP_RATE_PER_SEC;
    g_tuning.throttle_down_rate_per_sec = TUNE_THROTTLE_DOWN_RATE_PER_SEC;
    g_tuning.motor_idle                 = TUNE_MOTOR_IDLE;
    g_tuning.motor_max                  = TUNE_MOTOR_MAX;
    g_tuning.throttle_cut               = TUNE_THROTTLE_CUT;
    g_tuning.idle_ramp_end              = TUNE_IDLE_RAMP_END;
    g_tuning.pid_ilimit                 = pidRateRoll.iLimit;

    g_tuning.pid_roll_kp                = pidRateRoll.kp;
    g_tuning.pid_roll_ki                = pidRateRoll.ki;
    g_tuning.pid_roll_kd                = pidRateRoll.kd;
    g_tuning.pid_pitch_kp               = pidRatePitch.kp;
    g_tuning.pid_pitch_ki               = pidRatePitch.ki;
    g_tuning.pid_pitch_kd               = pidRatePitch.kd;
    g_tuning.pid_yaw_kp                 = pidRateYaw.kp;
    g_tuning.pid_yaw_ki                 = pidRateYaw.ki;
    g_tuning.pid_yaw_kd                 = pidRateYaw.kd;
    g_tuning.pid_roll_ff                = TUNE_RATE_ROLL_FF;
    g_tuning.pid_pitch_ff               = TUNE_RATE_PITCH_FF;
    g_tuning.pid_yaw_ff                 = TUNE_RATE_YAW_FF;
    g_tuning.pid_roll_d_lpf_hz          = TUNE_RATE_ROLL_D_LPF_HZ;
    g_tuning.pid_pitch_d_lpf_hz         = TUNE_RATE_PITCH_D_LPF_HZ;
    g_tuning.pid_yaw_d_lpf_hz           = TUNE_RATE_YAW_D_LPF_HZ;

    g_tuning.pid_angle_roll_kp          = pidAngleRoll.kp;
    g_tuning.pid_angle_roll_ki          = pidAngleRoll.ki;
    g_tuning.pid_angle_roll_kd          = pidAngleRoll.kd;
    g_tuning.pid_angle_pitch_kp         = pidAnglePitch.kp;
    g_tuning.pid_angle_pitch_ki         = pidAnglePitch.ki;
    g_tuning.pid_angle_pitch_kd         = pidAnglePitch.kd;
    g_tuning.pid_angle_yaw_kp           = pidAngleYaw.kp;
    g_tuning.yaw_deadband               = TUNE_YAW_DEADBAND;
    g_tuning.yaw_max_rate_dps           = TUNE_YAW_MAX_RATE_DPS;

    g_tuning.mahony_kp                  = mahony.kp();
    g_tuning.mahony_ki                  = mahony.ki();
    g_tuning.ahrs_filter_mode           = TUNE_AHRS_FILTER_MODE;
    g_tuning.madgwick_beta              = TUNE_MADGWICK_BETA;
    g_tuning.notch_enable               = TUNE_NOTCH_ENABLE;
    g_tuning.notch_freq_hz              = TUNE_NOTCH_FREQ_HZ;
    g_tuning.notch_q                    = TUNE_NOTCH_Q;
    g_tuning.ekf_angle_q                = TUNE_EKF_ANGLE_Q;
    g_tuning.ekf_bias_q                 = TUNE_EKF_BIAS_Q;
    g_tuning.ekf_accel_r                = TUNE_EKF_ACCEL_R;
    g_tuning.ekf_mag_r                  = TUNE_EKF_MAG_R;
    g_tuning.ekf_mag_declination_deg    = TUNE_EKF_MAG_DECL_DEG;
    g_tuning.ekf_mag_yaw_offset_deg     = TUNE_EKF_MAG_YAW_OFF_DEG;
    g_tuning.ekf_mag_yaw_sign           = TUNE_EKF_MAG_YAW_SIGN;
    g_tuning.alt_hold_kp                = TUNE_ALT_HOLD_KP;
    g_tuning.alt_hold_kd                = TUNE_ALT_HOLD_KD;
    g_tuning.alt_hold_max_trim          = TUNE_ALT_HOLD_MAX_TRIM;
    g_tuning.dirty                      = false;
}
// Copy g_tuning into live PID/AHRS objects. Caller already holds g_tuneMutex.
static void applyTuningToObjectsLocked()
{
    pidRateRoll.kp         = g_tuning.pid_roll_kp;
    pidRateRoll.ki         = g_tuning.pid_roll_ki;
    pidRateRoll.kd         = g_tuning.pid_roll_kd;
    pidRatePitch.kp        = g_tuning.pid_pitch_kp;
    pidRatePitch.ki        = g_tuning.pid_pitch_ki;
    pidRatePitch.kd        = g_tuning.pid_pitch_kd;
    pidRateYaw.kp          = g_tuning.pid_yaw_kp;
    pidRateYaw.ki          = g_tuning.pid_yaw_ki;
    pidRateYaw.kd          = g_tuning.pid_yaw_kd;

    pidAngleRoll.kp        = g_tuning.pid_angle_roll_kp;
    pidAngleRoll.ki        = g_tuning.pid_angle_roll_ki;
    pidAngleRoll.kd        = g_tuning.pid_angle_roll_kd;
    pidAnglePitch.kp       = g_tuning.pid_angle_pitch_kp;
    pidAnglePitch.ki       = g_tuning.pid_angle_pitch_ki;
    pidAnglePitch.kd       = g_tuning.pid_angle_pitch_kd;
    pidAngleYaw.kp         = g_tuning.pid_angle_yaw_kp;

    // Apply the global I-limit to every PID object so the Config tab lever works.
    pidRateRoll.iLimit     = g_tuning.pid_ilimit;
    pidRatePitch.iLimit    = g_tuning.pid_ilimit;
    pidRateYaw.iLimit      = g_tuning.pid_ilimit;
    pidAngleRoll.iLimit    = g_tuning.pid_ilimit;
    pidAnglePitch.iLimit   = g_tuning.pid_ilimit;
    pidAngleYaw.iLimit     = g_tuning.pid_ilimit;

    mahony.setGains(g_tuning.mahony_kp, g_tuning.mahony_ki);
    madgwickAHRS.setBeta(constrain(g_tuning.madgwick_beta, 0.001f, 1.000f));
    g_tuning.ahrs_filter_mode = constrain(g_tuning.ahrs_filter_mode, 0.0f, 2.0f);

    const float notchHz = constrain(g_tuning.notch_freq_hz, 1.0f, NOTCH_SAMPLE_HZ * 0.45f);
    const float notchQ  = constrain(g_tuning.notch_q, 0.5f, 50.0f);
    notchAx.configure(NOTCH_SAMPLE_HZ, notchHz, notchQ, g_tuning.notch_enable);
    notchAy.configure(NOTCH_SAMPLE_HZ, notchHz, notchQ, g_tuning.notch_enable);
    notchAz.configure(NOTCH_SAMPLE_HZ, notchHz, notchQ, g_tuning.notch_enable);
    notchGx.configure(NOTCH_SAMPLE_HZ, notchHz, notchQ, g_tuning.notch_enable);
    notchGy.configure(NOTCH_SAMPLE_HZ, notchHz, notchQ, g_tuning.notch_enable);
    notchGz.configure(NOTCH_SAMPLE_HZ, notchHz, notchQ, g_tuning.notch_enable);

    attitudeEKF.setProcessNoise(constrain(g_tuning.ekf_angle_q, 0.000001f, 0.050000f),
                                constrain(g_tuning.ekf_bias_q,  0.000000001f, 0.001000f));
    attitudeEKF.setAccelMeasurementNoise(constrain(g_tuning.ekf_accel_r, 0.001f, 2.000f));
    attitudeEKF.setMagMeasurementNoise(constrain(g_tuning.ekf_mag_r, 0.001f, 5.000f));
    attitudeEKF.setMagDeclinationDeg(constrain(g_tuning.ekf_mag_declination_deg, -30.0f, 30.0f));
    attitudeEKF.setMagYawOffsetDeg(constrain(g_tuning.ekf_mag_yaw_offset_deg, -180.0f, 180.0f));
    attitudeEKF.setMagYawSign(g_tuning.ekf_mag_yaw_sign);
    g_tuning.alt_hold_kp       = constrain(g_tuning.alt_hold_kp, 0.0f, 0.500f);
    g_tuning.alt_hold_kd       = constrain(g_tuning.alt_hold_kd, 0.0f, 0.500f);
    g_tuning.alt_hold_max_trim = constrain(g_tuning.alt_hold_max_trim, 0.0f, 0.300f);

    g_tuning.dirty         = false;
    g_tuneApplySeq         = g_tuneRequestSeq;
}

static void applyTuningToObjects()
{
    if (xSemaphoreTake(g_tuneMutex, 0) != pdTRUE) return;
    applyTuningToObjectsLocked();
    g_notchResetPending = true;
    xSemaphoreGive(g_tuneMutex);
}
// ─────────────────────────────────────────────────────────────
//  Log helpers (push to WiFi ring buffer + Serial)
// ─────────────────────────────────────────────────────────────
static void calLog(const char* msg)  { telemetryWiFi.pushLog(msg); }
static void calLogf(const char* fmt, ...) {
    char buf[WIFI_LOG_LINE_LEN];
    va_list args; va_start(args,fmt); vsnprintf(buf,sizeof(buf),fmt,args); va_end(args);
    telemetryWiFi.pushLog(buf);
}

static const char* calModeName(CalibrationMode mode)
{
    switch (mode) {
        case CalibrationMode::ESC:            return "ESC";
        case CalibrationMode::GYRO_BIAS:      return "GYRO_BIAS";
        case CalibrationMode::ACCEL_6_FACE:   return "ACCEL_6_FACE";
        case CalibrationMode::MAG_MINMAX:     return "MAG_MINMAX";
        case CalibrationMode::IMU_ALL_GUIDED: return "IMU_ALL_GUIDED";
        case CalibrationMode::NONE:
        default:                              return "NONE";
    }
}

static const char* calStateName(CalibrationState state)
{
    switch (state) {
        case CalibrationState::REQUESTED:              return "REQUESTED";
        case CalibrationState::WAITING_FOR_SAFE:       return "WAITING_FOR_SAFE";
        case CalibrationState::WAITING_FOR_STILLNESS:  return "WAITING_FOR_STILLNESS";
        case CalibrationState::WAITING_FOR_USER_STEP:  return "WAITING_FOR_USER_STEP";
        case CalibrationState::COLLECTING:             return "COLLECTING";
        case CalibrationState::COMPUTING:              return "COMPUTING";
        case CalibrationState::SAVING:                 return "SAVING";
        case CalibrationState::DONE:                   return "DONE";
        case CalibrationState::FAILED:                 return "FAILED";
        case CalibrationState::CANCELLED:              return "CANCELLED";
        case CalibrationState::IDLE:
        default:                                       return "IDLE";
    }
}

static const char* calSourceName(CalibrationSource source)
{
    switch (source) {
        case CalibrationSource::WEB: return "WEB";
        case CalibrationSource::RC:  return "RC";
        case CalibrationSource::NONE:
        default:                     return "NONE";
    }
}

// ─────────────────────────────────────────────────────────────
//  Timing JSON provider — /timing endpoint (Test 7.1)
// ─────────────────────────────────────────────────────────────
static String provideTimingJson()
{
    if (xSemaphoreTake(g_timingMutex, pdMS_TO_TICKS(20)) != pdTRUE) {
        return F("{\"ok\":false,\"error\":\"mutex timeout\"}");
    }

    uint32_t count      = g_timing.count;
    double   periodMean = g_timing.wMean;
    double   periodStd  = (count > 1) ? sqrt(g_timing.wM2 / (count - 1)) : 0.0;
    double   jitterMean = g_timing.jMean;
    double   jitterStd  = (count > 1) ? sqrt(g_timing.jM2 / (count - 1)) : 0.0;
    uint32_t jitterMax  = g_timing.jitterMax;
    uint32_t violations = g_timing.jitterViolations;

    static uint16_t sortBuf[TIMING_BUF_SIZE];
    uint16_t n    = g_timing.bufFull ? TIMING_BUF_SIZE : g_timing.bufHead;
    uint16_t head = g_timing.bufFull ? g_timing.bufHead : 0;
    for (uint16_t i = 0; i < n; i++) {
        uint16_t period = g_timing.buf[(head + i) % TIMING_BUF_SIZE];
        int32_t  jit    = (int32_t)period - (int32_t)TIMING_TARGET_US;
        if (jit < 0) jit = -jit;
        sortBuf[i] = (uint16_t)min((uint32_t)jit, (uint32_t)65535);
    }
    xSemaphoreGive(g_timingMutex);

    for (uint16_t i = 1; i < n; i++) {
        uint16_t key = sortBuf[i]; int j = i - 1;
        while (j >= 0 && sortBuf[j] > key) { sortBuf[j+1]=sortBuf[j]; j--; }
        sortBuf[j+1] = key;
    }

    float p99 = 0.0f;
    if (n > 0) {
        uint16_t idx = (uint16_t)(0.99f * (float)(n - 1));
        p99 = (float)sortBuf[idx];
    }

    const float targetHz = 1000000.0f / (float)TIMING_TARGET_US;
    const float violationRatePct = (count > 0)
                                 ? (100.0f * (float)violations / (float)count)
                                 : 0.0f;

    String j;
    j.reserve(520);
    j += F("{\"ok\":true");
    j += F(",\"loop_name\":\"control\"");
    j += F(",\"target_us\":");      j += String(TIMING_TARGET_US);
    j += F(",\"period_target_us\":"); j += String(TIMING_TARGET_US); // alias for GCS clarity
    j += F(",\"target_hz\":");      j += String(targetHz, 1);
    j += F(",\"violation_thresh_us\":"); j += String(JITTER_VIOLATION_US);
    j += F(",\"count\":");          j += String(count);
    j += F(",\"period_mean_us\":"); j += String((float)periodMean, 2);
    j += F(",\"period_std_us\":");  j += String((float)periodStd,  2);
    j += F(",\"jitter_mean_us\":"); j += String((float)jitterMean, 2);
    j += F(",\"jitter_std_us\":");  j += String((float)jitterStd,  2);
    j += F(",\"jitter_max_us\":");  j += String(jitterMax);
    j += F(",\"jitter_p99_us\":");  j += String(p99, 1);
    j += F(",\"violations\":");     j += String(violations);
    j += F(",\"violation_rate_pct\":"); j += String(violationRatePct, 3);
    j += F(",\"buf_samples\":");    j += String(n);
    j += '}';
    return j;
}

static String provideIdentityJson()
{
    String j;
    j.reserve(260);
    j += F("{\"ok\":true");
    j += F(",\"name\":\"");         j += FW_NAME;             j += '"';
    j += F(",\"version\":\"");      j += FW_VERSION;          j += '"';
    j += F(",\"sourceBranch\":\""); j += FW_SOURCE_BRANCH;    j += '"';
    j += F(",\"sourceCommit\":\""); j += FW_SOURCE_COMMIT;    j += '"';
    j += F(",\"sourceDirty\":");    j += FW_SOURCE_DIRTY ? F("true") : F("false");
    j += F(",\"buildId\":\"");      j += FW_BUILD_ID;         j += '"';
    j += F(",\"buildTime\":\"");    j += FW_BUILD_TIME_ISO;   j += '"';
    j += '}';
    return j;
}

// ─────────────────────────────────────────────────────────────
//  Timing CSV provider — /timing/csv endpoint (Test 7.1)
// ─────────────────────────────────────────────────────────────
static String provideTimingCsv()
{
    if (xSemaphoreTake(g_timingMutex, pdMS_TO_TICKS(20)) != pdTRUE) {
        return F("error,mutex_timeout\n");
    }
    uint16_t n    = g_timing.bufFull ? TIMING_BUF_SIZE : g_timing.bufHead;
    uint16_t head = g_timing.bufFull ? g_timing.bufHead : 0;

    static uint16_t tmp[TIMING_BUF_SIZE];
    for (uint16_t i = 0; i < n; i++) {
        tmp[i] = g_timing.buf[(head + i) % TIMING_BUF_SIZE];
    }
    xSemaphoreGive(g_timingMutex);

    String csv;
    csv.reserve((size_t)n * 18 + 32);
    csv += F("index,period_us,jitter_us\n");
    for (uint16_t i = 0; i < n; i++) {
        int32_t jit = (int32_t)tmp[i] - TIMING_TARGET_US;
        if (jit < 0) jit = -jit;
        csv += String(i);  csv += ',';
        csv += String(tmp[i]); csv += ',';
        csv += String((uint32_t)jit); csv += '\n';
    }
    return csv;
}

// ─────────────────────────────────────────────────────────────
//  Wi-Fi telemetry provider — /telemetry endpoint
// ─────────────────────────────────────────────────────────────
static const char* flightModeToStr(FlightMode m) {
    switch(m) {
        case FlightMode::DISARMED: return "DISARMED";
        case FlightMode::ANGLE:    return "ANGLE";
        case FlightMode::ACRO:     return "ACRO";
        case FlightMode::FAILSAFE: return "FAILSAFE";
        default:                   return "UNKNOWN";
    }
}

static void updateControlTransitionCounters(const RCCommand& cmd)
{
    const bool armedNow = cmd.valid &&
                          cmd.mode != FlightMode::DISARMED &&
                          cmd.mode != FlightMode::FAILSAFE;
    const uint32_t nowMs = millis();

    if (!g_transitionTrackerInitialized) {
        g_transitionTrackerInitialized = true;
        g_lastObservedMode = cmd.mode;
        g_lastObservedArmed = armedNow;
        return;
    }

    bool resetEvent = false;
    if (cmd.mode != g_lastObservedMode) {
        g_lastObservedMode = cmd.mode;
        g_modeTransitionCount++;
        g_lastModeChangeMs = nowMs;
        resetEvent = true;
    }

    if (armedNow != g_lastObservedArmed) {
        g_lastObservedArmed = armedNow;
        g_armingTransitionCount++;
        g_lastArmChangeMs = nowMs;
        resetEvent = true;
    }

    if (resetEvent) g_pidResetCount++;
}

static bool provideTelemetry(TelemetryPacket& out)
{
    FlightState s;
    if (xSemaphoreTake(g_flightMutex, pdMS_TO_TICKS(15)) != pdTRUE) return false;
    s = g_state;
    xSemaphoreGive(g_flightMutex);

    TuningState t;
    memset(&t, 0, sizeof(t));
    if (xSemaphoreTake(g_tuneMutex, pdMS_TO_TICKS(5)) == pdTRUE) {
        t = g_tuning; xSemaphoreGive(g_tuneMutex);
    }

    out.tick      = s.loopCount;
    out.mode      = flightModeToStr(s.rc.mode);
    out.armed     = s.armed;
    out.rc_valid  = s.rc.valid;
    out.imu_valid = s.imuValid;
    out.mag_valid = s.magValid;
    out.ahrs_filter_mode = s.ahrsFilterMode;
    out.ahrs_filter = (s.ahrsFilterMode == 1) ? "Mahony" : ((s.ahrsFilterMode == 2) ? "Madgwick" : "EKF");
    out.roll_deg  = s.roll_deg;  out.pitch_deg = s.pitch_deg; out.yaw_deg = s.yaw_deg;
    out.q0=s.q0; out.q1=s.q1; out.q2=s.q2; out.q3=s.q3;
    out.roll_ctrl_deg  = s.roll_ctrl_deg;
    out.pitch_ctrl_deg = s.pitch_ctrl_deg;
    out.yaw_ctrl_deg   = s.yaw_ctrl_deg;
    out.roll_offset_deg  = s.roll_offset_deg;
    out.pitch_offset_deg = s.pitch_offset_deg;
    out.yaw_offset_deg   = s.yaw_offset_deg;
    out.ax_g=s.ax_g; out.ay_g=s.ay_g; out.az_g=s.az_g;
    out.gx_dps=s.gx_dps; out.gy_dps=s.gy_dps; out.gz_dps=s.gz_dps;
    out.mx_uT=s.mx_uT;   out.my_uT=s.my_uT;   out.mz_uT=s.mz_uT;
    out.imu_temp_c=s.imuTemp_c;
    out.raw_ax_g=s.rawAx_g; out.raw_ay_g=s.rawAy_g; out.raw_az_g=s.rawAz_g;
    out.raw_gx_dps=s.rawGx_dps; out.raw_gy_dps=s.rawGy_dps; out.raw_gz_dps=s.rawGz_dps;
    out.filt_ax_g=s.filtAx_g; out.filt_ay_g=s.filtAy_g; out.filt_az_g=s.filtAz_g;
    out.filt_gx_dps=s.filtGx_dps; out.filt_gy_dps=s.filtGy_dps; out.filt_gz_dps=s.filtGz_dps;
    out.mag_norm_uT=s.magNorm_uT;
    out.ekf_mag_used=s.ekfMagUsed;
    out.ekf_bgx_dps=s.ekfBgx_dps; out.ekf_bgy_dps=s.ekfBgy_dps; out.ekf_bgz_dps=s.ekfBgz_dps;
    out.target_roll_deg=s.targetRollDeg; out.target_pitch_deg=s.targetPitchDeg; out.target_yaw_deg=s.targetYawDeg;
    out.target_roll_rate_dps=s.targetRollRateDps; out.target_pitch_rate_dps=s.targetPitchRateDps; out.target_yaw_rate_dps=s.targetYawRateDps;
    out.roll_rate_error_dps=s.rollRateError_dps; out.pitch_rate_error_dps=s.pitchRateError_dps; out.yaw_rate_error_dps=s.yawRateError_dps;
    out.yaw_error_deg=s.yawError_deg;
    out.motor_saturated=s.motorSaturated;
    out.angle_mode_active=s.angleModeActive; out.acro_mode_active=s.acroModeActive;
    out.rc_ch1_us=s.rc.raw[0]; out.rc_ch2_us=s.rc.raw[1]; out.rc_ch3_us=s.rc.raw[2]; out.rc_ch4_us=s.rc.raw[3]; out.rc_ch5_us=s.rc.raw[4];
    out.rc_ch6_us=s.rc.raw[5]; out.rc_ch7_us=s.rc.raw[6]; out.rc_ch8_us=s.rc.raw[7]; out.rc_ch9_us=s.rc.raw[8]; out.rc_ch10_us=s.rc.raw[9];
    out.rc_failsafe_count=s.rcFailsafeCount;
    out.mode_switch_raw_us=s.modeSwitchRaw_us; out.arm_switch_raw_us=s.armSwitchRaw_us;
    out.aux_tune1_raw_us=s.auxTune1Raw_us; out.aux_tune2_raw_us=s.auxTune2Raw_us;
    out.angle_loop_enabled=s.angleLoopEnabled; out.rate_loop_enabled=s.rateLoopEnabled;
    out.actual_roll_rate_dps=s.actualRollRate_dps;
    out.actual_pitch_rate_dps=s.actualPitchRate_dps;
    out.actual_yaw_rate_dps=s.actualYawRate_dps;
    out.angle_roll_p=s.angleRollP; out.angle_roll_i=s.angleRollI; out.angle_roll_d=s.angleRollD;
    out.angle_pitch_p=s.anglePitchP; out.angle_pitch_i=s.anglePitchI; out.angle_pitch_d=s.anglePitchD;
    out.rate_roll_p=s.rateRollP; out.rate_roll_i=s.rateRollI; out.rate_roll_d=s.rateRollD;
    out.rate_pitch_p=s.ratePitchP; out.rate_pitch_i=s.ratePitchI; out.rate_pitch_d=s.ratePitchD;
    out.rate_yaw_p=s.rateYawP; out.rate_yaw_i=s.rateYawI; out.rate_yaw_d=s.rateYawD;
    out.angle_roll_iterm=s.angleRollIterm; out.angle_pitch_iterm=s.anglePitchIterm;
    out.pid_reset_count=s.pidResetCount;
    out.mode_transition_count=s.modeTransitionCount; out.last_mode_change_ms=s.lastModeChange_ms;
    out.arming_transition_count=s.armingTransitionCount; out.last_arm_change_ms=s.lastArmChange_ms;
    out.throttle_low=s.throttleLow;
    out.control_authority_remaining=s.controlAuthorityRemaining;
    out.roll_output_limited=s.rollOutputLimited;
    out.pitch_output_limited=s.pitchOutputLimited;
    out.yaw_output_limited=s.yawOutputLimited;
    out.rate_output_limited=s.rateOutputLimited;
    out.bmp_vertical_speed_mps=s.bmpVerticalSpeed_mps;

    out.accel_roll_deg  = s.accelRoll_deg;
    out.accel_pitch_deg = s.accelPitch_deg;
    out.gyro_roll_deg   = s.gyroRoll_deg;
    out.gyro_pitch_deg  = s.gyroPitch_deg;
    out.gyro_yaw_deg    = s.gyroYaw_deg;
    out.roll_angle_error_deg  = s.rollAngleError_deg;
    out.pitch_angle_error_deg = s.pitchAngleError_deg;
    out.pid_roll_out  = s.pidRollOut;
    out.pid_pitch_out = s.pidPitchOut;
    out.pid_yaw_out   = s.pidYawOut;
    out.throttle=s.rc.throttle; out.rc_roll=s.rc.roll;
    out.rc_pitch=s.rc.pitch;    out.rc_yaw=s.rc.yaw;
    out.rc_hz=rcReceiver.getFrameRate();
    out.battery_voltage_v=s.batteryVoltage_v;
    out.battery_adc_v=s.batteryAdcVoltage_v;
    out.battery_cell_v=s.batteryCellVoltage_v;
    out.battery_percent=s.batteryPercent;
    out.battery_valid=s.batteryValid;
    out.battery_low=s.batteryLow;
    out.battery_critical=s.batteryCritical;
    out.motor_fl=s.motorFL; out.motor_fr=s.motorFR;
    out.motor_rl=s.motorRL; out.motor_rr=s.motorRR;
    out.motor_fl_pre_sat=s.motorFLPreSat; out.motor_fr_pre_sat=s.motorFRPreSat;
    out.motor_rl_pre_sat=s.motorRLPreSat; out.motor_rr_pre_sat=s.motorRRPreSat;
    out.loop_period_us=s.loopPeriod_us;
    out.loop_jitter_us=s.loopJitter_us;
    out.imu_read_us=s.imuRead_us;
    out.rc_read_us=s.rcRead_us;
    out.ahrs_update_us=s.ahrsUpdate_us;
    out.control_update_us=s.controlUpdate_us;
    out.motor_write_us=s.motorWrite_us;
    out.wifi_service_us=s.wifiService_us;
    out.onboard_log_write_us=s.onboardLogWrite_us;
    out.missed_loop_count=s.missedLoopCount;
    out.cmd_rpm_fl=s.cmdRpmFL; out.cmd_rpm_fr=s.cmdRpmFR;
    out.cmd_rpm_rl=s.cmdRpmRL; out.cmd_rpm_rr=s.cmdRpmRR;
    // Backward-compatible aliases: until ESC RPM telemetry is added, rpm* means commanded/estimated RPM.
    out.rpm_fl=out.cmd_rpm_fl; out.rpm_fr=out.cmd_rpm_fr;
    out.rpm_rl=out.cmd_rpm_rl; out.rpm_rr=out.cmd_rpm_rr;
    out.actual_rpm_fl=s.actualRpmFL; out.actual_rpm_fr=s.actualRpmFR;
    out.actual_rpm_rl=s.actualRpmRL; out.actual_rpm_rr=s.actualRpmRR;
    out.rpm_actual_valid=s.rpmActualValid;
    out.bmp_temp_c=s.bmpTemp_c; out.bmp_pressure_hpa=s.bmpPressure_hpa;
    out.bmp_altitude_m=s.bmpAltitude_m; out.bmp_valid=s.bmpValid;
    out.tof_distance_m=s.tofDistance_m;
    out.tof_distance_mm=s.tofDistance_mm;
    out.tof_range_status=s.tofRangeStatus;
    out.tof_object_count=s.tofObjectCount;
    out.tof_stream_count=s.tofStreamCount;
    out.tof_signal_mcps=s.tofSignalMcps;
    out.tof_ambient_mcps=s.tofAmbientMcps;
    out.tof_age_ms=s.tofAge_ms;
    out.tof_last_update_ms=s.tofLastUpdate_ms;
    out.tof_ready=s.tofReady;
    out.tof_valid=s.tofValid;
    out.ekf_pos_z_m=s.ekfPosZ_m;
    out.ekf_vel_z_mps=s.ekfVelZ_mps;
    out.tof_ekf_last_fused_ms=s.tofEkfLastFused_ms;
    out.tof_ekf_age_ms=s.tofEkfAge_ms;
    out.tof_ekf_velocity_accepted=s.tofEkfVelocityAccepted;
    out.altitude_hold_requested=s.altitudeHoldRequested;
    out.altitude_hold_ready=s.altitudeHoldReady;
    out.altitude_hold_active=s.altitudeHoldActive;
    out.altitude_hold_setpoint_m=s.altitudeHoldSetpoint_m;
    out.altitude_hold_error_m=s.altitudeHoldError_m;
    out.altitude_hold_throttle_trim=s.altitudeHoldThrottleTrim;
    out.cpu_core0_pct=s.cpuCore0_pct; out.cpu_core1_pct=s.cpuCore1_pct;
    out.cpu_valid=s.cpuValid;

    out.max_angle_deg              = t.max_angle_deg;
    out.max_rate_dps               = t.max_rate_dps;
    out.max_pitch_rate_dps         = t.max_pitch_rate_dps;
    out.roll_output_limit          = t.roll_output_limit;
    out.pitch_output_limit         = t.pitch_output_limit;
    out.yaw_output_limit           = t.yaw_output_limit;
    out.throttle_expo              = t.throttle_expo;
    out.throttle_up_rate_per_sec   = t.throttle_up_rate_per_sec;
    out.throttle_down_rate_per_sec = t.throttle_down_rate_per_sec;
    out.motor_idle                 = t.motor_idle;
    out.motor_max                  = t.motor_max;
    out.throttle_cut               = t.throttle_cut;
    out.idle_ramp_end              = t.idle_ramp_end;
    out.pid_ilimit                 = t.pid_ilimit;

    out.pid_roll_kp=t.pid_roll_kp;   out.pid_roll_ki=t.pid_roll_ki;   out.pid_roll_kd=t.pid_roll_kd;
    out.pid_pitch_kp=t.pid_pitch_kp; out.pid_pitch_ki=t.pid_pitch_ki; out.pid_pitch_kd=t.pid_pitch_kd;
    out.pid_yaw_kp=t.pid_yaw_kp;     out.pid_yaw_ki=t.pid_yaw_ki;     out.pid_yaw_kd=t.pid_yaw_kd;
    out.pid_roll_ff=t.pid_roll_ff;   out.pid_pitch_ff=t.pid_pitch_ff; out.pid_yaw_ff=t.pid_yaw_ff;
    out.pid_roll_d_lpf_hz=t.pid_roll_d_lpf_hz; out.pid_pitch_d_lpf_hz=t.pid_pitch_d_lpf_hz; out.pid_yaw_d_lpf_hz=t.pid_yaw_d_lpf_hz;
    out.pid_angle_roll_kp=t.pid_angle_roll_kp;
    out.pid_angle_roll_ki=t.pid_angle_roll_ki;
    out.pid_angle_roll_kd=t.pid_angle_roll_kd;
    out.pid_angle_pitch_kp=t.pid_angle_pitch_kp;
    out.pid_angle_pitch_ki=t.pid_angle_pitch_ki;
    out.pid_angle_pitch_kd=t.pid_angle_pitch_kd;
    out.pid_angle_yaw_kp=t.pid_angle_yaw_kp;
    out.yaw_deadband=t.yaw_deadband;
    out.yaw_max_rate_dps=t.yaw_max_rate_dps;
    out.mahony_kp=t.mahony_kp; out.mahony_ki=t.mahony_ki;
    out.ahrs_filter_mode=t.ahrs_filter_mode;
    out.madgwick_beta=t.madgwick_beta;
    out.notch_enable=t.notch_enable;
    out.notch_freq_hz=t.notch_freq_hz;
    out.notch_q=t.notch_q;
    out.ekf_angle_q=t.ekf_angle_q;
    out.ekf_bias_q=t.ekf_bias_q;
    out.ekf_accel_r=t.ekf_accel_r;
    out.ekf_mag_r=t.ekf_mag_r;
    out.ekf_mag_declination_deg=t.ekf_mag_declination_deg;
    out.ekf_mag_yaw_offset_deg=t.ekf_mag_yaw_offset_deg;
    out.ekf_mag_yaw_sign=t.ekf_mag_yaw_sign;
    out.alt_hold_kp=t.alt_hold_kp;
    out.alt_hold_kd=t.alt_hold_kd;
    out.alt_hold_max_trim=t.alt_hold_max_trim;
    out.tune_request_seq = g_tuneRequestSeq;
    out.tune_apply_seq   = g_tuneApplySeq;
    out.tune_reject_seq  = g_tuneRejectSeq;
    out.tune_dirty       = t.dirty;
    out.gps_valid       = s.gps.valid;
    out.gps_lat         = s.gps.latitude;
    out.gps_lon         = s.gps.longitude;
    out.gps_altitude_m  = s.gps.altitude_m;
    out.gps_speed_kmh   = s.gps.speed_kmh;
    out.gps_course_deg  = s.gps.course_deg;
    out.gps_satellites  = s.gps.satellites;
    out.gps_hdop        = s.gps.hdop;
    out.gps_fix_quality = s.gps.fix_quality;
    out.gps_hour        = s.gps.hour;
    out.gps_minute      = s.gps.minute;
    out.gps_second      = s.gps.second;
    return true;
}

// ─────────────────────────────────────────────────────────────
//  Wi-Fi tune handler — /tune endpoint (Test 7.5)
// ─────────────────────────────────────────────────────────────
static bool handleTune(const TunePacket& in)
{
    bool armed = false;
    if (xSemaphoreTake(g_flightMutex, pdMS_TO_TICKS(5)) == pdTRUE) {
        armed = g_state.armed; xSemaphoreGive(g_flightMutex);
    }
    if (armed) {
        g_tuneRejectSeq++;
        calLog("[TUNE] REJECTED — disarm first.");
        return false;
    }

    if (xSemaphoreTake(g_tuneMutex, pdMS_TO_TICKS(10)) != pdTRUE) {
        g_tuneRejectSeq++;
        calLog("[TUNE] REJECTED — tune mutex timeout.");
        return false;
    }

    if (in.has_max_angle_deg)              g_tuning.max_angle_deg              = constrain(in.max_angle_deg, 5.0f, 80.0f);
    if (in.has_max_rate_dps)               g_tuning.max_rate_dps               = constrain(in.max_rate_dps, 30.0f, 1200.0f);
    if (in.has_max_pitch_rate_dps)         g_tuning.max_pitch_rate_dps         = constrain(in.max_pitch_rate_dps, 30.0f, 1200.0f);

    if (in.has_roll_output_limit)          g_tuning.roll_output_limit          = constrain(in.roll_output_limit, 0.02f, 1.00f);
    if (in.has_pitch_output_limit)         g_tuning.pitch_output_limit         = constrain(in.pitch_output_limit, 0.02f, 1.00f);
    if (in.has_yaw_output_limit)           g_tuning.yaw_output_limit           = constrain(in.yaw_output_limit, 0.01f, 1.00f);

    if (in.has_throttle_expo)              g_tuning.throttle_expo              = constrain(in.throttle_expo, 0.0f, 0.95f);
    if (in.has_throttle_up_rate_per_sec)   g_tuning.throttle_up_rate_per_sec   = constrain(in.throttle_up_rate_per_sec, 0.05f, 10.0f);
    if (in.has_throttle_down_rate_per_sec) g_tuning.throttle_down_rate_per_sec = constrain(in.throttle_down_rate_per_sec, 0.05f, 10.0f);
    if (in.has_motor_idle)                 g_tuning.motor_idle                 = constrain(in.motor_idle, 0.0f, 0.40f);
    if (in.has_motor_max)                  g_tuning.motor_max                  = constrain(in.motor_max, 0.10f, 1.00f);
    if (in.has_throttle_cut)               g_tuning.throttle_cut               = constrain(in.throttle_cut, 0.0f, 0.30f);
    if (in.has_idle_ramp_end)              g_tuning.idle_ramp_end              = constrain(in.idle_ramp_end, 0.01f, 0.60f);
    if (in.has_pid_ilimit)                 g_tuning.pid_ilimit                 = constrain(in.pid_ilimit, 0.0f, 1000.0f);

    // Keep idle/ramp relationships sane.
    if (g_tuning.motor_idle > g_tuning.motor_max) g_tuning.motor_idle = g_tuning.motor_max;
    if (g_tuning.idle_ramp_end <= g_tuning.throttle_cut) g_tuning.idle_ramp_end = g_tuning.throttle_cut + 0.01f;

    if (in.has_pid_roll_kp)        g_tuning.pid_roll_kp        = in.pid_roll_kp;
    if (in.has_pid_roll_ki)        g_tuning.pid_roll_ki        = in.pid_roll_ki;
    if (in.has_pid_roll_kd)        g_tuning.pid_roll_kd        = in.pid_roll_kd;
    if (in.has_pid_pitch_kp)       g_tuning.pid_pitch_kp       = in.pid_pitch_kp;
    if (in.has_pid_pitch_ki)       g_tuning.pid_pitch_ki       = in.pid_pitch_ki;
    if (in.has_pid_pitch_kd)       g_tuning.pid_pitch_kd       = in.pid_pitch_kd;
    if (in.has_pid_yaw_kp)         g_tuning.pid_yaw_kp         = in.pid_yaw_kp;
    if (in.has_pid_yaw_ki)         g_tuning.pid_yaw_ki         = in.pid_yaw_ki;
    if (in.has_pid_yaw_kd)         g_tuning.pid_yaw_kd         = in.pid_yaw_kd;
    if (in.has_pid_roll_ff)        g_tuning.pid_roll_ff        = in.pid_roll_ff;
    if (in.has_pid_pitch_ff)       g_tuning.pid_pitch_ff       = in.pid_pitch_ff;
    if (in.has_pid_yaw_ff)         g_tuning.pid_yaw_ff         = in.pid_yaw_ff;
    if (in.has_pid_roll_d_lpf_hz)  g_tuning.pid_roll_d_lpf_hz  = constrain(in.pid_roll_d_lpf_hz, 0.0f, 200.0f);
    if (in.has_pid_pitch_d_lpf_hz) g_tuning.pid_pitch_d_lpf_hz = constrain(in.pid_pitch_d_lpf_hz, 0.0f, 200.0f);
    if (in.has_pid_yaw_d_lpf_hz)   g_tuning.pid_yaw_d_lpf_hz   = constrain(in.pid_yaw_d_lpf_hz, 0.0f, 200.0f);
    if (in.has_pid_angle_roll_kp)  g_tuning.pid_angle_roll_kp  = in.pid_angle_roll_kp;
    if (in.has_pid_angle_roll_ki)  g_tuning.pid_angle_roll_ki  = in.pid_angle_roll_ki;
    if (in.has_pid_angle_roll_kd)  g_tuning.pid_angle_roll_kd  = in.pid_angle_roll_kd;
    if (in.has_pid_angle_pitch_kp) g_tuning.pid_angle_pitch_kp = in.pid_angle_pitch_kp;
    if (in.has_pid_angle_pitch_ki) g_tuning.pid_angle_pitch_ki = in.pid_angle_pitch_ki;
    if (in.has_pid_angle_pitch_kd) g_tuning.pid_angle_pitch_kd = in.pid_angle_pitch_kd;
    if (in.has_pid_angle_yaw_kp)   g_tuning.pid_angle_yaw_kp   = in.pid_angle_yaw_kp;
    if (in.has_yaw_deadband)       g_tuning.yaw_deadband       = constrain(in.yaw_deadband, 0.0f, 0.50f);
    if (in.has_yaw_max_rate_dps)   g_tuning.yaw_max_rate_dps   = constrain(in.yaw_max_rate_dps, 10.0f, 500.0f);
    if (in.has_mahony_kp)          g_tuning.mahony_kp          = in.mahony_kp;
    if (in.has_mahony_ki)          g_tuning.mahony_ki          = in.mahony_ki;
    if (in.has_ahrs_filter_mode)   g_tuning.ahrs_filter_mode   = constrain(in.ahrs_filter_mode, 0.0f, 2.0f);
    if (in.has_madgwick_beta)      g_tuning.madgwick_beta      = constrain(in.madgwick_beta, 0.001f, 1.000f);
    if (in.has_notch_enable)       g_tuning.notch_enable       = in.notch_enable;
    if (in.has_notch_freq_hz)      g_tuning.notch_freq_hz      = constrain(in.notch_freq_hz, 1.0f, NOTCH_SAMPLE_HZ * 0.45f);
    if (in.has_notch_q)            g_tuning.notch_q            = constrain(in.notch_q, 0.5f, 50.0f);

    if (in.has_ekf_angle_q)              g_tuning.ekf_angle_q             = constrain(in.ekf_angle_q, 0.000001f, 0.050000f);
    if (in.has_ekf_bias_q)               g_tuning.ekf_bias_q              = constrain(in.ekf_bias_q, 0.000000001f, 0.001000f);
    if (in.has_ekf_accel_r)              g_tuning.ekf_accel_r             = constrain(in.ekf_accel_r, 0.001f, 2.000f);
    if (in.has_ekf_mag_r)                g_tuning.ekf_mag_r               = constrain(in.ekf_mag_r, 0.001f, 5.000f);
    if (in.has_ekf_mag_declination_deg)  g_tuning.ekf_mag_declination_deg = constrain(in.ekf_mag_declination_deg, -30.0f, 30.0f);
    if (in.has_ekf_mag_yaw_offset_deg)   g_tuning.ekf_mag_yaw_offset_deg  = constrain(in.ekf_mag_yaw_offset_deg, -180.0f, 180.0f);
    if (in.has_ekf_mag_yaw_sign)         g_tuning.ekf_mag_yaw_sign        = (in.ekf_mag_yaw_sign < 0.0f) ? -1.0f : 1.0f;
    if (in.has_alt_hold_kp)              g_tuning.alt_hold_kp             = constrain(in.alt_hold_kp, 0.0f, 0.500f);
    if (in.has_alt_hold_kd)              g_tuning.alt_hold_kd             = constrain(in.alt_hold_kd, 0.0f, 0.500f);
    if (in.has_alt_hold_max_trim)        g_tuning.alt_hold_max_trim       = constrain(in.alt_hold_max_trim, 0.0f, 0.300f);
    // Accept and apply immediately while disarmed. This removes the confusing
    // one-cycle handshake where the POST succeeded but telemetry still showed
    // old values until taskControl got around to applying dirty tuning.
    g_tuneRequestSeq++;
    g_tuning.dirty = true;
    applyTuningToObjectsLocked();
    g_notchResetPending = true;
    const bool persisted = saveTuningToNvsLocked();
    uint32_t appliedSeq = g_tuneApplySeq;
    xSemaphoreGive(g_tuneMutex);

    if (!persisted) {
        DBG_PRINTF("[TUNE] Applied seq=%lu but NVS save verification FAILED.\n",
                   (unsigned long)appliedSeq);
        calLogf("[TUNE][ERROR] Applied seq=%lu but permanent save failed.",
                (unsigned long)appliedSeq);
        return false;
    }
    DBG_PRINTF("[TUNE] Applied and saved to NVS seq=%lu.\n", (unsigned long)appliedSeq);
    calLogf("[TUNE] Applied and saved permanently seq=%lu.", (unsigned long)appliedSeq);
    return true;
}

// ─────────────────────────────────────────────────────────────
//  Motor + SWC helpers
// ─────────────────────────────────────────────────────────────
static void motorsBegin()                                    { motorBegin(); }
static void writeMotors(float fl,float fr,float rl,float rr) { motorSet(fl,fr,rl,rr); }
static void motorsOff()                                      { motorOff(); }
static bool swcIsUp()     { return rcReceiver.getChannel(RC_CH_AUX3) >= SWC_THRESHOLD; }
static void waitSwcDown() { while (swcIsUp()) delay(20); }
static void silentWait(uint32_t ms) {
    uint32_t t = millis();
    while (millis()-t < ms) delay(50);
}

// ═════════════════════════════════════════════════════════════
//  AUTONOMOUS CALIBRATION (runs inside taskControl, Core 1)
// ═════════════════════════════════════════════════════════════
static void runAutonomousCalibration()
{
    calLog("[CAL] ═══ AUTONOMOUS CALIBRATION STARTED ═══");

    // ── Stage 1: Gyro ────────────────────────────────────────
    g_calibState = CalibState::RUNNING_GYRO;
    calLogf("[CAL] 1/3 GYRO — flat + still. Settle %ds, sample %ds...",
            GYRO_SETTLE_MS/1000, GYRO_SAMPLE_MS/1000);
    silentWait(GYRO_SETTLE_MS);
    {
        MPU_SensorData avg;
        imu.sampleAvg(GYRO_SAMPLE_MS / 2, avg);
        imu.cal.gx_b = avg.gx_dps;
        imu.cal.gy_b = avg.gy_dps;
        imu.cal.gz_b = avg.gz_dps;
        calLogf("[CAL] Gyro bias X=%+.4f Y=%+.4f Z=%+.4f dps",
                imu.cal.gx_b, imu.cal.gy_b, imu.cal.gz_b);
    }
    calLog("[CAL] ✓ GYRO done.");

    // ── Stage 2: Accel ───────────────────────────────────────
    g_calibState = CalibState::RUNNING_ACCEL;

    struct AccelPose {
        const char* physicalPose;
        uint8_t axis;
        int8_t sign;
    };

    const AccelPose poses[6] = {
        {"NOSE UP",        0, +1},
        {"NOSE DOWN",      0, -1},
        {"LEFT side UP",   1, +1},
        {"RIGHT side UP",  1, -1},
        {"FLAT top up",    2, +1},
        {"UPSIDE DOWN",    2, -1}
    };

    float plusVal[3]  = {0.0f, 0.0f, 0.0f};
    float minusVal[3] = {0.0f, 0.0f, 0.0f};
    bool gotPlus[3]   = {false, false, false};
    bool gotMinus[3]  = {false, false, false};

    calLog("[CAL] 2/3 ACCEL — 6 physical positions, flip SWC UP to confirm each.");

    for (int p = 0; p < 6; p++) {
        if (swcIsUp()) {
            calLog("[CAL] Flip SWC DOWN first...");
            waitSwcDown();
        }

        calLogf("[CAL] Pos %d/6: Put drone: %s — Flip SWC UP when steady",
                p + 1, poses[p].physicalPose);

        uint32_t t0 = millis();
        while (!swcIsUp()) {
            if (millis() - t0 > ACCEL_WAIT_MAX_MS) {
                calLog("[CAL] Timeout — position skipped");
                break;
            }
            delay(20);
        }

        if (!swcIsUp()) continue;

        silentWait(ACCEL_HOLD_MS);

        MPU_SensorData avg;
        imu.sampleAvg(ACCEL_HOLD_MS / 2, avg);

        float axisValue[3] = { avg.ax_g, avg.ay_g, avg.az_g };

        uint8_t axis = poses[p].axis;
        int8_t sign  = poses[p].sign;
        float value  = axisValue[axis];

        calLogf("[CAL] Got ax=%+.4f ay=%+.4f az=%+.4f g",
                avg.ax_g, avg.ay_g, avg.az_g);

        calLogf("[CAL] Routed %s to sensor %c%c = %+.4f g",
                poses[p].physicalPose,
                sign > 0 ? '+' : '-',
                axis == 0 ? 'X' : axis == 1 ? 'Y' : 'Z',
                value);

        if ((sign > 0 && value < 0.5f) || (sign < 0 && value > -0.5f)) {
            calLog("[CAL][WARN] Axis sign does not match expected pose. Check orientation.");
        }

        if (sign > 0) {
            plusVal[axis] = value;
            gotPlus[axis] = true;
        } else {
            minusVal[axis] = value;
            gotMinus[axis] = true;
        }

        waitSwcDown();
    }

    bool accelOk = true;
    for (int a = 0; a < 3; a++) {
        if (!gotPlus[a] || !gotMinus[a]) {
            accelOk = false;
        }
    }

    if (!accelOk) {
        calLog("[CAL][ERROR] Accel calibration incomplete — keeping old accel calibration.");
    } else {
        imu.cal.ax_b = (plusVal[0] + minusVal[0]) / 2.0f;
        imu.cal.ay_b = (plusVal[1] + minusVal[1]) / 2.0f;
        imu.cal.az_b = (plusVal[2] + minusVal[2]) / 2.0f;

        float hx = (plusVal[0] - minusVal[0]) / 2.0f;
        float hy = (plusVal[1] - minusVal[1]) / 2.0f;
        float hz = (plusVal[2] - minusVal[2]) / 2.0f;

        imu.cal.ax_s = fabsf(hx) > 0.01f ? 1.0f / hx : 1.0f;
        imu.cal.ay_s = fabsf(hy) > 0.01f ? 1.0f / hy : 1.0f;
        imu.cal.az_s = fabsf(hz) > 0.01f ? 1.0f / hz : 1.0f;

        calLogf("[CAL] Accel bias ax=%+.4f ay=%+.4f az=%+.4f g",
                imu.cal.ax_b, imu.cal.ay_b, imu.cal.az_b);

        calLogf("[CAL] Accel scale ax=%+.4f ay=%+.4f az=%+.4f",
                imu.cal.ax_s, imu.cal.ay_s, imu.cal.az_s);

        calLog("[CAL] ✓ ACCEL done.");
    }

    // ── Stage 3: Mag (skipped automatically if no AK8963) ────
    g_calibState = CalibState::RUNNING_MAG;
    if (imu.hasMag()) {
        calLogf("[CAL] 3/3 MAG — rotate figure-8 for %ds", MAG_DURATION_MS/1000);
        float xn=1e9f,yn=1e9f,zn=1e9f,xx=-1e9f,yx=-1e9f,zx=-1e9f;
        uint32_t end=millis()+MAG_DURATION_MS, lp=0;
        while (millis() < end) {
            MPU_SensorData s;
            if (imu.readScaled(s)) {
                if (fabsf(s.mx_uT)>0.1f || fabsf(s.my_uT)>0.1f || fabsf(s.mz_uT)>0.1f) {
                    if(s.mx_uT<xn)xn=s.mx_uT; if(s.mx_uT>xx)xx=s.mx_uT;
                    if(s.my_uT<yn)yn=s.my_uT; if(s.my_uT>yx)yx=s.my_uT;
                    if(s.mz_uT<zn)zn=s.mz_uT; if(s.mz_uT>zx)zx=s.mz_uT;
                }
            }
            if (millis()-lp >= 10000) {
                calLogf("[CAL] Mag — %lus remaining", (unsigned long)((end-millis())/1000));
                lp=millis();
            }
            delay(10);
        }
        imu.cal.mx_b=(xx+xn)/2.0f; imu.cal.my_b=(yx+yn)/2.0f; imu.cal.mz_b=(zx+zn)/2.0f;
        float sp=((xx-xn)+(yx-yn)+(zx-zn))/3.0f;
        imu.cal.mx_s=(xx-xn)>0.1f?sp/(xx-xn):1.0f;
        imu.cal.my_s=(yx-yn)>0.1f?sp/(yx-yn):1.0f;
        imu.cal.mz_s=(zx-zn)>0.1f?sp/(zx-zn):1.0f;
        calLog("[CAL] ✓ MAG done.");
    } else {
        calLog("[CAL] 3/3 MAG — SKIPPED (no AK8963 on this board).");
        calLog("[CAL] AHRS running 6-DOF mode — roll+pitch accurate, yaw drifts.");
    }

    // ── Save to NVS flash ─────────────────────────────────────
    g_calibState = CalibState::SAVING;
    imu.cal.valid = true;
    imu.saveCalibration();
    calLog("[CAL] ✓ Calibration COMPLETE — saved to NVS.");
    g_calibState = CalibState::DONE;
}

// ═════════════════════════════════════════════════════════════
//  TASKS
// ═════════════════════════════════════════════════════════════

// ─────────────────────────────────────────────────────────────
//  taskGPS — Core 0, priority 1, 50 Hz
// ─────────────────────────────────────────────────────────────
static void taskGPS(void* /*pv*/)
{
    const TickType_t period = pdMS_TO_TICKS(20);
    TickType_t lastWake = xTaskGetTickCount();
    uint32_t lastPrintMs = 0;

    for (;;) {
        gps.update();
        GPSData d = gps.get();
        if (xSemaphoreTake(g_flightMutex, pdMS_TO_TICKS(2)) == pdTRUE) {
            g_state.gps = d; xSemaphoreGive(g_flightMutex);
        }
        if (millis() - lastPrintMs >= 5000) {
            if (d.valid)
                DBG_PRINTF("[GPS] Fix  Lat=%.6f  Lon=%.6f  Alt=%.1fm  Sats=%d"
                              "  HDOP=%.1f  Speed=%.1fkm/h  UTC=%02d:%02d:%02d\n",
                              d.latitude, d.longitude, d.altitude_m,
                              d.satellites, d.hdop, d.speed_kmh,
                              d.hour, d.minute, d.second);
            else
                DBG_PRINTF("[GPS] No fix  Sats=%d  Sentences=%lu\n",
                              d.satellites, (unsigned long)d.sentenceCount);
            lastPrintMs = millis();
        }
        vTaskDelayUntil(&lastWake, period);
    }
}

// ─────────────────────────────────────────────────────────────
//  taskRC — Core 0, priority 3
//  Important: do NOT use vTaskDelayUntil(5 ms) here if the FreeRTOS tick
//  is coarse. On this build, one tick is behaving like ~40 ms, which can
//  starve the iBUS parser. Use micros() pacing + taskYIELD() instead.
// ─────────────────────────────────────────────────────────────
static void taskRC(void* /*pv*/)
{
    const TickType_t period = pdMS_TO_TICKS(5);
    TickType_t lastWake = xTaskGetTickCount();
    bool swdPrev = false;
    bool vrbEscPrev = false;


    for (;;) {
        rcReceiver.update();
        RCCommand cmd = rcReceiver.getCommand();

        if (cmd.swdHigh && !swdPrev) {
            if (cmd.mode == FlightMode::DISARMED) {
                calManager.request(CalibrationMode::IMU_ALL_GUIDED,CalibrationSource::RC);        
                calLog("[RC] Calibration Manager request — IMU All GUIDED.");
            } else if (cmd.mode != FlightMode::DISARMED) {
                calLog("[RC] SWD high while armed — ToF altitude hold requested.");
            }
        }
        swdPrev = cmd.swdHigh;
        // CH6 / VrB rising edge requests ESC calibration.
        // SWC still confirms the dangerous step inside CalibrationManager.
        const bool vrbEscHigh = cmd.valid &&
                                (cmd.raw[RC_CH_AUX5] >= ESC_CALIB_VRB_THRESHOLD);

        if (vrbEscHigh && !vrbEscPrev) {
            if (cmd.mode == FlightMode::DISARMED && cmd.throttle <= TUNE_THROTTLE_CUT) {
                calManager.request(CalibrationMode::ESC, CalibrationSource::RC);
                calLog("[RC] ESC calibration requested by VrB. Use SWC to confirm.");
            } else {
                calLog("[RC] ESC calibration rejected — disarm and set throttle low first.");
            }
        }

        vrbEscPrev = vrbEscHigh;

        // Optional safety cancel: lowering VrB cancels ESC calibration.
        CalibrationStatus rcCalStatus = calManager.status();
        if (rcCalStatus.active &&
            rcCalStatus.mode == CalibrationMode::ESC &&
            !vrbEscHigh) {
            calManager.cancel();
            calLog("[RC] ESC calibration cancelled — VrB lowered.");
        }
        // ── Per-second iBUS health: good rate vs checksum failures ──
        static uint32_t lastReportMs = 0;
        static uint32_t lastCsumFail = 0;
        uint32_t nowMs = millis();
        if (nowMs - lastReportMs >= 1000) {
            uint32_t fails    = rcReceiver.getChecksumFailCount();
            uint32_t failPerS = fails - lastCsumFail;
            lastCsumFail = fails;
            lastReportMs = nowMs;
            DBG_PRINTF("[iBUS] %.0f Hz good | %lu bad/s | %lu bad total\n",
                          rcReceiver.getFrameRate(),
                          (unsigned long)failPerS,
                          (unsigned long)fails);
        }
        vTaskDelayUntil(&lastWake, period);
    }
}

// throttle smoothening
static float throttleExpo(float x, float expo)
{
    x = constrain(x, 0.0f, 1.0f);
    expo = constrain(expo, 0.0f, 1.0f);
    return expo * x * x * x +(1.0f - expo) * x;
}

static float smoothStep01(float x)
{
    x = constrain(x, 0.0f, 1.0f);
    return x * x * (3.0f - 2.0f * x);
}

static float wrapDeg180(float a)
{
    while (a >  180.0f) a -= 360.0f;
    while (a < -180.0f) a += 360.0f;
    return a;
}

static void computeControlAttitude(const AttitudeEstimate& att,
                                   float& rollCtrl,
                                   float& pitchCtrl,
                                   float& yawCtrl)
{
    rollCtrl  = att.roll_deg  - g_levelRollOffsetDeg;
    pitchCtrl = att.pitch_deg - g_levelPitchOffsetDeg;
    yawCtrl   = wrapDeg180(att.yaw_deg - g_levelYawOffsetDeg);
}

// First-order gyro/setpoint low-pass (one state per axis)
struct LPF {
    float y = 0.0f;
    bool initialized = false;

    float apply(float x, float dt, float fc) {
        if (dt <= 0.0f || fc <= 0.0f) return x;
        if (!initialized) {
            y = x;
            initialized = true;
            return y;
        }
        float rc = 1.0f / (2.0f * 3.14159265f * fc);
        float a  = dt / (dt + rc);
        y += a * (x - y);
        return y;
    }

    void reset() {
        y = 0.0f;
        initialized = false;
    }
};
static LPF lpfGx, lpfGy, lpfGz, lpfSpRoll, lpfSpPitch, lpfSpYaw;

static float g_yawSetpoint   = 0.0f;
static bool  g_yawHoldActive = false;

// Diagnostic-only attitude estimates published to telemetry.
// These are not used for control; they help compare AHRS fusion vs raw accel
// tilt and gyro-only integration on the ground station.
static float g_gyroRollDeg  = 0.0f;
static float g_gyroPitchDeg = 0.0f;
static float g_gyroYawDeg   = 0.0f;
static bool  g_gyroAngleInit = false;

// Tracks whether we have already commanded the ESC outputs off.
// motorOff() is intentionally NOT called every 400 Hz cycle because the
// current MotorControl implementation appears to block for ~40 ms.
static bool  g_motorOutputsActive = false;

static void updateDynamicNotchFromFFT()
{
    if (!TUNE_DYNAMIC_NOTCH_ENABLE) return;

    static uint32_t lastUpdateMs = 0;
    uint32_t nowMs = millis();

    if (nowMs - lastUpdateMs < DYN_NOTCH_UPDATE_MS) {
        return;
    }

    lastUpdateMs = nowMs;

    // Snapshot flight state inside this function.
    // This avoids Arduino prototype issues with FlightState in the function argument.
    FlightState s;
    if (xSemaphoreTake(g_flightMutex, pdMS_TO_TICKS(5)) == pdTRUE) {
        s = g_state;
        xSemaphoreGive(g_flightMutex);
    } else {
        return;
    }

    // Do not learn while disarmed, motors off, failsafe, or low throttle.
    if (!s.armed ||
        !g_motorOutputsActive ||
        !s.rc.valid ||
        s.rc.throttle < DYN_NOTCH_MIN_THROTTLE) {

        if (LOG_DYNAMIC_NOTCH_DEBUG) {
            static uint32_t lastGatePrintMs = 0;
            if (nowMs - lastGatePrintMs >= 1000) {
                lastGatePrintMs = nowMs;

                DBG_PRINTF("[DYN_NOTCH_GATE] blocked armed=%d motorOut=%d rcValid=%d throttle=%.3f minThrottle=%.3f\n",
                              s.armed ? 1 : 0,
                              g_motorOutputsActive ? 1 : 0,
                              s.rc.valid ? 1 : 0,
                              s.rc.throttle,
                              DYN_NOTCH_MIN_THROTTLE);
            }
        }

        return;
    }

    bool notchEnabled = false;
    float currentHz = TUNE_NOTCH_FREQ_HZ;

    if (xSemaphoreTake(g_tuneMutex, pdMS_TO_TICKS(5)) == pdTRUE) {
        notchEnabled = g_tuning.notch_enable;
        currentHz = g_tuning.notch_freq_hz;
        xSemaphoreGive(g_tuneMutex);
    } else {
        return;
    }

    if (!notchEnabled) {
        return;
    }

    float peakHz = 0.0f;
    float peakScore = 0.0f;
    uint32_t seq = 0;

    bool ok = spectrumAnalyzer.findGyroPeak(DYN_NOTCH_MIN_HZ,
                                            DYN_NOTCH_MAX_HZ,
                                            DYN_NOTCH_MIN_SCORE,
                                            peakHz,
                                            peakScore,
                                            seq);

    if (!ok) {
        if (LOG_DYNAMIC_NOTCH_DEBUG) {
            static uint32_t lastNoPeakPrintMs = 0;
            if (nowMs - lastNoPeakPrintMs >= 1000) {
                lastNoPeakPrintMs = nowMs;

                DBG_PRINTF("[DYN_NOTCH_NO_PEAK] current=%.1fHz min=%.1f max=%.1f minScore=%.2f seq=%lu\n",
                              currentHz,
                              DYN_NOTCH_MIN_HZ,
                              DYN_NOTCH_MAX_HZ,
                              DYN_NOTCH_MIN_SCORE,
                              (unsigned long)seq);
            }
        }

        return;
    }

    // Smooth toward the detected FFT peak.
    float targetHz = currentHz + DYN_NOTCH_ALPHA * (peakHz - currentHz);

    // Limit movement per update so the notch does not chase noise.
    float stepHz = targetHz - currentHz;
    stepHz = constrain(stepHz, -DYN_NOTCH_MAX_STEP_HZ, DYN_NOTCH_MAX_STEP_HZ);

    float requestedHz = currentHz + stepHz;
    requestedHz = constrain(requestedHz, DYN_NOTCH_MIN_HZ, DYN_NOTCH_MAX_HZ);

    // Avoid tiny reconfigurations.
    if (fabsf(requestedHz - currentHz) < 0.5f) {
        return;
    }

    if (xSemaphoreTake(g_tuneMutex, pdMS_TO_TICKS(5)) == pdTRUE) {
        g_tuning.notch_freq_hz = requestedHz;
        g_tuning.dirty = true;   // taskControl applies notch safely
        xSemaphoreGive(g_tuneMutex);
    }

    if (LOG_DYNAMIC_NOTCH_DEBUG) {
        DBG_PRINTF("[DYN_NOTCH] peak=%.1fHz score=%.3f current=%.1fHz -> request=%.1fHz seq=%lu\n",
                      peakHz,
                      peakScore,
                      currentHz,
                      requestedHz,
                      (unsigned long)seq);
    }
}

// ═════════════════════════════════════════════════════════════
//  HIGH-SPEED ON-BOARD FLIGHT LOG  (Test 7.1 / 7.3 / 7.4 capture)
//
//  Expanded debug row, logged at 100 Hz (every 4th 400 Hz cycle).
//  Workflow: POST /flightlog/reset  →  arm + fly  →  disarm  →
//            GET /flightlog/csv (freezes the buffer, streams it out).
//
//  FLIGHT_LOG_SIZE=300 → ~3.0 s at 100 Hz with extended fields. Raise only if
//  free heap allows (check the 'I'-style resource report first).
//
//  Concurrency: writer (taskControl, Core 1) and the freeze flag
//  share one portMUX spinlock. GET freezes logging first, so the
//  WiFi task (Core 0) reads a static buffer with no further writes
//  — no second copy buffer needed, and rows are streamed (chunked)
//  so no giant CSV String is ever built in heap.
// ═════════════════════════════════════════════════════════════

static void resetFlightLog() {
    flightLogger.reset();
}

static uint16_t flightLogCount() {
    return flightLogger.countAndFreeze();
}

static String flightLogHeader() {
    return flightLogger.csvHeader();
}

static String flightLogRowCsv(uint16_t i) {
    return flightLogger.csvRow(i);
}




// ─────────────────────────────────────────────────────────────
//  taskControl — Core 1, priority 5, 400 Hz  (2.5 ms period)
// ─────────────────────────────────────────────────────────────
// ============================================================================
// BLOCK B — Replace your taskControl() with this version
// ============================================================================

static void taskControl(void* /*pv*/)
{
    const uint32_t TARGET_US = TIMING_TARGET_US;   // 2500 us = 400 Hz

    // The loop is released by esp_timer every 2500 us.
    // Do not use vTaskDelay(1) here, and do not busy-wait: both caused
    // either 40 ms periods or watchdog resets on this build.
    uint32_t lastUs = 0;
    uint32_t lastFusedTofTimestampMs = 0;
    bool altitudeHoldEngaged = false;
    float altitudeHoldSetpointM = 0.0f;
    float altitudeHoldErrorM = 0.0f;
    float altitudeHoldTrim = 0.0f;

    pidRateRoll.reset();  pidRatePitch.reset();  pidRateYaw.reset();
    pidAngleRoll.reset(); pidAnglePitch.reset();
    pidAngleYaw.reset();
    attitudeEKF.reset();
    g_yawHoldActive = false;

    for (;;) {
        if (g_tuning.dirty) applyTuningToObjects();

        if (g_calibState == CalibState::REQUESTED) {
            if (g_motorOutputsActive) {
                motorsOff();
                g_motorOutputsActive = false;
            }
            pidRateRoll.reset();  pidRatePitch.reset();  pidRateYaw.reset();
            pidAngleRoll.reset(); pidAnglePitch.reset();
            pidAngleYaw.reset();
            attitudeEKF.reset();
            lastFusedTofTimestampMs = 0;
            altitudeHoldEngaged = false;
            altitudeHoldSetpointM = 0.0f;
            altitudeHoldErrorM = 0.0f;
            altitudeHoldTrim = 0.0f;
            g_yawHoldActive = false;
            runAutonomousCalibration();
            g_calibState = CalibState::IDLE;
            ulTaskNotifyTake(pdTRUE, 0);  // discard stale timer releases
            lastUs = 0;
            continue;
        }

        // Block until the high-resolution 400 Hz timer releases this task.
        // pdTRUE clears any accumulated notifications, so if a previous cycle
        // ran long we skip stale releases instead of trying to catch up.
        uint32_t releases = ulTaskNotifyTake(pdTRUE, portMAX_DELAY);
        if (releases > 1) {
            g_execTiming.missedTimerReleases += (releases - 1);
        }

        uint32_t nowUs = micros();
        uint32_t periodUs = (lastUs == 0) ? TARGET_US : (nowUs - lastUs);
        lastUs = nowUs;

        // Execution timer starts AFTER the period wait.
        // This measures actual control work, not intentional wait time.
        uint32_t execStartUs = micros();

        float dt = (float)periodUs * 1e-6f;
        if (dt <= 0.0f || dt > 0.05f) {
            dt = (float)TARGET_US * 1e-6f;
            periodUs = TARGET_US;
        }

        batteryMonitor.update(millis());
        const BatteryStatus bat = batteryMonitor.status();
        const float batteryVoltageForRpm = bat.valid ? bat.batteryVoltage_v : BATTERY_NOMINAL_V;

        // ── Welford timing accumulator (Test 7.1) ────────────
        if (xSemaphoreTake(g_timingMutex, 0) == pdTRUE) {
            uint32_t n = ++g_timing.count;
            double delta  = (double)periodUs - g_timing.wMean;
            g_timing.wMean += delta / n;
            g_timing.wM2   += delta * ((double)periodUs - g_timing.wMean);

            uint32_t jit = (periodUs >= TARGET_US)
                         ? (periodUs - TARGET_US)
                         : (TARGET_US - periodUs);

            double jdelta  = (double)jit - g_timing.jMean;
            g_timing.jMean += jdelta / n;
            g_timing.jM2   += jdelta * ((double)jit - g_timing.jMean);

            if (jit > g_timing.jitterMax)  g_timing.jitterMax = jit;
            if (jit > JITTER_VIOLATION_US) g_timing.jitterViolations++;

            g_timing.buf[g_timing.bufHead] = (uint16_t)min(periodUs, (uint32_t)65535);
            g_timing.bufHead = (g_timing.bufHead + 1) % TIMING_BUF_SIZE;
            if (g_timing.bufHead == 0) g_timing.bufFull = true;

            xSemaphoreGive(g_timingMutex);
        }

        // ── Calibration active: keep motors off and skip flight control ──
        if (calManager.shouldBlockFlight()) {
            if (!calManager.ownsMotors() && g_motorOutputsActive) {
                motorsOff();
                g_motorOutputsActive = false;
            }

            pidRateRoll.reset();
            pidRatePitch.reset();
            pidRateYaw.reset();

            pidAngleRoll.reset();
            pidAnglePitch.reset();
            pidAngleYaw.reset();

            g_yawHoldActive = false;
            altitudeHoldEngaged = false;
            altitudeHoldSetpointM = 0.0f;
            altitudeHoldErrorM = 0.0f;
            altitudeHoldTrim = 0.0f;

            updateExecTimingAndPrint(0, 0, periodUs, TARGET_US);

            continue;
        }

        // ── IMU read + EKF AHRS ───────────────────────────────
        MPU_SensorData s;
        AttitudeEstimate   att;
        uint32_t phaseStartUs = micros();
        bool imuOk = imu.readScaled(s);
        g_execTiming.lastImuUs = micros() - phaseStartUs;

        float gxf = 0, gyf = 0, gzf = 0;
        float filtAx = 0.0f, filtAy = 0.0f, filtAz = 0.0f;
        float accelRollDeg = 0.0f, accelPitchDeg = 0.0f;
        float rollAngleErrDeg = 0.0f, pitchAngleErrDeg = 0.0f;
        float tofControlDistanceM = 0.0f;
        uint32_t tofControlTimestampMs = 0;
        bool tofControlValid = false;
        if (xSemaphoreTake(g_flightMutex, 0) == pdTRUE) {
            tofControlDistanceM = g_state.tofDistance_m;
            tofControlTimestampMs = g_state.tofLastUpdate_ms;
            tofControlValid = g_state.tofValid;
            xSemaphoreGive(g_flightMutex);
        }
        PositionVelocityEstimate ekfPv;
        bool tofEkfVelocityAccepted = false;
        if (imuOk) {
            if (g_notchResetPending) {
                notchAx.reset(s.ax_g);
                notchAy.reset(s.ay_g);
                notchAz.reset(s.az_g);
                notchGx.reset(s.gx_dps);
                notchGy.reset(s.gy_dps);
                notchGz.reset(s.gz_dps);
                g_notchResetPending = false;
            }

            // Apply tunable motor-vibration notch before EKF and before PID.
            // Keep original `s` for raw telemetry/logging; use `sf` for control.
            MPU_SensorData sf = s;
            sf.ax_g   = notchAx.apply(s.ax_g);
            sf.ay_g   = notchAy.apply(s.ay_g);
            sf.az_g   = notchAz.apply(s.az_g);
            sf.gx_dps = notchGx.apply(s.gx_dps);
            sf.gy_dps = notchGy.apply(s.gy_dps);
            sf.gz_dps = notchGz.apply(s.gz_dps);
            filtAx = sf.ax_g; filtAy = sf.ay_g; filtAz = sf.az_g;

            // Feed onboard vibration spectrum with RAW pre-notch IMU data.
            // This lets you see the vibration peak even when the notch is enabled.
            spectrumAnalyzer.push(s.ax_g, s.ay_g, s.az_g,
                                  s.gx_dps, s.gy_dps, s.gz_dps,
                                  g_motorOutputsActive);

            if (LOG_DYNAMIC_NOTCH_DEBUG) {
                static uint32_t dynFftPushCount = 0;
                static uint32_t lastDynFftInputPrintMs = 0;

                dynFftPushCount++;

                uint32_t nowFftInputMs = millis();
                if (nowFftInputMs - lastDynFftInputPrintMs >= 1000) {
                    lastDynFftInputPrintMs = nowFftInputMs;

                    float gyroMag =
                        sqrtf(s.gx_dps * s.gx_dps +
                              s.gy_dps * s.gy_dps +
                              s.gz_dps * s.gz_dps);

                    float accelVib =
                        fabsf(sqrtf(s.ax_g * s.ax_g +
                                    s.ay_g * s.ay_g +
                                    s.az_g * s.az_g) - 1.0f);

                    DBG_PRINTF("[DYN_FFT_INPUT] pushes=%lu motorOut=%d gyroMag=%.3f dps accelVib=%.4f g\n",
                                  (unsigned long)dynFftPushCount,
                                  g_motorOutputsActive ? 1 : 0,
                                  gyroMag,
                                  accelVib);
                    DBG_PRINTF("[DYN_NOTCH_HOOK] motorOut=%d notchEnable=%d notchHz=%.1f Q=%.1f\n",
                                  g_motorOutputsActive ? 1 : 0,
                                  g_tuning.notch_enable ? 1 : 0,
                                  g_tuning.notch_freq_hz,
                                  g_tuning.notch_q);
                }
            }
            AHRSInput ekfIn;
            ekfIn.ax_g = sf.ax_g; ekfIn.ay_g = sf.ay_g; ekfIn.az_g = sf.az_g;
            ekfIn.gx_dps = sf.gx_dps; ekfIn.gy_dps = sf.gy_dps; ekfIn.gz_dps = sf.gz_dps;
            ekfIn.mx_uT = s.mx_uT; ekfIn.my_uT = s.my_uT; ekfIn.mz_uT = s.mz_uT;
            ekfIn.magValid = imu.isMagConnected();

            // Runtime-selectable attitude estimator.
            // 0 = EKF, 1 = Mahony, 2 = Madgwick.
            static uint8_t lastAhrsMode = 255;
            uint8_t ahrsMode = 0;
            if (xSemaphoreTake(g_tuneMutex, 0) == pdTRUE) {
                ahrsMode = (uint8_t)constrain((int)roundf(g_tuning.ahrs_filter_mode), 0, 2);
                xSemaphoreGive(g_tuneMutex);
            }
            if (ahrsMode != lastAhrsMode) {
                attitudeEKF.reset();
                madgwickAHRS.reset();
                lastFusedTofTimestampMs = 0;
                altitudeHoldEngaged = false;
                lastAhrsMode = ahrsMode;
            }
            g_ahrsFilterModeActive = ahrsMode;

            uint32_t ahrsStartUs = micros();
            if (ahrsMode == 1) {
                mahony.update(ekfIn, dt, att);
            } else if (ahrsMode == 2) {
                AttitudeEstimate madOut;
                madgwickAHRS.update(ekfIn, dt, madOut);
                att.roll_deg = madOut.roll_deg; att.pitch_deg = madOut.pitch_deg; att.yaw_deg = madOut.yaw_deg;
                att.q0 = madOut.q0; att.q1 = madOut.q1; att.q2 = madOut.q2; att.q3 = madOut.q3;
            } else {
                AttitudeEstimate ekfOut;
                attitudeEKF.update(ekfIn, dt, ekfOut);
                if (tofControlValid &&
                    tofControlTimestampMs != 0 &&
                    tofControlTimestampMs != lastFusedTofTimestampMs) {
                    attitudeEKF.updateTofMeasurement(tofControlDistanceM,
                                                     tofControlTimestampMs);
                    lastFusedTofTimestampMs = tofControlTimestampMs;
                }
                ekfPv = attitudeEKF.positionVelocity();
                tofEkfVelocityAccepted = attitudeEKF.lastTofVelocityAccepted();
                att.roll_deg = ekfOut.roll_deg; att.pitch_deg = ekfOut.pitch_deg; att.yaw_deg = ekfOut.yaw_deg;
                att.q0 = ekfOut.q0; att.q1 = ekfOut.q1; att.q2 = ekfOut.q2; att.q3 = ekfOut.q3;
            }
            g_execTiming.lastAhrsUs = micros() - ahrsStartUs;

            gxf = lpfGx.apply(sf.gx_dps, dt, GYRO_LPF_HZ);
            gyf = lpfGy.apply(sf.gy_dps, dt, GYRO_LPF_HZ);
            gzf = lpfGz.apply(sf.gz_dps, dt, GYRO_LPF_HZ);

            // Accel-only tilt estimate. This is noisy under vibration/acceleration,
            // but useful as an independent reference for AHRS roll/pitch.
            const float RAD_TO_DEG_LOCAL = 57.29577951308232f;
            accelRollDeg  = atan2f(s.ay_g, s.az_g) * RAD_TO_DEG_LOCAL;
            accelPitchDeg = atan2f(-s.ax_g, sqrtf(s.ay_g*s.ay_g + s.az_g*s.az_g)) * RAD_TO_DEG_LOCAL;

            // Gyro-only integration. This will drift; that drift is exactly what
            // the AHRS correction is meant to control.
            if (!g_gyroAngleInit) {
                g_gyroRollDeg  = att.roll_deg;
                g_gyroPitchDeg = att.pitch_deg;
                g_gyroYawDeg   = att.yaw_deg;
                g_gyroAngleInit = true;
            } else {
                g_gyroRollDeg  += gxf * dt;
                g_gyroPitchDeg += gyf * dt;
                g_gyroYawDeg   += gzf * dt;
                while (g_gyroYawDeg >= 360.0f) g_gyroYawDeg -= 360.0f;
                while (g_gyroYawDeg <    0.0f) g_gyroYawDeg += 360.0f;
            }

            rollAngleErrDeg  = att.roll_deg  - accelRollDeg;
            pitchAngleErrDeg = att.pitch_deg - accelPitchDeg;
        }
        const uint32_t tofEkfAgeMs = (lastFusedTofTimestampMs != 0)
                                   ? (millis() - lastFusedTofTimestampMs)
                                   : UINT32_MAX;

        phaseStartUs = micros();
        RCCommand cmd = rcReceiver.getCommand();
        updateControlTransitionCounters(cmd);
        g_execTiming.lastRcUs = micros() - phaseStartUs;
 
        float rollCtrlDeg = 0.0f, pitchCtrlDeg = 0.0f, yawCtrlDeg = 0.0f;
        if (imuOk) computeControlAttitude(att, rollCtrlDeg, pitchCtrlDeg, yawCtrlDeg);

        // Level-zero capture: DISARMED + SWB/ACRO high.
        // Uses raw CH8 because cmd.mode is DISARMED while disarmed, even if SWB is high.
        static bool levelZeroWasHigh = false;
        static bool levelZeroCapturing = false;
        static uint16_t levelZeroCount = 0;
        static uint32_t levelZeroStartMs = 0;
        static double levelRollSum = 0.0, levelPitchSum = 0.0, levelYawSum = 0.0;
        const bool swbAcroHigh = (cmd.valid && cmd.raw[RC_CH_AUX2] >= LEVEL_ZERO_SWB_THRESHOLD);
        const bool canCaptureLevelZero = (cmd.mode == FlightMode::DISARMED && imuOk && swbAcroHigh);

        if (!swbAcroHigh) {
            levelZeroWasHigh = false;
            levelZeroCapturing = false;
            levelZeroCount = 0;
            levelZeroStartMs = 0;
            levelRollSum = levelPitchSum = levelYawSum = 0.0;
        } else if (canCaptureLevelZero && !levelZeroWasHigh) {
            if (!levelZeroCapturing) {
                levelZeroCapturing = true;
                levelZeroCount = 0;
                levelZeroStartMs = millis();
                levelRollSum = levelPitchSum = levelYawSum = 0.0;
                DBG_PRINTLN(F("[LEVEL] Capturing software zero — keep drone still..."));
                calLog("[LEVEL] Capturing software zero — keep drone still...");
            }

            levelRollSum  += att.roll_deg;
            levelPitchSum += att.pitch_deg;
            levelYawSum   += att.yaw_deg;
            levelZeroCount++;

            if ((millis() - levelZeroStartMs) >= LEVEL_ZERO_SAMPLE_MS && levelZeroCount > 0) {
                g_levelRollOffsetDeg  = (float)(levelRollSum  / (double)levelZeroCount);
                g_levelPitchOffsetDeg = (float)(levelPitchSum / (double)levelZeroCount);
                g_levelYawOffsetDeg   = (float)(levelYawSum   / (double)levelZeroCount);
                computeControlAttitude(att, rollCtrlDeg, pitchCtrlDeg, yawCtrlDeg);

                DBG_PRINTF("[LEVEL] Zero saved: rollOff=%+.2f pitchOff=%+.2f yawOff=%+.2f deg\n",
                              g_levelRollOffsetDeg, g_levelPitchOffsetDeg, g_levelYawOffsetDeg);
                calLogf("[LEVEL] Zero saved: R=%+.2f P=%+.2f Y=%+.2f deg",
                        g_levelRollOffsetDeg, g_levelPitchOffsetDeg, g_levelYawOffsetDeg);

                levelZeroWasHigh = true;
                levelZeroCapturing = false;
                levelZeroCount = 0;
                levelZeroStartMs = 0;
                levelRollSum = levelPitchSum = levelYawSum = 0.0;
            }
        }

        // ── DISARMED / FAILSAFE ───────────────────────────────
        if (cmd.mode == FlightMode::DISARMED || cmd.mode == FlightMode::FAILSAFE) {
            phaseStartUs = micros();
            if (g_motorOutputsActive) {
                // One-shot stop only. Repeating motorOff() at 400 Hz was measured
                // as ~40 ms in your log, which destroys the loop timing.
                motorsOff();
                g_motorOutputsActive = false;
            }
            g_execTiming.lastMotorUs = micros() - phaseStartUs;
            uint32_t controlDoneUs = micros();

            pidRateRoll.reset();  pidRatePitch.reset();  pidRateYaw.reset();
            pidAngleRoll.reset(); pidAnglePitch.reset();
            lpfGx.reset(); lpfGy.reset(); lpfGz.reset();
            notchAx.reset(); notchAy.reset(); notchAz.reset();
            notchGx.reset(); notchGy.reset(); notchGz.reset();
            lpfSpRoll.reset(); lpfSpPitch.reset(); lpfSpYaw.reset();
            pidAngleYaw.reset();
            g_yawHoldActive = false;
            altitudeHoldEngaged = false;
            altitudeHoldSetpointM = 0.0f;
            altitudeHoldErrorM = 0.0f;
            altitudeHoldTrim = 0.0f;

            phaseStartUs = micros();
            if (xSemaphoreTake(g_flightMutex, 0) == pdTRUE) {
                g_state.armed   = false;
                g_state.motorFL = g_state.motorFR = g_state.motorRL = g_state.motorRR = 0;
                g_state.motorFLPreSat = g_state.motorFRPreSat = g_state.motorRLPreSat = g_state.motorRRPreSat = 0;
                g_state.batteryVoltage_v = batteryVoltageForRpm;
                g_state.batteryAdcVoltage_v = bat.adcVoltage_v;
                g_state.batteryCellVoltage_v = bat.cellVoltage_v;
                g_state.batteryPercent = bat.percent;
                g_state.batteryValid = bat.valid;
                g_state.batteryLow = bat.low;
                g_state.batteryCritical = bat.critical;
                g_state.pidRollOut = g_state.pidPitchOut = g_state.pidYawOut = 0;
                g_state.loopPeriod_us = periodUs;
                g_state.loopJitter_us = (int16_t)constrain((int32_t)periodUs - (int32_t)TARGET_US, -32768, 32767);
                g_state.imuRead_us = g_execTiming.lastImuUs;
                g_state.rcRead_us = g_execTiming.lastRcUs;
                g_state.ahrsUpdate_us = g_execTiming.lastAhrsUs;
                g_state.controlUpdate_us = controlDoneUs - execStartUs;
                g_state.motorWrite_us = g_execTiming.lastMotorUs;
                g_state.wifiService_us = g_lastWifiServiceUs;
                g_state.onboardLogWrite_us = g_execTiming.lastLogUs;
                g_state.missedLoopCount = g_execTiming.missedTimerReleases;
                g_state.rc      = cmd;
                g_state.angleModeActive = false;
                g_state.acroModeActive = false;
                g_state.modeSwitchRaw_us = cmd.raw[RC_CH_AUX2];
                g_state.armSwitchRaw_us = cmd.raw[RC_CH_FLIGHTMODE];
                g_state.auxTune1Raw_us = cmd.raw[RC_CH_AUX1];
                g_state.auxTune2Raw_us = cmd.raw[RC_CH_AUX5];
                g_state.rcFailsafeCount = rcReceiver.getFailsafeCount();
                g_state.angleLoopEnabled = false;
                g_state.rateLoopEnabled = false;
                g_state.actualRollRate_dps = imuOk ? gxf : 0.0f;
                g_state.actualPitchRate_dps = imuOk ? gyf : 0.0f;
                g_state.actualYawRate_dps = imuOk ? gzf : 0.0f;
                g_state.angleRollP = pidAngleRoll.lastP;
                g_state.angleRollI = pidAngleRoll.lastI;
                g_state.angleRollD = pidAngleRoll.lastD;
                g_state.anglePitchP = pidAnglePitch.lastP;
                g_state.anglePitchI = pidAnglePitch.lastI;
                g_state.anglePitchD = pidAnglePitch.lastD;
                g_state.rateRollP = pidRateRoll.lastP;
                g_state.rateRollI = pidRateRoll.lastI;
                g_state.rateRollD = pidRateRoll.lastD;
                g_state.ratePitchP = pidRatePitch.lastP;
                g_state.ratePitchI = pidRatePitch.lastI;
                g_state.ratePitchD = pidRatePitch.lastD;
                g_state.rateYawP = pidRateYaw.lastP;
                g_state.rateYawI = pidRateYaw.lastI;
                g_state.rateYawD = pidRateYaw.lastD;
                g_state.angleRollIterm = pidAngleRoll.integral;
                g_state.anglePitchIterm = pidAnglePitch.integral;
                g_state.pidResetCount = g_pidResetCount;
                g_state.modeTransitionCount = g_modeTransitionCount;
                g_state.lastModeChange_ms = g_lastModeChangeMs;
                g_state.armingTransitionCount = g_armingTransitionCount;
                g_state.lastArmChange_ms = g_lastArmChangeMs;
                g_state.throttleLow = true;
                g_state.controlAuthorityRemaining = 0.0f;
                g_state.rollOutputLimited = false;
                g_state.pitchOutputLimited = false;
                g_state.yawOutputLimited = false;
                g_state.rateOutputLimited = false;
                g_state.cmdRpmFL = g_state.cmdRpmFR = g_state.cmdRpmRL = g_state.cmdRpmRR = 0.0f;
                g_state.actualRpmFL = g_state.actualRpmFR = g_state.actualRpmRL = g_state.actualRpmRR = 0.0f;
                g_state.rpmActualValid = false;
                g_state.ekfPosZ_m = ekfPv.valid ? ekfPv.posZ_m : 0.0f;
                g_state.ekfVelZ_mps = ekfPv.valid ? ekfPv.velZ_mps : 0.0f;
                g_state.tofEkfLastFused_ms = lastFusedTofTimestampMs;
                g_state.tofEkfAge_ms = tofEkfAgeMs;
                g_state.tofEkfVelocityAccepted = tofEkfVelocityAccepted;
                g_state.altitudeHoldRequested = cmd.valid && cmd.swdHigh;
                g_state.altitudeHoldReady = false;
                g_state.altitudeHoldActive = false;
                g_state.altitudeHoldSetpoint_m = altitudeHoldSetpointM;
                g_state.altitudeHoldError_m = 0.0f;
                g_state.altitudeHoldThrottleTrim = 0.0f;
                if (imuOk) {
                    g_state.roll_deg = att.roll_deg;  g_state.pitch_deg = att.pitch_deg;
                    g_state.yaw_deg  = att.yaw_deg;
                    g_state.q0 = att.q0; g_state.q1 = att.q1; g_state.q2 = att.q2; g_state.q3 = att.q3;
                    g_state.imuValid = imuOk;
                    g_state.magValid = imu.isMagConnected();
                    g_state.ahrsFilterMode = g_ahrsFilterModeActive;
                    g_state.roll_ctrl_deg = rollCtrlDeg;
                    g_state.pitch_ctrl_deg = pitchCtrlDeg;
                    g_state.yaw_ctrl_deg = yawCtrlDeg;
                    g_state.roll_offset_deg = g_levelRollOffsetDeg;
                    g_state.pitch_offset_deg = g_levelPitchOffsetDeg;
                    g_state.yaw_offset_deg = g_levelYawOffsetDeg;
                    g_state.ax_g=s.ax_g; g_state.ay_g=s.ay_g; g_state.az_g=s.az_g;
                    g_state.gx_dps=s.gx_dps; g_state.gy_dps=s.gy_dps; g_state.gz_dps=s.gz_dps;
                    g_state.mx_uT=s.mx_uT; g_state.my_uT=s.my_uT; g_state.mz_uT=s.mz_uT;
                    g_state.imuTemp_c=s.temp_c;
                    g_state.accelRoll_deg = accelRollDeg;
                    g_state.accelPitch_deg = accelPitchDeg;
                    g_state.gyroRoll_deg = g_gyroRollDeg;
                    g_state.gyroPitch_deg = g_gyroPitchDeg;
                    g_state.gyroYaw_deg = g_gyroYawDeg;
                    g_state.rollAngleError_deg = rollAngleErrDeg;
                    g_state.pitchAngleError_deg = pitchAngleErrDeg;
                    g_state.loopCount++;
                }
                xSemaphoreGive(g_flightMutex);
            }
            g_execTiming.lastStateUs = micros() - phaseStartUs;

            uint32_t fullDoneUs = micros();
            updateExecTimingAndPrint(controlDoneUs - execStartUs,
                                     fullDoneUs - execStartUs,
                                     periodUs,
                                     TARGET_US);
            continue;
        }

        // ── ARMED — cascaded PID ──────────────────────────────
        float roll  = imuOk ? rollCtrlDeg  : 0.0f;
        float pitch = imuOk ? pitchCtrlDeg : 0.0f;
        float gx    = imuOk ? gxf : 0.0f;
        float gy    = imuOk ? gyf : 0.0f;
        float gz    = imuOk ? gzf : 0.0f;

        TuningState tune;
        if (xSemaphoreTake(g_tuneMutex, 0) == pdTRUE) {
            tune = g_tuning;
            xSemaphoreGive(g_tuneMutex);
        } else {
            // Extremely rare: keep flying with compile-time safe defaults for this cycle.
            memset(&tune, 0, sizeof(tune));
            tune.max_angle_deg              = TUNE_MAX_ANGLE_DEG;
            tune.max_rate_dps               = TUNE_MAX_RATE_DPS;
            tune.max_pitch_rate_dps         = TUNE_MAX_RATE_DPS;
            tune.roll_output_limit          = TUNE_ROLL_OUTPUT_LIMIT;
            tune.pitch_output_limit         = TUNE_PITCH_OUTPUT_LIMIT;
            tune.yaw_output_limit           = TUNE_YAW_OUTPUT_LIMIT;
            tune.throttle_expo              = TUNE_THROTTLE_EXPO;
            tune.throttle_up_rate_per_sec   = TUNE_THROTTLE_UP_RATE_PER_SEC;
            tune.throttle_down_rate_per_sec = TUNE_THROTTLE_DOWN_RATE_PER_SEC;
            tune.motor_idle                 = TUNE_MOTOR_IDLE;
            tune.motor_max                  = TUNE_MOTOR_MAX;
            tune.throttle_cut               = TUNE_THROTTLE_CUT;
            tune.idle_ramp_end              = TUNE_IDLE_RAMP_END;
            tune.yaw_deadband               = TUNE_YAW_DEADBAND;
            tune.yaw_max_rate_dps           = TUNE_YAW_MAX_RATE_DPS;
            tune.pid_roll_ff                = TUNE_RATE_ROLL_FF;
            tune.pid_pitch_ff               = TUNE_RATE_PITCH_FF;
            tune.pid_yaw_ff                 = TUNE_RATE_YAW_FF;
            tune.pid_roll_d_lpf_hz          = TUNE_RATE_ROLL_D_LPF_HZ;
            tune.pid_pitch_d_lpf_hz         = TUNE_RATE_PITCH_D_LPF_HZ;
            tune.pid_yaw_d_lpf_hz           = TUNE_RATE_YAW_D_LPF_HZ;
            tune.ahrs_filter_mode           = TUNE_AHRS_FILTER_MODE;
            tune.madgwick_beta              = TUNE_MADGWICK_BETA;
            tune.notch_enable               = TUNE_NOTCH_ENABLE;
            tune.notch_freq_hz              = TUNE_NOTCH_FREQ_HZ;
            tune.notch_q                    = TUNE_NOTCH_Q;
            tune.ekf_angle_q                = TUNE_EKF_ANGLE_Q;
            tune.ekf_bias_q                 = TUNE_EKF_BIAS_Q;
            tune.ekf_accel_r                = TUNE_EKF_ACCEL_R;
            tune.ekf_mag_r                  = TUNE_EKF_MAG_R;
            tune.ekf_mag_declination_deg    = TUNE_EKF_MAG_DECL_DEG;
            tune.ekf_mag_yaw_offset_deg     = TUNE_EKF_MAG_YAW_OFF_DEG;
            tune.ekf_mag_yaw_sign           = TUNE_EKF_MAG_YAW_SIGN;
            tune.alt_hold_kp                = TUNE_ALT_HOLD_KP;
            tune.alt_hold_kd                = TUNE_ALT_HOLD_KD;
            tune.alt_hold_max_trim          = TUNE_ALT_HOLD_MAX_TRIM;
        }

        const float MAX_ANGLE_DEG      = tune.max_angle_deg;
        const float MAX_RATE_DPS       = tune.max_rate_dps;
        const float MAX_PITCH_RATE_DPS = tune.max_pitch_rate_dps;
        float rO=0, pO=0, yO=0;
        float targetRollDeg = 0.0f, targetPitchDeg = 0.0f, targetYawDeg = 0.0f;
        float targetRollRateDps = 0.0f, targetPitchRateDps = 0.0f, targetYawRateDps = 0.0f;
        float angleErrRollDeg = 0.0f, angleErrPitchDeg = 0.0f, yawErrDeg = 0.0f;
        float rateErrRollDps = 0.0f, rateErrPitchDps = 0.0f, rateErrYawDps = 0.0f;
        float rateRollFf = 0.0f, ratePitchFf = 0.0f, rateYawFf = 0.0f;

        float rollCmd  = lpfSpRoll .apply(cmd.roll,  dt, RC_LPF_HZ);
        float pitchCmd = lpfSpPitch.apply(cmd.pitch, dt, RC_LPF_HZ);
        float yawCmd   = lpfSpYaw  .apply(cmd.yaw,   dt, RC_LPF_HZ);

        if (cmd.mode == FlightMode::ANGLE) {
            targetRollDeg = rollCmd * MAX_ANGLE_DEG;
            targetPitchDeg = pitchCmd * MAX_ANGLE_DEG;
            angleErrRollDeg = targetRollDeg - roll;
            angleErrPitchDeg = targetPitchDeg - pitch;
            targetRollRateDps = pidAngleRoll.update(angleErrRollDeg, dt);
            targetPitchRateDps = pidAnglePitch.update(angleErrPitchDeg, dt);
            rateErrRollDps = targetRollRateDps - gx;
            rateErrPitchDps = targetPitchRateDps - gy;
            rateRollFf = tune.pid_roll_ff * targetRollRateDps;
            ratePitchFf = tune.pid_pitch_ff * targetPitchRateDps;
            rO = rateRollFf + pidRateRoll.updateDOnMeasurement(rateErrRollDps, gx, dt, tune.pid_roll_d_lpf_hz);
            pO = ratePitchFf + pidRatePitch.updateDOnMeasurement(rateErrPitchDps, gy, dt, tune.pid_pitch_d_lpf_hz);
        } else {   // ACRO
            targetRollRateDps = rollCmd * MAX_RATE_DPS;
            targetPitchRateDps = pitchCmd * MAX_PITCH_RATE_DPS;
            rateErrRollDps = targetRollRateDps - gx;
            rateErrPitchDps = targetPitchRateDps - gy;
            rateRollFf = tune.pid_roll_ff * targetRollRateDps;
            ratePitchFf = tune.pid_pitch_ff * targetPitchRateDps;
            rO = rateRollFf + pidRateRoll.updateDOnMeasurement(rateErrRollDps, gx, dt, tune.pid_roll_d_lpf_hz);
            pO = ratePitchFf + pidRatePitch.updateDOnMeasurement(rateErrPitchDps, gy, dt, tune.pid_pitch_d_lpf_hz);
        }

        // Yaw: heading-hold when stick centered, rate when moving.
        if (imuOk && fabsf(yawCmd) < tune.yaw_deadband) {
            if (!g_yawHoldActive) {
                g_yawSetpoint   = yawCtrlDeg;
                g_yawHoldActive = true;
                pidAngleYaw.reset();
            }
            targetYawDeg = g_yawSetpoint;
            yawErrDeg = wrapDeg180(g_yawSetpoint - yawCtrlDeg);
            targetYawRateDps = pidAngleYaw.update(yawErrDeg, dt);
            targetYawRateDps = constrain(targetYawRateDps, -tune.yaw_max_rate_dps, tune.yaw_max_rate_dps);
            rateErrYawDps = targetYawRateDps - gz;
            rateYawFf = tune.pid_yaw_ff * targetYawRateDps;
            yO = rateYawFf + pidRateYaw.updateDOnMeasurement(rateErrYawDps, gz, dt, tune.pid_yaw_d_lpf_hz);
        } else {
            g_yawHoldActive = false;
            targetYawDeg = yawCtrlDeg;
            targetYawRateDps = -yawCmd * tune.yaw_max_rate_dps;
            rateErrYawDps = targetYawRateDps - gz;
            rateYawFf = tune.pid_yaw_ff * targetYawRateDps;
            yO = rateYawFf + pidRateYaw.updateDOnMeasurement(rateErrYawDps, gz, dt, tune.pid_yaw_d_lpf_hz);
        }

        const bool rollOutputLimited = (rO > tune.roll_output_limit) || (rO < -tune.roll_output_limit);
        const bool pitchOutputLimited = (pO > tune.pitch_output_limit) || (pO < -tune.pitch_output_limit);
        const bool yawOutputLimited = (yO > tune.yaw_output_limit) || (yO < -tune.yaw_output_limit);
        const bool rateOutputLimited = rollOutputLimited || pitchOutputLimited || yawOutputLimited;

        rO = constrain(rO, -tune.roll_output_limit,  tune.roll_output_limit);
        pO = constrain(pO, -tune.pitch_output_limit, tune.pitch_output_limit);
        yO = constrain(yO, -tune.yaw_output_limit,   tune.yaw_output_limit);

        // ── Throttle expo + smoothing ─────────────────────────
        static float thrSmooth = 0.0f;

        const float THROTTLE_EXPO              = tune.throttle_expo;
        const float THROTTLE_UP_RATE_PER_SEC   = tune.throttle_up_rate_per_sec;
        const float THROTTLE_DOWN_RATE_PER_SEC = tune.throttle_down_rate_per_sec;
        const float MOTOR_IDLE                 = tune.motor_idle;
        const float MOTOR_MAX                  = tune.motor_max;
        const float THROTTLE_CUT               = tune.throttle_cut;
        const float IDLE_RAMP_END              = tune.idle_ramp_end;

        float thrRaw = constrain(cmd.throttle, 0.0f, 1.0f);
        const bool altitudeHoldRequested = cmd.valid && cmd.swdHigh;
        const bool altitudeHoldReady =
            imuOk &&
            g_ahrsFilterModeActive == 0 &&
            tofControlValid &&
            tofControlDistanceM >= TUNE_ALT_HOLD_MIN_TOF_M &&
            tofControlDistanceM <= TUNE_ALT_HOLD_MAX_TOF_M &&
            tofEkfAgeMs <= TOF_STALE_MS &&
            ekfPv.valid &&
            isfinite(ekfPv.posZ_m) &&
            isfinite(ekfPv.velZ_mps);
        const bool altitudeHoldActive =
            altitudeHoldRequested &&
            altitudeHoldReady &&
            thrRaw > THROTTLE_CUT;

        if (altitudeHoldActive) {
            if (!altitudeHoldEngaged) {
                altitudeHoldSetpointM = ekfPv.posZ_m;
                altitudeHoldEngaged = true;
            }
            altitudeHoldErrorM = altitudeHoldSetpointM - ekfPv.posZ_m;
            const float maxTrim = constrain(tune.alt_hold_max_trim, 0.0f, 0.300f);
            altitudeHoldTrim = constrain(tune.alt_hold_kp * altitudeHoldErrorM -
                                          tune.alt_hold_kd * ekfPv.velZ_mps,
                                          -maxTrim,
                                          maxTrim);
        } else {
            altitudeHoldEngaged = false;
            altitudeHoldSetpointM = altitudeHoldReady ? ekfPv.posZ_m : 0.0f;
            altitudeHoldErrorM = 0.0f;
            altitudeHoldTrim = 0.0f;
        }

        float thrTarget = 0.0f;
        if (thrRaw > THROTTLE_CUT) {
            thrTarget = constrain(throttleExpo(thrRaw, THROTTLE_EXPO) +
                                  altitudeHoldTrim,
                                  0.0f,
                                  1.0f);
        }

        float maxStepUp   = THROTTLE_UP_RATE_PER_SEC * dt;
        float maxStepDown = THROTTLE_DOWN_RATE_PER_SEC * dt;

        if (thrTarget > thrSmooth) {
            thrSmooth += min(thrTarget - thrSmooth, maxStepUp);
        } else {
            thrSmooth -= min(thrSmooth - thrTarget, maxStepDown);
        }

        float thr = constrain(thrSmooth, 0.0f, 1.0f);

        float flPre = thr + rO - pO - yO;
        float frPre = thr - rO - pO + yO;
        float rlPre = thr + rO + pO + yO;
        float rrPre = thr - rO + pO - yO;

        float fl = flPre;
        float fr = frPre;
        float rl = rlPre;
        float rr = rrPre;

        // Desaturate high side first
        bool motorSaturated = false;
        float maxMotor = max(max(fl, fr), max(rl, rr));
        const float controlAuthorityRemaining = max(0.0f, MOTOR_MAX - maxMotor);
        if (maxMotor > MOTOR_MAX) {
            motorSaturated = true;
            float excess = maxMotor - MOTOR_MAX;
            fl -= excess; fr -= excess; rl -= excess; rr -= excess;
        }

        if (LOG_MOTOR_SATURATION && motorSaturated) {
            static uint32_t lastMotorSatPrintMs = 0;
            uint32_t motorSatNowMs = millis();
            if (motorSatNowMs - lastMotorSatPrintMs >= 250) {
                lastMotorSatPrintMs = motorSatNowMs;
                DBG_PRINTF("[MOTOR_SAT] thr=%.3f rO=%.3f pO=%.3f yO=%.3f "
                              "maxBefore=%.3f MOTOR_MAX=%.3f "
                              "FL=%.3f FR=%.3f RL=%.3f RR=%.3f\n",
                              thr, rO, pO, yO,
                              maxMotor, MOTOR_MAX,
                              fl, fr, rl, rr);
            }
        }

        float idleBlend = smoothStep01((thr - THROTTLE_CUT) / (IDLE_RAMP_END - THROTTLE_CUT));
        float motorMin = MOTOR_IDLE * idleBlend;

        if (thr > THROTTLE_CUT) {
            fl = constrain(fl, motorMin, MOTOR_MAX);
            fr = constrain(fr, motorMin, MOTOR_MAX);
            rl = constrain(rl, motorMin, MOTOR_MAX);
            rr = constrain(rr, motorMin, MOTOR_MAX);
        } else {
            fl = fr = rl = rr = 0.0f;
        }

        // ── Motor PWM update ───────────────────────────────────
        // Runs every 400 Hz control cycle so motor output tracks PID immediately.
        static uint32_t motorWriteCount = 0;
        static uint32_t lastMotorRatePrintMs = 0;

        phaseStartUs = micros();
        writeMotors(fl, fr, rl, rr);
        g_motorOutputsActive = true;
        motorWriteCount++;

        g_execTiming.lastMotorUs = micros() - phaseStartUs;

        if (LOG_MOTOR_WRITE_RATE) {
            uint32_t motorRateNowMs = millis();
            if (motorRateNowMs - lastMotorRatePrintMs >= 1000) {
                lastMotorRatePrintMs = motorRateNowMs;

                DBG_PRINTF("[MOTOR_RATE] target=400Hz writes=%lu lastMotorUs=%lu\n",
                              (unsigned long)motorWriteCount,
                              (unsigned long)g_execTiming.lastMotorUs);

                motorWriteCount = 0;
            }
        } else {
            motorWriteCount = 0;
        }

        uint32_t controlDoneUs = micros();


        const float magNorm_uT = imuOk ? sqrtf(s.mx_uT*s.mx_uT + s.my_uT*s.my_uT + s.mz_uT*s.mz_uT) : 0.0f;
        const float rpmScaleLog = MOTOR_KV * batteryVoltageForRpm;
        const float cmdRpmFL = fl * rpmScaleLog;
        const float cmdRpmFR = fr * rpmScaleLog;
        const float cmdRpmRL = rl * rpmScaleLog;
        const float cmdRpmRR = rr * rpmScaleLog;

        // ── High-speed flight log @ 100 Hz (every 4th cycle) ──
        static uint8_t logDiv = 0;
        if (++logDiv >= 4) {
            logDiv = 0;
            LoggerRow row;
            memset(&row, 0, sizeof(row));
            row.t_us = nowUs;
            row.loop_count = g_state.loopCount;
            auto clampU16 = [](uint32_t v) -> uint16_t {
                return (uint16_t)((v > 65535UL) ? 65535UL : v);
            };
            row.period_us = clampU16(periodUs);
            row.jitter_us = (int16_t)constrain((int32_t)periodUs - (int32_t)TARGET_US, -32768, 32767);
            row.control_exec_us = clampU16(controlDoneUs - execStartUs);
            row.imu_read_us = clampU16(g_execTiming.lastImuUs);
            row.rc_read_us = clampU16(g_execTiming.lastRcUs);
            row.ahrs_exec_us = 0;
            row.pid_exec_us = 0;
            row.motor_exec_us = clampU16(g_execTiming.lastMotorUs);
            row.mode = (uint8_t)cmd.mode;
            row.flags = ((cmd.mode != FlightMode::DISARMED) ? 0x0001 : 0)
                      | (imuOk ? 0x0002 : 0)
                      | (cmd.valid ? 0x0004 : 0)
                      | ((imuOk && imu.isMagConnected()) ? 0x0008 : 0)
                      | (motorSaturated ? 0x0010 : 0)
                      | (g_state.rpmActualValid ? 0x0020 : 0);

            row.throttle = cmd.throttle;
            row.rc_roll = rollCmd;
            row.rc_pitch = pitchCmd;
            row.rc_yaw = yawCmd;
            row.target_roll_deg = targetRollDeg;
            row.target_pitch_deg = targetPitchDeg;
            row.target_yaw_deg = targetYawDeg;
            row.target_roll_rate_dps = targetRollRateDps;
            row.target_pitch_rate_dps = targetPitchRateDps;
            row.target_yaw_rate_dps = targetYawRateDps;

            row.ekf_roll_deg = imuOk ? att.roll_deg : 0.0f;
            row.ekf_pitch_deg = imuOk ? att.pitch_deg : 0.0f;
            row.ekf_yaw_deg = imuOk ? att.yaw_deg : 0.0f;
            row.ctrl_roll_deg = roll;
            row.ctrl_pitch_deg = pitch;
            row.ctrl_yaw_deg = imuOk ? yawCtrlDeg : 0.0f;
            row.zero_roll_deg = g_levelRollOffsetDeg;
            row.zero_pitch_deg = g_levelPitchOffsetDeg;
            row.zero_yaw_deg = g_levelYawOffsetDeg;

            row.ax_g = imuOk ? s.ax_g : 0.0f;
            row.ay_g = imuOk ? s.ay_g : 0.0f;
            row.az_g = imuOk ? s.az_g : 0.0f;
            row.gx_dps = imuOk ? s.gx_dps : 0.0f;
            row.gy_dps = imuOk ? s.gy_dps : 0.0f;
            row.gz_dps = imuOk ? s.gz_dps : 0.0f;
            row.mx_uT = imuOk ? s.mx_uT : 0.0f;
            row.my_uT = imuOk ? s.my_uT : 0.0f;
            row.mz_uT = imuOk ? s.mz_uT : 0.0f;
            row.accel_norm_g = sqrtf(row.ax_g*row.ax_g + row.ay_g*row.ay_g + row.az_g*row.az_g);
            row.gyro_norm_dps = sqrtf(row.gx_dps*row.gx_dps + row.gy_dps*row.gy_dps + row.gz_dps*row.gz_dps);
            row.mag_norm_uT = sqrtf(row.mx_uT*row.mx_uT + row.my_uT*row.my_uT + row.mz_uT*row.mz_uT);
            row.ekf_bgx_dps = attitudeEKF.rollBiasDps();
            row.ekf_bgy_dps = attitudeEKF.pitchBiasDps();
            row.ekf_bgz_dps = attitudeEKF.yawBiasDps();
            row.ahrs_mode = g_ahrsFilterModeActive;
            row.ekf_mag_used = attitudeEKF.lastMagAccepted() ? 1 : 0;

            row.angle_roll_error_deg = angleErrRollDeg;
            row.angle_pitch_error_deg = angleErrPitchDeg;
            row.yaw_error_deg = yawErrDeg;
            row.rate_roll_error_dps = rateErrRollDps;
            row.rate_pitch_error_dps = rateErrPitchDps;
            row.rate_yaw_error_dps = rateErrYawDps;

            row.angle_roll_p = pidAngleRoll.lastP;
            row.angle_roll_i = pidAngleRoll.lastI;
            row.angle_roll_d = pidAngleRoll.lastD;
            row.angle_roll_out = targetRollRateDps;
            row.angle_pitch_p = pidAnglePitch.lastP;
            row.angle_pitch_i = pidAnglePitch.lastI;
            row.angle_pitch_d = pidAnglePitch.lastD;
            row.angle_pitch_out = targetPitchRateDps;
            row.angle_yaw_p = pidAngleYaw.lastP;
            row.angle_yaw_i = pidAngleYaw.lastI;
            row.angle_yaw_d = pidAngleYaw.lastD;
            row.angle_yaw_out = targetYawRateDps;

            row.rate_roll_p = pidRateRoll.lastP;
            row.rate_roll_i = pidRateRoll.lastI;
            row.rate_roll_d = pidRateRoll.lastD;
            row.rate_roll_out = rO;
            row.rate_pitch_p = pidRatePitch.lastP;
            row.rate_pitch_i = pidRatePitch.lastI;
            row.rate_pitch_d = pidRatePitch.lastD;
            row.rate_pitch_out = pO;
            row.rate_yaw_p = pidRateYaw.lastP;
            row.rate_yaw_i = pidRateYaw.lastI;
            row.rate_yaw_d = pidRateYaw.lastD;
            row.rate_yaw_out = yO;

            row.motor_fl_pre = flPre;
            row.motor_fr_pre = frPre;
            row.motor_rl_pre = rlPre;
            row.motor_rr_pre = rrPre;
            row.motor_fl = fl;
            row.motor_fr = fr;
            row.motor_rl = rl;
            row.motor_rr = rr;
            row.motor_diag_a = fl + rr;
            row.motor_diag_b = fr + rl;
            row.motor_diag_diff = row.motor_diag_a - row.motor_diag_b;

            row.rpm_fl = cmdRpmFL;
            row.rpm_fr = cmdRpmFR;
            row.rpm_rl = cmdRpmRL;
            row.rpm_rr = cmdRpmRR;
            row.rpm_diag_a = cmdRpmFL + cmdRpmRR;
            row.rpm_diag_b = cmdRpmFR + cmdRpmRL;
            row.rpm_diag_diff = row.rpm_diag_a - row.rpm_diag_b;

            row.battery_v = batteryVoltageForRpm;
            row.cpu0_pct = g_state.cpuCore0_pct;
            row.cpu1_pct = g_state.cpuCore1_pct;
            row.notch_freq_hz = tune.notch_freq_hz;
            row.notch_q = tune.notch_q;
            row.notch_enable = tune.notch_enable ? 1 : 0;
            row.bmp_alt_m = g_state.bmpAltitude_m;
            row.bmp_vz_mps = g_state.bmpVerticalSpeed_mps;
            row.tof_distance_m = g_state.tofDistance_m;
            row.tof_distance_mm = g_state.tofDistance_mm;
            row.tof_range_status = g_state.tofRangeStatus;
            row.tof_object_count = g_state.tofObjectCount;
            row.tof_stream_count = g_state.tofStreamCount;
            row.tof_signal_mcps = g_state.tofSignalMcps;
            row.tof_ambient_mcps = g_state.tofAmbientMcps;
            row.tof_age_ms = clampU16(g_state.tofAge_ms);
            row.tof_last_update_ms = g_state.tofLastUpdate_ms;
            row.tof_ready = g_state.tofReady ? 1 : 0;
            row.tof_valid = g_state.tofValid ? 1 : 0;
            row.ekf_pos_z_m = ekfPv.valid ? ekfPv.posZ_m : 0.0f;
            row.ekf_vel_z_mps = ekfPv.valid ? ekfPv.velZ_mps : 0.0f;
            row.tof_ekf_age_ms = clampU16(tofEkfAgeMs);
            row.tof_ekf_velocity_accepted = tofEkfVelocityAccepted ? 1 : 0;
            row.altitude_hold_requested = altitudeHoldRequested ? 1 : 0;
            row.altitude_hold_ready = altitudeHoldReady ? 1 : 0;
            row.altitude_hold_active = altitudeHoldActive ? 1 : 0;
            row.altitude_hold_setpoint_m = altitudeHoldSetpointM;
            row.altitude_hold_error_m = altitudeHoldErrorM;
            row.altitude_hold_throttle_trim = altitudeHoldTrim;
            row.gps_valid = g_state.gps.valid ? 1 : 0;
            row.gps_sats = g_state.gps.satellites;
            row.gps_hdop = g_state.gps.hdop;

            uint32_t logStartUs = micros();
            flightLogger.push(row);
            g_execTiming.lastLogUs = micros() - logStartUs;
        }
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
void loop() { vTaskDelay(portMAX_DELAY); }
