durveshpathak1989/ESP32-FlightStack/RC_FlightController/src/Services/Diagnostics/Logger/Logger.h

/*
 * Name: Logger.h
 * Use: High-speed diagnostic flight logger for EKF, target tracking,
 *      PID terms, motor saturation, sensor quality, timing, and Paper A data.
 * Version: 1.1.0
 * Baseline: ESP32-FlightStack firmware v5.0.0
 */

#pragma once
#ifndef LOGGER_H
#define LOGGER_H

#include <Arduino.h>
#include <string.h>
#include "freertos/FreeRTOS.h"
#include "freertos/portmacro.h"
#include "../../../App/Estimation/EKF/AttitudeEKF.h"

#ifndef LOGGER_DEFAULT_CAPACITY
#define LOGGER_DEFAULT_CAPACITY 600U   // 100 Hz x 6 s default
#endif

// Latest EKF rate-state snapshot. It is published immediately after each
// AttitudeEKF::update() and copied into the 100 Hz LoggerRow at push time.
struct LoggerEkfRateSnapshot {
    float roll_rate_dps;
    float pitch_rate_dps;
    float yaw_rate_dps;
    uint32_t sequence;
    bool valid;
};

void loggerPublishEkfRateSnapshot(float rollRateDps,
                                  float pitchRateDps,
                                  float yawRateDps,
                                  bool valid);
LoggerEkfRateSnapshot loggerReadEkfRateSnapshot();

// Instrument only the flight-controller-owned EKF object without changing the
// EKF math or control signal. Logger.h is included before the global EKF object
// declaration in RC_FlightController.ino, so the alias below makes that object
// this thin derived type. Calls remain API-compatible with AttitudeEKF.
class LoggerInstrumentedAttitudeEKF : public AttitudeEKF {
public:
    bool update(const AHRSInput& in, float dt, AttitudeEstimate& out) {
        const bool ok = AttitudeEKF::update(in, dt, out);
        const BodyRateEstimate& rates = bodyRates();
        loggerPublishEkfRateSnapshot(rollRateDps(),
                                     pitchRateDps(),
                                     yawRateDps(),
                                     ok && rates.valid);
        return ok;
    }

    void reset() {
        AttitudeEKF::reset();
        loggerPublishEkfRateSnapshot(0.0f, 0.0f, 0.0f, false);
    }
};

// Deliberately scoped to the flight-controller translation unit. This does not
// replace or modify the EKF implementation; it only records its public outputs.
#ifndef LOGGER_DISABLE_EKF_RATE_INSTRUMENTATION
#define AttitudeEKF LoggerInstrumentedAttitudeEKF
#endif

struct LoggerRow {
    uint32_t t_us;
    uint32_t loop_count;
    uint16_t period_us;
    int16_t  jitter_us;
    uint16_t control_exec_us;
    uint16_t imu_read_us;
    uint16_t rc_read_us;
    uint16_t ahrs_exec_us;
    uint16_t pid_exec_us;
    uint16_t motor_exec_us;
    uint8_t  mode;        // 0=DISARMED, 1=ANGLE, 2=ACRO, 3=FAILSAFE
    uint16_t flags;       // bit0 armed, bit1 imuOk, bit2 rcValid, bit3 magValid, bit4 motorSat, bit5 rpmActualValid

    // Pilot/target tracking
    float throttle;
    float rc_roll;
    float rc_pitch;
    float rc_yaw;
    float target_roll_deg;
    float target_pitch_deg;
    float target_yaw_deg;
    float target_roll_rate_dps;
    float target_pitch_rate_dps;
    float target_yaw_rate_dps;

    // EKF/AHRS and post-zero control attitude
    float ekf_roll_deg;
    float ekf_pitch_deg;
    float ekf_yaw_deg;
    float ctrl_roll_deg;
    float ctrl_pitch_deg;
    float ctrl_yaw_deg;
    float zero_roll_deg;
    float zero_pitch_deg;
    float zero_yaw_deg;

    // Sensor quality / Paper A observability
    float ax_g;
    float ay_g;
    float az_g;
    float gx_dps;
    float gy_dps;
    float gz_dps;
    float mx_uT;
    float my_uT;
    float mz_uT;
    float accel_norm_g;
    float gyro_norm_dps;
    float mag_norm_uT;
    float ekf_bgx_dps;
    float ekf_bgy_dps;
    float ekf_bgz_dps;

    // Rate-signal comparison. The feedback signal is reconstructed exactly as
    // targetRate - rateError from the same control cycle. With the current
    // feedback gate disabled, it is the notch + 50 Hz LPF gyro signal.
    float feedback_roll_rate_dps;
    float feedback_pitch_rate_dps;
    float feedback_yaw_rate_dps;
    float bias_corrected_roll_rate_dps;
    float bias_corrected_pitch_rate_dps;
    float bias_corrected_yaw_rate_dps;
    float ekf_roll_rate_dps;
    float ekf_pitch_rate_dps;
    float ekf_yaw_rate_dps;
    uint8_t ekf_rate_valid;

    uint8_t ahrs_mode;
    uint8_t ekf_mag_used;

    // Errors
    float angle_roll_error_deg;
    float angle_pitch_error_deg;
    float yaw_error_deg;
    float rate_roll_error_dps;
    float rate_pitch_error_dps;
    float rate_yaw_error_dps;

    // PID term breakdown
    float angle_roll_p;
    float angle_roll_i;
    float angle_roll_d;
    float angle_roll_out;
    float angle_pitch_p;
    float angle_pitch_i;
    float angle_pitch_d;
    float angle_pitch_out;
    float angle_yaw_p;
    float angle_yaw_i;
    float angle_yaw_d;
    float angle_yaw_out;
    float rate_roll_p;
    float rate_roll_i;
    float rate_roll_d;
    float rate_roll_out;
    float rate_pitch_p;
    float rate_pitch_i;
    float rate_pitch_d;
    float rate_pitch_out;
    float rate_yaw_p;
    float rate_yaw_i;
    float rate_yaw_d;
    float rate_yaw_out;

    // Mixer / actuator authority
    float motor_fl_pre;
    float motor_fr_pre;
    float motor_rl_pre;
    float motor_rr_pre;
    float motor_fl;
    float motor_fr;
    float motor_rl;
    float motor_rr;
    float motor_diag_a;
    float motor_diag_b;
    float motor_diag_diff;

    // RPM / thrust proxy
    float rpm_fl;
    float rpm_fr;
    float rpm_rl;
    float rpm_rr;
    float rpm_diag_a;
    float rpm_diag_b;
    float rpm_diag_diff;

    // Paper A system context
    float battery_v;
    float cpu0_pct;
    float cpu1_pct;
    float notch_freq_hz;
    float notch_q;
    uint8_t notch_enable;
    float bmp_alt_m;
    float bmp_vz_mps;
    float tof_distance_m;
    uint16_t tof_distance_mm;
    uint8_t tof_range_status;
    uint8_t tof_object_count;
    uint8_t tof_stream_count;
    float tof_signal_mcps;
    float tof_ambient_mcps;
    uint16_t tof_age_ms;
    uint32_t tof_last_update_ms;
    uint8_t tof_ready;
    uint8_t tof_valid;
    float ekf_pos_z_m;
    float ekf_vel_z_mps;
    uint16_t tof_ekf_age_ms;
    uint8_t tof_ekf_velocity_accepted;
    uint8_t altitude_hold_requested;
    uint8_t altitude_hold_ready;
    uint8_t altitude_hold_active;
    float altitude_hold_setpoint_m;
    float altitude_hold_error_m;
    float altitude_hold_throttle_trim;
    uint8_t gps_valid;
    uint8_t gps_sats;
    float gps_hdop;
};

class Logger {
public:
    explicit Logger(uint16_t capacity = LOGGER_DEFAULT_CAPACITY);
    ~Logger();

    bool begin();
    void reset();
    void freeze();
    void resume();
    bool push(const LoggerRow& row);

    uint16_t countAndFreeze();
    uint16_t capacity() const { return _capacity; }
    bool isFrozen() const { return !_active; }

    String csvHeader() const;
    String csvRow(uint16_t chronologicalIndex) const;
    String statusJson() const;

private:
    LoggerRow* _rows;
    uint16_t _capacity;
    volatile uint16_t _head;
    volatile bool _full;
    volatile bool _active;
    volatile uint32_t _dropped;
    portMUX_TYPE _mux;

    uint16_t _availableUnsafe() const;
    uint16_t _mapChronologicalIndex(uint16_t chronologicalIndex) const;
    static void _appendFloat(String& s, float v, uint8_t dp);
};

#endif // LOGGER_H
