durveshpathak1989/ESP32-FlightStack/(commit log)

2026-05-16 05/15/2026 - Commit for BMP sensor Lib
2026-05-16 05/16/2026 - Commit for improved groundstation and flight controller
    [StudSpacer-10mm.stl, StudSpacer-20mm.stl, StudSpacer-30mm.stl, StudSpacer-5mm.stl]
2026-05-16 05/16/2026 - Commit for PCB
    [IOMatrix.xlsx]
2026-05-18 05/18/2026 - Commit for Motor controls
2026-05-18 05/18/2026 - Commit for fixing the WiFi Telemetry stack t0 12288
    [RC_FlightController.ino]
2026-05-18 05/18/2026 - Commit for including Motor Control Lib
2026-05-28 Fix for RC hz reading frame rates
    [FlySkyiBUS.cpp]
2026-06-03 PID Tuning reduced gain cahnged calibration conventions
2026-06-04 PID Tuning and Throttle Smoothening added + motor Idle Floor added
2026-06-04 Adding LPF for throttle and Gyro and improved oscillations
    [RC_FlightController.ino]
2026-06-07 First Stable ACRO flight - Groundstation Precision Update
2026-06-08 Enabling OTA feature and adding precompiled bin Files + Adding Updated GSC to handle all the tuning parameters.
    [partitions.csv]
2026-06-10 Update RC_FlightController.ino
    PID tuning updates after crash
    [RC_FlightController.ino]
2026-06-10 Bin File to be commited.
    Binary file For PID Tuning after the Crash
2026-06-13 Fixes for Jitter issue sof control task
    [RC_FlightController.ino]
2026-06-13 Fixies Jitter Issue
2026-06-14 Fixies Jitter Issue Telemettry issue and tunning Issue fix
2026-06-18 Spectrum Analyser added for motor Vibration
2026-06-23 Added Dynamic Notch Filter
2026-06-24 Added Dynamic Notch Filter 2nd flight
2026-06-24 Fix flight timing stability build issues
    [CalibrationManager.h, MotorControl.cpp, RC_FlightController.ino, TelemetryWiFi.h]
2026-06-24 Gate Serial prints behind VERNOSE_ON
2026-06-24 Restructure sketch for Arduino auto compile
2026-06-24 Move filters into Arduino src and add build binaries
2026-06-24 Remove top-level Arduino build cache
    [partitions.csv]
2026-06-26 Fix WiFi CSV telemetry zeros
    [RC_FlightController.ino]
2026-06-26 Update flight tuning calibration defaults
2026-06-26 Align GCS calibration defaults
2026-06-26 Add magnetometer health log fields
2026-06-26 Show calibration manager in system log
2026-06-26 Set default motor max to full output
2026-06-26 Allow full motor output and scroll GCS tabs
2026-06-26 Build firmware with full motor output
2026-06-28 Revert dynamic notch response tuning
    [RC_FlightController.ino]
2026-06-30 Wire VL53L4CX ToF driver
2026-06-30 Read ToF sensor on core 0
2026-06-30 Print ToF object count in status
2026-07-01 Update flight calibration defaults
2026-07-01 Use gyro derivative and rate feed-forward
2026-07-01 Run motor outputs at control rate
2026-07-01 Rebuild binaries for 400hz motor output
2026-07-02 Tune dynamic notch and EKF accel noise
    [RC_FlightController.ino]
2026-07-09 Add measured battery telemetry and GCS display
2026-07-09 Rebuild firmware binaries for battery telemetry
2026-07-22 Add production-intent ESP32 flight controller PCB
    [BOM-jlcpcb.csv, BOM.csv, CONTROLLED_PARTS.csv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]
2026-07-27 Tune roll and pitch rate gains
2026-07-27 Reduce EKF accelerometer trust
2026-08-03 Release calibrated flight tuning v6.0.0
2026-08-05 Track experimental full-state EKF branch
2026-08-05 Pin integration branch to ToF-aided 18-state EKF
2026-08-05 Document full-state EKF and ToF control-task wiring
2026-08-05 Automate 18-state EKF wiring and firmware build
2026-08-05 Add ESP32 Arduino compile workflow
2026-08-05 Verify exact ESP32 Dev Module target in CI
2026-08-05 ci: publish ESP32 firmware for 1feab15f65f4 [skip ci]
2026-08-05 Match CI binaries to exact ESP32 release configuration
2026-08-05 ci: publish ESP32 release and debug firmware for fe628a36e1ae [skip ci]
2026-08-05 Add EKF gyro-rate comparison fields to flight logger
2026-08-05 Publish raw filtered bias-corrected and EKF rates in CSV
    [Logger.cpp]
2026-08-05 Document gyro-rate comparison log channels
2026-08-05 ci: publish ESP32 release and debug firmware for 542030f8b53d [skip ci]
2026-08-05 Persist runtime tuning to ESP32 NVS
2026-08-05 ci: publish ESP32 release and debug firmware for 6f14b768d1d4 [skip ci]
2026-08-05 ci: publish ESP32 release and debug firmware for 7cd155ce965c [skip ci]
2026-08-22 Add ToF logging and altitude hold wiring
2026-08-22 ci: publish ESP32 release and debug firmware for ff076b36bb61 [skip ci]
2026-08-22 ci: publish ESP32 release and debug firmware for a39bfdf00c06 [skip ci]
2026-08-22 ci: publish ESP32 release and debug firmware for 0186254eb1c0 [skip ci]
2026-08-22 ci: publish ESP32 release and debug firmware for d3cae64f6017 [skip ci]
2026-08-22 ci: publish ESP32 release and debug firmware for e3aa0521101f [skip ci]
2026-08-23 refactor: vendor submodules into AUTOSAR-style layered architecture
    Replace the 16 git submodules under src/Submodules with vendored
    sources reorganized into strict layers (dependencies point downward
    only):
    - App/ flight algorithms: PID, notch filter, EKF/AHRS/
    Mahony/Madgwick estimators
    - Services/ telemetry+OTA comms, calibration, FFT service,
    logger/diagnostics/CPU monitor
    - EcuAbstraction/ sensor drivers (IMU, BMP280, GPS, ToF), motor
    control, iBUS receiver, battery monitor
    - Mcal/ ESP32 Arduino Core API boundary (documented)
    - Core/ + Cfg/ portable types, port contracts, config
    Key extractions:
    - MPU_RawData / MPU_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
    [BMP280Sensor.cpp, BMP280Sensor.h, BatteryMonitor.h, CalibrationManager.cpp]
2026-08-23 fix: correct Services-layer include depth; move DEG2RAD/RAD2DEG to Core
    - CalibrationManager.cpp and TelemetryWiFi.cpp needed two parent
    steps (not one) to reach Services/Diagnostics/DebugConfig
    - DEG2RAD / RAD2DEG moved from the IMU driver header into
    Core/ImuTypes.h: MahonyAHRS previously received them transitively
    through the driver include, which the layer refactor removed
    Verified locally with arduino-cli 1.5.1 + esp32:esp32@3.3.8, same
    FQBN as CI:
    Sketch uses 1158207 bytes (58%); Global variables 77596 bytes (23%)
    Also adds scripts/build_local.ps1 mirroring the CI compile command.
    [CalibrationManager.cpp, ImuTypes.h, MPU9250.h, TelemetryWiFi.cpp]
